tennessee-garage/dance-more/README.md

# dance-more
The next generation of the dancefloor

To get the repo running on your own machine (no floor needed), start with
[docs/getting-started.md](docs/getting-started.md).

Design docs live in [docs/](docs/README.md). To write an animation for the floor, start with [docs/animations.md](docs/animations.md).
