tennessee-garage/dance-more/docs/README.md

# Dance Floor v2 — Design & Architecture

A portable, light-up dance floor built from an 8×8 grid of independently
addressable acrylic **tiles**, driven by a layered controller hierarchy.

This `docs/` folder is the design home for the project. It is written to grow
incrementally — sections marked **Open Question** or **TBD** are deliberate
placeholders to be resolved as the design firms up.

## Contents

| Document | Covers |
| --- | --- |
| [architecture.md](architecture.md) | System overview, control hierarchy, block diagram, key counts |
| [communication.md](communication.md) | Bus topologies, RS-485 layering, addressing, SENSE auto-mapping protocol |
| [row-bus-protocol.md](row-bus-protocol.md) | Row Bus (Pi ↔ Row Controller) command protocol: frame format, command set, timing |
| [tile-bus-protocol.md](tile-bus-protocol.md) | Tile Bus (Row Controller ↔ Tile) command protocol: frame format, command set, timing |
| [tile-effects.md](tile-effects.md) | `SET_EFFECT` ids and parameters: tile-local effects over host pixel data, and why they exist |
| [external-input.md](external-input.md) | Driving the floor from outside: Art-Net / sACN pictures (modes, universes, orientation, takeover), the DMX control block, OSC, MIDI (the APC mini map, learn, the mapping file) and beat sync |
| [resolume.md](resolume.md) | A step-by-step guide for Resolume: visuals on the floor (Arena's DMX output), mixing with the floor's show, Ableton Link, and show control alongside |
| [touchdesigner.md](touchdesigner.md) | A step-by-step guide for TouchDesigner: pictures, the DMX control block, the HTTP API and Ableton Link, with an example show |
| [animations.md](animations.md) | Writing animations for the Pi driver: the contract, the two frame formats, the cell model, edges and the edge graph, params, the authoring loop |
| [hardware-tile.md](hardware-tile.md) | Tile: wood frame, acrylic, WS2815 LEDs, ATtiny3226, connectors |
| [hardware-row-controller.md](hardware-row-controller.md) | Row controller: Xiao RP2350, dual RS-485 buses, connectors |
| [power.md](power.md) | 12 V distribution and daisy-chain power architecture |
| [glossary.md](glossary.md) | Shared terminology |

## Repository map (current)

| Path | Purpose |
| --- | --- |
| `pcb/tile/` | KiCad project for the original tile controller PCB (ATtiny3224) |
| `pcb/tile-pcba/` | KiCad project for the JLCPCB-assembled tile PCB (ATtiny3226) — current |
| `pcb/row-controller/` | KiCad project for the row controller PCB |
| `src/tile/DF2-Tile/` | PlatformIO firmware for the ATtiny3226 tile controller |
| `src/simulation/` | Three.js/TypeScript acrylic light-propagation simulator |
| `src/native-simulator/` | Python (pyglet/numpy) light-propagation simulator |
| `docs/` | This design documentation |
