tennessee-garage/dance-more/pcb/tile/images/v1.2/tile-B_Silkscreen.pdf

A B

2026-06-18 v1.2 GND 12V GND Sin Sout

## Tile Dancefloor2

C6 R1 C5 R2
