tennessee-garage/dance-more/docs/external-input.md

# Driving the floor from a media server or a lighting desk

The floor listens for **Art-Net** (UDP 6454) and **sACN / E1.31** (UDP 5568,
unicast or multicast), so Resolume Arena, TouchDesigner, a lighting desk or
anything else that pixel-maps over DMX can send it pixels; and for **OSC**
(UDP 7000) and **MIDI**, so the same programs - and hardware controllers -
can run its show controls. Everything below is set in the web UI's
**External** tab (`df2-pi serve`), and stored.

## Network

- **Wire the Pi into the lighting network.** Art-Net over Wi-Fi drops and
  stutters.
- Point the sender at the Pi's IP (unicast), or use broadcast. For sACN,
  multicast works too: the floor joins the group of every universe it
  listens to.
- The floor answers **ArtPoll**, so it appears in a sender's node list as
  "Dance Floor". The node report shows the mode and universe count.

## Choosing a mode

| Mode | What the sender sends | Universes | Use it when |
| --- | --- | --- | --- |
| **Tile** (default) | 64 RGB pixels: one colour per tile | 1 | You want it working in five minutes. An 8×8 fixture grid in any software |
| **Grid** | A W×H RGB image (default 34×34); the floor samples it at each LED | ⌈W·H / 170⌉ (34×34: 7) | Video content. Resolume's pixel map as a plain grid |
| **Raw** | Every LED, 3,840 RGB pixels in chain order | 23 | Exact per-LED control (TouchDesigner with the LED table) |

Pixels pack **170 to a universe** (510 channels) and never straddle one.
Universes run consecutively from the **first universe** you set: Art-Net
counts port-addresses from 0, sACN universes from 1.

**Orientation.** Tile and grid are raster order starting at the **top-left of
the floor as the preview shows it**. The preview puts the Pi's edge at the
bottom, so the first pixel is the far corner on the left. If the floor is
rotated (Settings → rotation), the picture turns with it, so a sender never
needs to know.

**Colour.** Values are used as sent: they are already gamma-encoded, as video
is. Leave the sender's output gamma or colour correction at 1.0 / off, or the
floor applies gamma twice.

## Source: what the floor shows

| Source | While there is signal | When the signal stops |
| --- | --- | --- |
| **External** (default) | The sender's picture takes over the floor | After the **timeout** (default 2 s), the playlist entry that was playing restarts |
| **Mix** | The sender's picture over the playlist, faded in by **Mix** | The picture is removed; the playlist carries on |
| **Internal** | Ignored | — |

A crashed or sleeping sender therefore never leaves the floor frozen or dark.
Brightness, blackout, the show controls (strobe, tint, …) and rotation all
apply to external content exactly as to the floor's own animations.

"External" is also an ordinary animation (id `external`), so you can put it in
a playlist or run it as a layer by hand. It shows the last frame received.

## Resolume Arena

**[resolume.md](resolume.md) is a step-by-step guide**: visuals on the floor,
mixing with its show, Ableton Link and show control, with the settings to
make. In short:

Arena, not Avenue: only Arena has DMX output.

1. In Arena's advanced output, add a DMX / Lumiverse output to the floor's IP
   (Art-Net, or sACN).
2. For **tile** mode, add a fixture of 64 RGB pixels, laid out 8×8. For
   **grid** mode, lay out W×H pixels to match the External tab (34×34 by
   default). Pixel order runs left to right and top to bottom, from the top-left.
3. Set the fixture's universe to the External tab's first Art-Net universe
   (0 by default).
4. Place the fixture over the part of the composition the floor should show.

Content advice: only about 21% of the floor's cells are LEDs (each tile is a
ring of 60 with a dark centre). Large soft shapes and colour fields read well;
thin lines and text disappear between the rings.

## TouchDesigner

**[touchdesigner.md](touchdesigner.md) is a step-by-step guide**: pictures,
the control block, the HTTP API and tempo, with networks to build. In short:

Use a **DMX Out CHOP** (Art-Net or sACN) at the floor's IP.

- **Tile / grid:** Resize the TOP to 8×8 (tile) or W×H (grid), then **TOP to
  CHOP** with RGB channels interleaved in raster order from the top-left. TOP
  to CHOP reads rows bottom-up by default, so flip vertically first.
- **Raw:** Download the LED table (External tab, or `df2-pi leds > leds.csv`).
  It lists every LED in wire order with `u,v` (0–1, origin bottom-left, which
  is TouchDesigner's texture convention) and its universe and channel. Sample
  your TOP at those `u,v` positions and send the result in `index` order.

## Lighting desk control

The floor can also be patched as an **18-channel fixture**, so a desk (grandMA,
Chamsys, QLC+) or a media server's DMX output can dim it, strobe it and pick
programs. It is **off by default**: turn it on in the External tab's DMX
control section and set its universe (Art-Net and sACN separately) and start
address (default 201).

| Ch | Function | Values |
| --- | --- | --- |
| 1 | Master dimmer | 0 dark .. 255 full |
| 2 | Strobe | 0 off, 1..255 up to the strobe cap (Settings, default 10 Hz) |
| 3 | Source | 0–84 internal, 85–169 external, 170–255 mix |
| 4 | External mix | how much of the sender's picture, in mix |
| 5 | Bank | playlist N, **in name order**, from 0 |
| 6 | Program | entry N of that playlist, from 0 |
| 7 | Speed | 0 stop, 128 = 1×, 255 = 4× |
| 8–11 | Macro 1–4 | the playing animation's macros |
| 12–14 | Tint red, green, blue | the tint colour |
| 15 | Tint amount | 0 off .. 255 fully the tint |
| 16 | Bump | a white flash of value/255 each time it rises |
| 17 | Hold | 0–127 the countdown runs, 128–255 the playing entry plays on (the web UI's Hold) |
| 18 | Palette | the floor palette: N counts the built-ins in order (rainbow, fire, ice, ocean, sunset, forest, neon, candy, night), then your own by name |

- **Continuous controls follow the faders.** Dimmer, strobe, source, mix,
  speed and tint take effect on the first packet, then on every change.
- **Triggers act only on change.** Bank, program, macros, bump and palette never act on
  the first packet, so a desk that connects with them at 0 doesn't reload the
  playlist or flash the floor. Changing either bank or program goes to that
  entry.
- **Hold acts on crossing 128.** On the first packet it acts only if it is
  up, so a desk connecting with it down doesn't release a hold set from the
  web UI. Released, the entry finishes what was left of its countdown.
- **When the desk goes quiet for the timeout** (the same one as the pixels),
  dimmer, strobe, speed, tint, source and mix return to their settings, and
  a hold the desk applied is released. What bank and program loaded stays
  loaded.
- **Keep it out of a pixel universe.** A media server sending tile mode
  usually sends all 512 channels, zeros included, and zero on channel 1
  blacks out the floor. The External tab warns when the two share a universe.

For QLC+, import [fixtures/dance-floor-v2.qxf](fixtures/dance-floor-v2.qxf)
(`df2-pi fixture` regenerates it from the code). For other desks, build a
18-channel generic fixture from the table above.

## OSC

The floor also takes **OSC** on **UDP port 7000** - TouchDesigner's native
control protocol, something Resolume can send, and what phone apps like
TouchOSC speak. It covers the floor's show controls and more: send a message
to the floor's address and it acts. It is on by default; the External tab's
**OSC** section turns it off, changes the port, and shows the last 20
messages received - with any the floor didn't understand marked - which is
the quickest way to see what a sender is actually sending.

| Address | Values | Does |
| --- | --- | --- |
| `/floor/brightness` | f | Master brightness |
| `/floor/blackout` | on | Black out, or lift it |
| `/floor/speed` | f | 0 stopped, 0.5 normal, 1 four times |
| `/floor/strobe` | f | 0 off … 1 the strobe cap |
| `/floor/bump` | [f] | A flash toward white, as strong as f (1 if none) |
| `/floor/tint` | r g b amount | Tint toward a colour, each 0..1 |
| `/floor/hue` | f | Turn every hue, in turns |
| `/floor/saturation` | f | 0 grey, 0.5 normal, 1 vivid |
| `/floor/freeze` | on | Hold the picture while time runs on |
| `/floor/hold` | on | Keep the playing animation until released |
| `/floor/reset` | press | Show controls back to normal |
| `/floor/source` | f or s | Thirds - internal, external, mix - or the name |
| `/floor/mix` | f | How much external picture, in mix |
| `/floor/next`, `/floor/previous`, `/floor/restart` | press | Move through the playlist |
| `/floor/goto` | i | Go to playlist entry i (from 0) |
| `/floor/goto/<entry>` | press | The same, with the entry in the address |
| `/floor/playlist` | i or s | Load a playlist by id or name |
| `/floor/playlist/<name>` | press | The same, by address |
| `/floor/play` | s | Play an animation by id (`waves`, `lightning`, …) |
| `/floor/play/<animation>` | press | The same, by address |
| `/floor/palette` | i or s | The floor palette: its number in the Palettes tab, or its name |
| `/floor/palette/<name>` | press | The same, by address |
| `/floor/param/<name>` | f | The playing animation's parameter, 0..1 across its range |
| `/floor/macro/<n>` | f | The playing animation's macro 1–4 |
| `/floor/trigger` | i [f] | Trigger slot i, velocity f (1 if none; 0 is ignored) |
| `/floor/trigger/<slot>` | [f] | The same, by address |
| `/floor/tempo/tap`, `/floor/tempo/resync` | press | Tap tempo; make the next beat a downbeat |
| `/floor/tempo/nudge` | f | Shift the beat by f milliseconds |

- **f** is a float, 0..1 unless the table says otherwise; ints work too.
  **on** is any number - on at 0.5 and up - or nothing, for on.
- **press** addresses fire on a message with no value, or on a value of 0.5
  or more: a rise from below 0.5, or one more than 0.3 s after the last. So
  a button sending 1 then 0 fires once, a sender that only ever sends 1
  fires on every press, and one repeating 1 every frame while held fires
  once.
- **The path forms** (`/floor/palette/ocean`) are for senders that choose
  the address but not the value - a Resolume clip sends 1 when it launches,
  whatever it is set to say.

**Feedback.** Send `/floor/subscribe` with a port number and the floor sends
its state back to your address on that port: every value at once, then each
change - `/floor/state/animation` (s), `/floor/state/playlist` (s),
`/floor/state/entry` (i), `/floor/state/palette` (s),
`/floor/state/brightness` (f), `/floor/state/blackout` (i),
`/floor/state/held` (i), `/floor/state/tempo` (f) and `/floor/state/beat`
(i). Renew the subscription at least once a minute; it lapses after 60 s.

## MIDI

The floor takes **MIDI** from any controller plugged into the Pi's USB, and
from anything else that reaches it as a MIDI port. Each control is bound to
one of the [OSC addresses](#osc) - a fader on `/floor/brightness` does exactly
what the OSC message would - and the External tab's **MIDI** section shows
the devices it is listening to, the last messages and what each one did, the
bindings, and **MIDI learn**. Devices are picked up as they are plugged in
and let go when they are unplugged.

### The APC mini, out of the box

The first time the floor runs it writes a mapping for the **Akai APC mini**
(mk1 or mk2):

| Control | Does |
| --- | --- |
| Pad rows 1–2 (bottom) | Go to playlist entries 0–15 |
| Pad row 3 | Palettes: rainbow, fire, ice, ocean, sunset, forest, neon, candy |
| Pad row 4 | Triggers 0–7, as hard as the pad is hit |
| Pad row 5 | Play Lightning, Ripple, Waves, Stardust, Comet Squares, Vortex, Chase, Twin Peaks |
| Pad rows 6–8 | Free, for MIDI learn |
| Faders 1–4 | The playing animation's macros 1–4 |
| Faders 5–8 | Speed (halfway is normal), strobe, mix, hue |
| Master fader | Brightness |
| Track buttons | Previous, next, restart, bump, blackout (toggle), freeze (toggle), hold (toggle), reset |
| Scene buttons | Tap tempo, resync, nudge −10 ms, nudge +10 ms, half speed, normal speed, double speed, strobe off |

Any other controller works too: bind its controls with MIDI learn, or edit
the mapping file.

### MIDI learn

In the External tab's MIDI section, type the address a control should send to
(suggestions appear as you type), tick **Toggle** for on/off things like
blackout, or give a **Fixed value** to send on each press (a speed preset),
and press **Learn**. Then move the knob or hit the pad: it is bound, replacing
whatever that control did before, and saved.

### The mapping file

Bindings live in **`midi.yaml` beside the floor's database**
(`~/.local/share/df2/midi.yaml` on the Pi; `$DF2_MIDI_MAP` overrides). It is
kept out of `~/dance-floor` so syncing code to the Pi never wipes a mapping
learned there. Edit it by hand and the floor picks the change up within a
couple of seconds; a file that doesn't parse is reported in the External tab
and the last good mapping stays in use.

```yaml
program_change: true   # Program Change + Bank Select: bank = playlist, program = entry
clock: true            # MIDI clock to beat sync
bindings:
  - {note: 0, to: /floor/goto/0}                    # a pad: velocity 0..1 on press, 0 on release
  - {cc: 48, to: /floor/macro/1}                    # a fader or knob: 0..127 as 0..1
  - {cc: [7, 39], to: /floor/speed}                 # a 14-bit pair: MSB, LSB
  - {note: 68, to: /floor/blackout, toggle: true}   # each press flips it
  - {note: 86, to: /floor/speed, value: 0.25}       # each press sends this
  - {note: 3, to: /floor/bump, channel: 10, port: launchpad}   # only channel 10, only a port named like that
```

**Program Change** loads playlist *bank* (from 0, in name order, set by Bank
Select CC0/CC32 beforehand; 0 if never sent) if it isn't loaded, and goes to
entry *program* - quantized to the beat or bar like any launch (see
[Beat sync](#beat-sync)). **MIDI clock** feeds beat sync when its source is
set to *MIDI clock*.

### MIDI from a laptop

For Resolume, TouchDesigner or a DAW on a laptop, [OSC](#osc) is simpler: it
goes over the network with nothing to install. For MIDI, the laptop needs to
appear on the Pi as a MIDI port:

- **A USB-MIDI interface** on each end, joined by a MIDI cable, appears as a
  device like any controller.
- **Network MIDI (RTP-MIDI)** needs `rtpmidid` running on the Pi (its
  releases on GitHub include Debian packages). On a Mac, open **Audio MIDI
  Setup → MIDI Studio → Network**, create a session and connect it to the
  Pi; the session then shows up as one of the floor's MIDI devices. *This
  route hasn't been tried with the floor yet.*

On a Mac running `df2-pi serve` itself, plug controllers in **before**
starting it: macOS only tells a long-running program about devices that were
there when it started. The Pi has no such limit.

## Beat sync

The floor can follow the music's tempo: animations get `ctx.beat` (see
[animations.md](animations.md#4-framecontext)), and launches can wait for the
beat. Set it up in the External tab's **Beat sync** section; it is off by
default.

- **Ableton Link** is the one to use with Resolume, TouchDesigner, Ableton or
  DJ software: turn on Link in the other app, on the same network, and pick
  Ableton Link here. It carries tempo, beat and bar with no extra hardware.
  The section shows the tempo and how many peers it sees; with no peers there
  is no beat (Link alone would just run at its own 120 BPM). *Beats per bar*
  is Link's quantum.
- **Tap tempo**: tap along, from the section or the Tap button that appears in
  the transport bar. The tempo is the mean of the last four taps and the last
  tap is beat 1 of a bar. A single tap after a pause re-phases at the same
  tempo.
- **MIDI clock** is in the code (24 PPQN, Start / Continue / Stop / Song
  Position) and arrives as a choice here with MIDI input (#131).

**Tempo without a source** (default 120 BPM) is what beat-locked
animations run at whenever there is no beat, so they still move sensibly.

Live controls: **Resync** makes the next beat a downbeat, **−10 / +10 ms**
nudge the beat earlier or later on the floor, and **½× / 1× / 2×** halve or
double the tempo for animations.

**Latency offset.** Each frame's beat is worked out for the moment the frame
is latched; the offset adds the rest of the way to the LEDs. Play something
with a hard kick, watch the floor, and raise the offset until the lights land
on the kick rather than after it.

**Quantize launches** (off / beat / bar). With a beat, Next, Previous, going
to an entry, loading a playlist and one-offs wait for the next beat or bar
line and land on the frame that crosses it; the transport bar says when one
is waiting. Entry durations are not quantized. With no beat they happen at
once, and *bar* falls back to the beat until the bar is known.

## Checking it works

The External tab shows **Live** with the sender's address and frame rate,
frames and packets received, and polls answered. "Showing" says what the floor
is actually doing: `external`, `mix`, or `internal` when there is no signal.
Nothing arriving while the sender says it is sending usually means one of
these:
- a different universe;
- a firewall;
- the sender on the wrong network interface;
- (for sACN) multicast not reaching the Pi. Try unicast.
