tennessee-garage/dance-more/pcb/row-controller/images/v1.1/composite-pcb.png

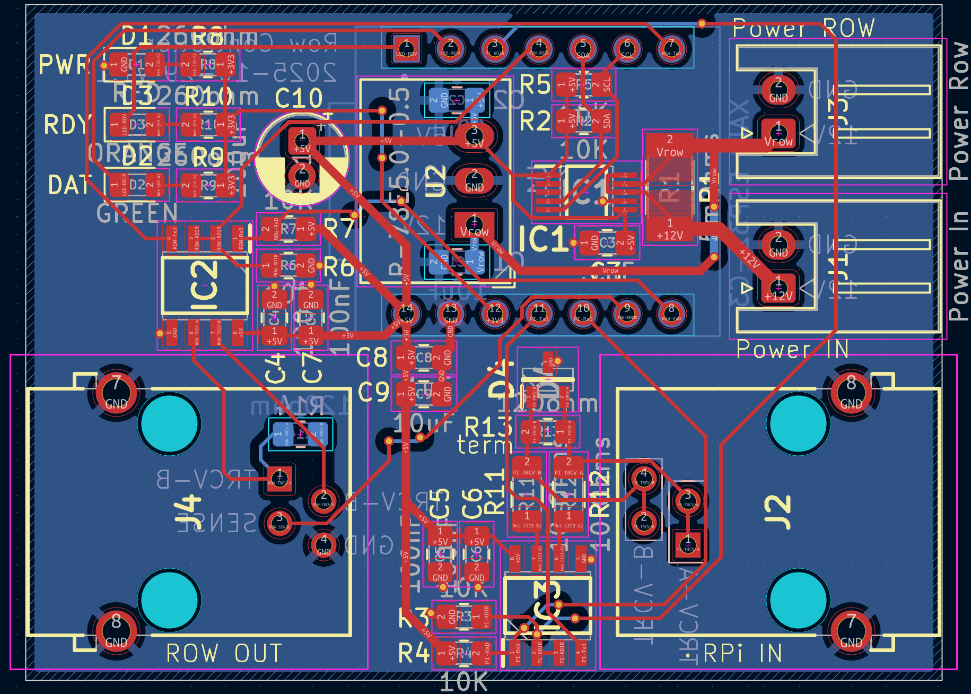
pcb/row-controller/images/v1.1/composite-pcb.png
