tennessee-garage/dance-more/pcb/tile/images/v1.2/composite-pcb.png

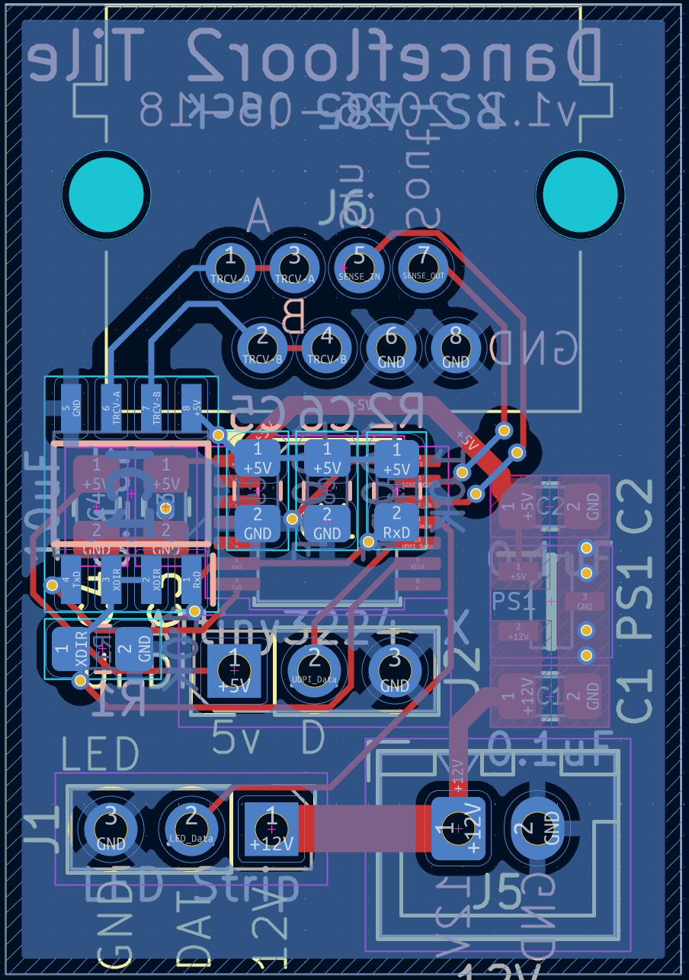
pcb/tile/images/v1.2/composite-pcb.png
