tennessee-garage/dance-more/pcb/pi-hat/pi-hat.csv

Reference | Value | Datasheet | Footprint | Qty | Manufacturer_Name | Manufacturer_Part_Number | Mouser Part Number | Mouser Price/Stock
C5,C6 | 100nF |  | Capacitor_SMD:C_0805_2012Metric_Pad1.18x1.45mm_HandSolder | 2
D4 | CDSOT23-SM712 | https://www.mouser.com/datasheet/3/40/1/CDSOT23_SM712.pdf | Garth:SOT95P230X117-3N | 1 | Bourns | CDSOT23-SM712 | 652-CDSOT23-SM712 | https://www.mouser.co.uk/ProductDetail/Bourns/CDSOT23-SM712?qs=FuI%252BOVLl4%2FLTY%2FGQ265RLA%3D%3D
IC3 | THVD1420DR | https://www.ti.com/lit/ds/symlink/thvd1420.pdf?ts=1627460855173 | THVD1420DR:SOIC127P600X175-8N | 1 | Texas Instruments | THVD1420DR | 595-THVD1420DR | https://www.mouser.co.uk/ProductDetail/Texas-Instruments/THVD1420DR?qs=iLbezkQI%252Bsio9fbTvISdEg%3D%3D
J1 | GPIO |  | Connector_PinSocket_2.54mm:PinSocket_2x20_P2.54mm_Vertical | 1
J3 | NC3FBH2 | https://www.neutrik.com/media/8348/download/st-nc3fbh2.PDF?v=2 | Garth:NC3FBH2 | 1 | Neutrik | NC3FBH2 | 568-NC3FBH-2 | https://www.mouser.co.uk/ProductDetail/Neutrik/NC3FBH2?qs=jCymNF74TgXGfwMkwZ3wrQ%3D%3D
R3,R4 | 10K |  | Resistor_SMD:R_0805_2012Metric_Pad1.20x1.40mm_HandSolder | 2
R11,R12 | 10 Ohms |  | Resistor_SMD:R_1206_3216Metric_Pad1.30x1.75mm_HandSolder | 2
R13 | 120 Ohms |  | Resistor_SMD:R_1206_3216Metric_Pad1.30x1.75mm_HandSolder | 1
