tennessee-garage/dance-more/models/Tile Controller Case.3mf

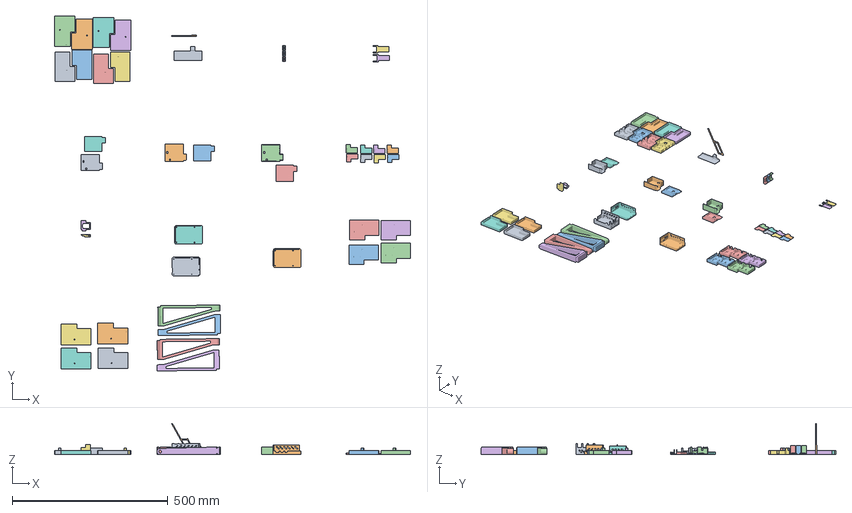
[picture p6: CAD file, 2026-10-21]
models/Tile Controller Case.3mf
1143.6 x 1139.4 x 100.9 mm
Bottom Case.stl x 8
Case Lid.stl x 8
Mat.stl
handle.stl
test jig.stl x 3
ribbon holder.stl x 2
Bottom.stl x 5
Top.stl x 4
Body1.stl x 5
Body11.stl x 4
Body2.stl
leg - hollow.stl x 4
