tennessee-garage/dance-more/pcb/pi-hat/pi-hat-model.step

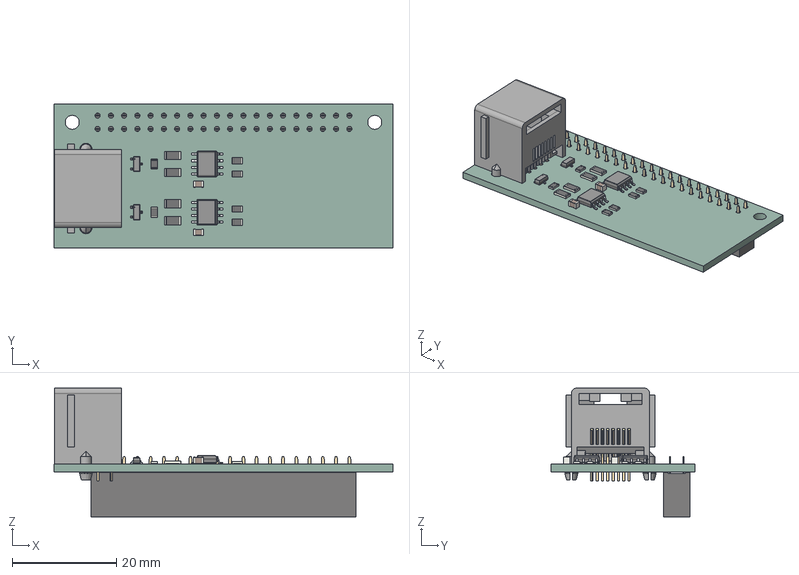
[picture p7: CAD file, 2026-09-27]
pcb/pi-hat/pi-hat-model.step
65.0 x 27.6 x 24.7 mm
MJ3225-88-0_PART1
R_1206_3216Metric x 4
C_0805_2012Metric x 2
R_0805_2012Metric x 6
BODY-SO x 2
LEAD-D0008A x 16
PinsArrayL x 2
FilletPinR x 2
PinSocket_2x20_P2.54mm_Vertical
pi-hat_PCB
