tennessee-garage/dance-more/pcb/row-controller/Anderson_Powerpole_PP15_PP45.STEP

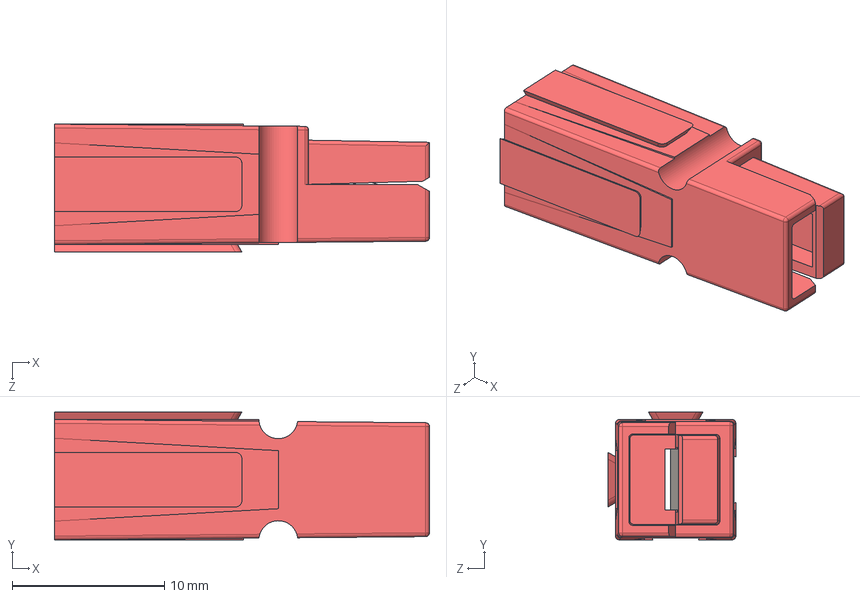
[picture p8: CAD file, 2026-09-14]
pcb/row-controller/Anderson_Powerpole_PP15_PP45.STEP
24.6 x 8.38 x 8.38 mm
