tennessee-garage/dance-more/pcb/tile-pcba/tile-model.step

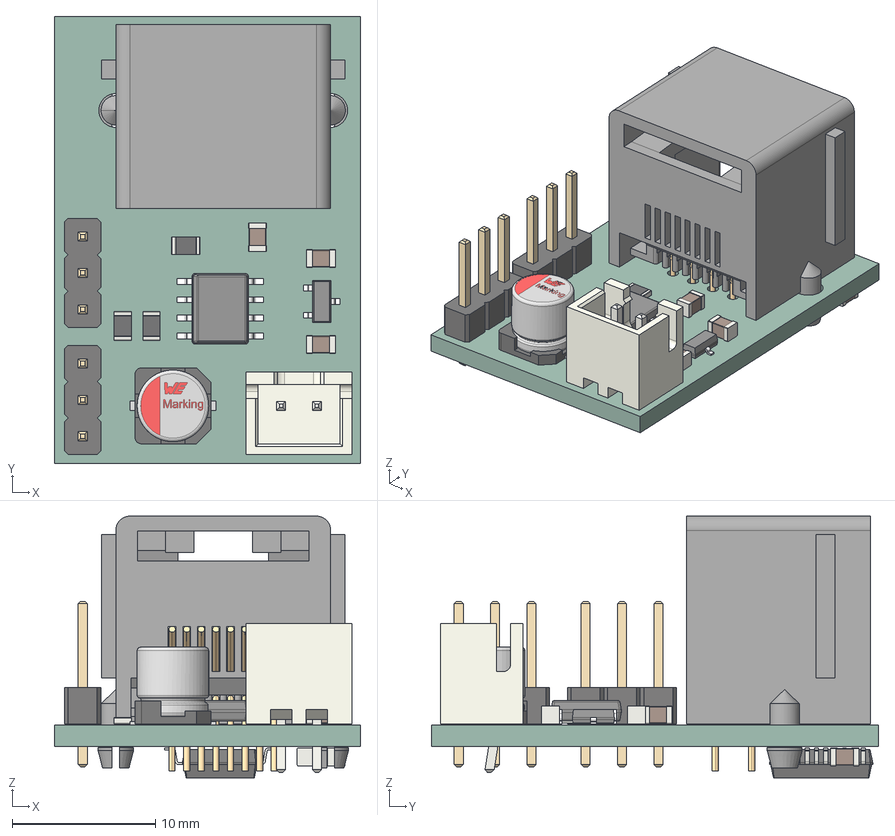
[picture p9: CAD file, 2026-09-06]
pcb/tile-pcba/tile-model.step
21.4 x 31.2 x 18.3 mm
capicitor_5x5.5x1.4
Base_Φ5Capacitor
BODY-SOT
LEAD-SOT x 3
PIN1-ID
TIEBAR
C_0805_2012Metric x 5
R_0805_2012Metric x 3
BODY-SO
LEAD-D0008A x 8
PinHeader_1x03_P2.54mm_Vertical x 2
MJ3225-88-0_PART1
JST_XH_B2B-XH-A_1x02_P2.50mm_Vertical
SSOP-20_5.3x7.2mm_P0.65mm
tile-pcba_PCB
