tennessee-garage/dance-more/pcb/row-controller/row-model.step

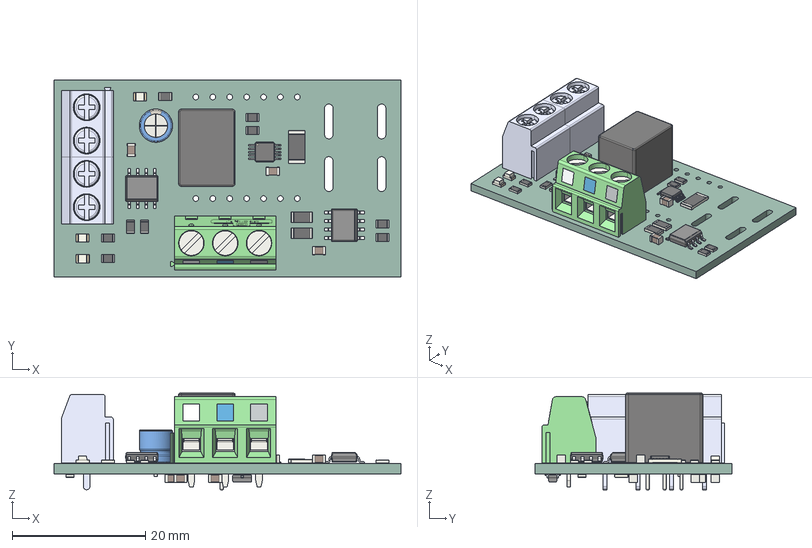
[picture p10: CAD file, 2026-09-14]
pcb/row-controller/row-model.step
52.1 x 29.5 x 14.5 mm
LED_0805_2012Metric x 3
R_0805_2012Metric x 11
Converter_DCDC_RECOM_R-78E-0.5_THT
C_0805_2012Metric x 7
CP_Radial_D5.0mm_P2.00mm
R_2010_5025Metric
BODY-SO x 2
LEAD-D0008A x 16
R_1206_3216Metric x 2
TSSOP-10_3x3mm_P0.5mm
TB003-500-02P_Blue - P x 2
PinsArrayL
FilletPinR
row-controller_PCB
