tennessee-garage/dance-more/docs/measurements/README.md

# Measurements

Hardware characterization data — not design docs, not test results. Each
measurement here is real numbers pulled off real hardware with a specific
tool, kept alongside that tool so the measurement can be reproduced or
repeated on different hardware later.

## Brightness sweep (current vs. commanded intensity)

**Tool:** [`src/pi/test/integration/tile_brightness_sweep.py`](../../src/pi/test/integration/tile_brightness_sweep.py)

Steps `SET_COLOR` from 0-100% brightness in 5% increments for red, green,
blue, and white, and records the row controller's INA226 current at each
step (mean of several reads, first discarded as a settling sample). The
blacked-out baseline — row controller + tile quiescent draw, LEDs off — is
measured once up front and subtracted from every point, so the output
isolates what the commanded color/level actually costs rather than the
whole board's draw.

Requires a row controller running firmware built after
[`a3c283a`](https://github.com/tennessee-garage/dance-more/commit/a3c283a)
(the INA226 driver fix — see
[power_monitor_rp2350.cpp](../../src/row/src/rp2350/power_monitor_rp2350.cpp));
before that fix, current/power readings were inflated 8x and voltage read
0.4x true, so any sweep run against older firmware is not comparable to
what's here.

### Files

| File | What |
| --- | --- |
| `2026-08-16-brightness-sweep-df2-tile.csv` | Raw data: 85 rows (baseline + 21 steps × 4 colors) |
| `2026-08-16-brightness-sweep-df2-tile.html` | Self-contained interactive chart — open directly in a browser, no server needed |

### 2026-08-16 — `df2-tile` (this project's WS2815 tile, v1 PCB)

Row 0x00, single tile, bench supply at 12V. **Current draw tracks commanded
brightness, not how many color channels are lit** — red, green, blue, and
white sweeps land on nearly the same curve at every step, not just at full
white. Roughly linear from ~10% to 100% (consistent with PWM duty-cycle
dimming), with a softer knee below ~10%. Full-scale range: ~2 mA (level 0)
to ~418 mA (level 255) above the ~108 mA quiescent baseline.

Cross-check: total current at full white (baseline + delta) is ~526 mA,
close to the "~0.5 A measured" figure already in
[../power.md](../power.md) — that existing figure appears to be the
*total* reading (LEDs + row controller + tile), not LED current in
isolation as its own text suggests. Worth reconciling next time power.md is
touched.

## Row Bus ceilings, eight rows, no tiles (2026-09-15)

**Tools:** [`test_chain_saturation.py`](../../src/pi/test/integration/test_chain_saturation.py),
[`test_row_bus_scan.py`](../../src/pi/test/integration/test_row_bus_scan.py),
`df2-pi play`.

First run with all eight row controllers on the two-chain pi-hat. Confirms
the row-side ingest ceiling (25 fps passes, 27 fps watchdog-resets, limit is
bytes/s), shows the `ROW_BOOT` cause cannot see a watchdog reset, and times
the host at ~48 ms per floor update against a 33 ms budget — 20 ms of
pure-Python CRC and a pyserial `write()` that serialised the two chains,
both fixed the same day (19.2 ms after). With the host fixed, 20 fps is the
highest rate all eight rows sustain. Cabling is clean: zero CRC failures
over a 10-minute soak. Write-up in
[`2026-09-15-eight-row-bus-bringup.md`](2026-09-15-eight-row-bus-bringup.md),
raw logs alongside.

## Row DMA receive (2026-09-24)

**Tools:** [`test_chain_saturation.py`](../../src/pi/test/integration/test_chain_saturation.py),
`df2-pi play`.

Row firmware v6 receives the Row Bus by DMA. Row 0 kept up with a
worst-case chain at 30, 35, 45 and 50 fps (93 % of the wire) and ran a
10-minute 30 fps soak with no restarts or CRC failures; v5 failed at
27 fps. Then rolled out to all eight rows and re-verified floor-wide. Also
records an open tile problem: after playback some tiles ignore `BLACKOUT`
until a full-size frame unsticks them. Write-up in [`2026-09-24-row-dma-receive.md`](2026-09-24-row-dma-receive.md).

## Effect deaf windows (2026-09-27, #106)

**Tools:** bench scripts in [`2026-09-27-effect-deaf-windows/`](2026-09-27-effect-deaf-windows/).

Tiles running an effect were deaf for ~1.8 ms of every own-clock render: with
`CHASE`, 5% of small frames, 20% of full frames and ~9% of `BLACKOUT`s were
lost. Row v9 / tile v5 bring streamed frames and `BLACKOUT` over `CHASE` to 0;
`BLACKOUT` over a free-running `SHIMMER` still fails ~1% (#107). Write-up in
[`2026-09-27-effect-deaf-windows.md`](2026-09-27-effect-deaf-windows.md).

## Measuring a new strip or tile

```bash
# on the Pi, from src/pi/
python3 test/integration/tile_brightness_sweep.py --chain /dev/ttyAMA0:23 --label <name>

# two-chain hat (production wiring)
python3 test/integration/tile_brightness_sweep.py --row <N> --label <name>
```

`--label` becomes part of the output filename
(`{date}-brightness-sweep-{label}.csv`) so runs against different hardware
never collide. The script only writes the CSV — to get a chart, either open
the CSV in a spreadsheet, or ask for one to be built from it the way this
one was (see the HTML file here for the format: a single self-contained
page, series colored by literal RGB + a neutral for "white", baseline
subtracted, no external dependencies).
