tennessee-garage/dance-more/docs/measurements/2026-09-24-row-dma-receive.md

# Row DMA receive, 2026-09-24

Row firmware v6 (`v6+a1c5ad80`) on row 0; rows 1–7 still on v5 as real
neighbours on the same two chains. Row 0 had four tiles on its Tile Bus, two
of them with LED strips; the runs below the saturation table were first done
with none of them discovered (a plug wiring fault), then repeated with three
— see "With tiles forwarding". Tools and
bench as in [the 2026-09-15 bring-up](2026-09-15-eight-row-bus-bringup.md),
raw output in [`2026-09-24-row-dma-receive/`](2026-09-24-row-dma-receive/).

**Result: the row-side receive ceiling is gone.** Row 0 kept up with a
worst-case chain at 50 fps, 93 % of what the wire can carry, where v5 failed
at 27 fps.

## What changed in v6

- Row Bus receive moved off arduino-pico's `SerialUART` (~6 µs of CPU per
  byte) onto a DMA channel filling a 16 KB ring in RAM. Core 0 parses
  straight out of the ring.
- The parser drops other rows' frames itself, still CRC-checking them, so
  `CRC_FAILURE` keeps covering the whole chain.
- Core 0 handles at most 4 frames per `loop()` pass, so the watchdog is fed
  on every pass however busy the bus is (#100).

## Protocol conformance — `test_row_bus_scan.py`

20/20 on row 0, as on every v5 row; 10/10 broadcast.

## Saturation — `test_chain_saturation.py --row 0`

Full `SET_LEDS` frames to all four rows on chain 0 plus `LATCH`, 60 s per
rate:

| Target | Chain byte rate | Share of wire | Row 0 |
| --- | --- | --- | --- |
| 30 fps | 175 kB/s | 56 % | pass — no restart, no new log entries |
| 35 fps | 204 kB/s | 65 % | pass |
| 45 fps | 262 kB/s | 84 % | pass |
| 50 fps | 291 kB/s | 93 % | pass |

Uptime climbed monotonically from 97 s to 287 s across the four runs.

## Soak — `df2-pi play --animation plasma --fps 30 --frames 18000`

10 minutes through `Floor.send_rows()`, both chains: 18000 frames, 0
dropped, jitter p95 0.13 ms. Row 0's uptime went from 300 s to 903 s and
its error log was identical before and after — **zero CRC failures** with
every frame on the chain CRC-checked. The two `CRC_FAILURE` entries already
in it (counts 1 and 3) are the four corrupt frames the scan test sends on
chain 0.

The v5 rows boot-looped throughout, as expected at 30 fps; that has no
effect on row 0, which only listens.

## Not exercised

- **The bounded frame loop (#100).** It exists so an overloaded row keeps
  feeding its watchdog, but no load the wire can deliver overloads a v6
  row, so it could not be triggered here. It stays as a safeguard.
- **The Tile Bus tail at full load.** [row-bus-protocol.md](../row-bus-protocol.md)
  §8 puts the last row on each chain, forwarding to eight tiles, at ~33.6 ms
  against the 33.3 ms `LATCH`. Only the first row with three tiles was
  tested here (see below). That tail is now the binding constraint for
  30 fps with all `SET_LEDS`.

## With tiles forwarding

Row 0's four tiles were not discovered during the runs above: the SENSE line
in the row's Cat6 plug was wired wrong. Row 0's draw of ~315 mA at 11.71 V
through those runs, against 13–18 mA for a bare row, was the four powered
tiles, and nothing lit because no tile had an address to send to.

After the plug was rewired, `RE_DISCOVER` found tiles in slots 0–2 (tiles 0
and 1 with strips); slot 3 still did not answer `DETECT_SENSE`, so discovery
ended there. Slots 0 and 2 run tile firmware v2; slot 1 runs v2 from a dirty
tree (`02df35e3-dirty`). Rerun with row 0 forwarding to those three tiles:

| Run | Result |
| --- | --- |
| Saturation, 30 fps, 60 s | pass — no restart, 0 `LATCH_OVERRUN`, 0 `ROW_BUS_RX_OVERFLOW` |
| Saturation, 35 fps, 60 s | pass — same |
| `df2-pi play --animation plasma --fps 30`, 10 min | 18000 frames, 0 dropped, jitter p95 0.12 ms; uptime 434 → 1037 s; no new log entries; still 3 tiles discovered afterwards |

Row 0 read 1,093 mA at 11.27 V after the soak against 319 mA before it, so
the strips were receiving data (the last frame stays latched).

This is not the §8 worst case. Row 0's frame is first on its chain, so it
arrives by 4.7 ms and forwarding to three tiles is done long before `LATCH`.
The binding case — the last row on a chain forwarding to eight tiles — needs
a fully populated row to test.

## Rollout to all eight rows

After #102 merged, all eight rows were flashed from `main`:

| Check | Result |
| --- | --- |
| Addresses | each row answers only its own address on its own chain |
| `df2-pi version` | all eight on `v6+3a15f42b` |
| `ROW_BOOT` after the power cycle | cause `0x0001` on all eight — POR with no watchdog bit, correct for a power cycle (#101) |
| `test_row_bus_scan.py` | rows 1–7 20/20; row 0 20/20 with `--expect-tiles 3` |
| Saturation, row 6 (last on chain 0) | pass at 30 and 45 fps, 60 s each |
| Saturation, row 7 (last on chain 1) | pass at 30 and 45 fps |
| `df2-pi play --animation plasma --fps 30`, 10 min | 18000 frames, 0 dropped, jitter p95 0.13 ms; every uptime monotonic 306 → 909 s |

No row logged `ROW_BUS_RX_OVERFLOW` or `LATCH_OVERRUN`. Every `CRC_FAILURE`
entry predates the saturation runs and is accounted for by the two scan-test
runs' deliberately corrupt frames, so no frame on either chain failed its CRC
across the saturation runs and the soak.

The first flash of row 7 used the `row6` image: a board answered at `0x06`
on chain 1 and nothing at `0x07`. The Pi probes each address only on its own
chain, so the only symptom was row 7 missing. Probing every address on both
chains is what found it.

Not verified on hardware: the `ROW_BOOT` watchdog-timeout bit, because a v6
row cannot be made to reset by any load the wire carries.

## Open: tiles stop listening after playback

After `df2-pi play` ends, `BLACKOUT` often fails to darken some tiles, and
the last frame stays lit. Six 5-second `plasma` runs each followed by two
`BLACKOUT`s, measured by row 0's current (two strips lit ≈ 1,230 mA, dark ≈
310 mA):

| Result of both `BLACKOUT`s | Runs |
| --- | --- |
| both strips dark | 1 |
| one strip dark, one still lit (~790 mA) | 3 |
| neither strip dark | 2 |

A second `BLACKOUT` never changed the outcome. In five further runs, every
time `BLACKOUT` failed, one full-size `SEND_DATA` of black `SET_LEDS` plus
`LATCH` darkened every tile, and `BLACKOUT` worked normally after that. With
the tiles in a normal state, `BLACKOUT` and `SET_COLOR(0,0,0)` darkened a
grey floor every time (four of four).

That pattern — per-tile, cleared by enough following bytes but not by small
frames — is the signature of a frame parser stuck partway through a frame,
taking later frames as the rest of its payload. The row firmware has an
idle-gap reset for exactly this (`RX_IDLE_RESET_US` in
`pi_transport_rp2350.h`); the tile's `TransportAT::poll()` has none, so a
tile that loses bytes mid-frame stays deaf until enough bytes have passed.

**Cause (found 2026-09-25):** `df2-pi play` sends `BLACKOUT` and a `LATCH`
immediately after its final frame's `LATCH`. The row relays the first
`LATCH`, every tile starts pushing its LEDs with interrupts off (~1.8 ms),
and the row forwards the `BLACKOUT` frames straight into that deaf window.
Isolated on row 0 with four tiles:

| Test | Tiles left stuck |
| --- | --- |
| `LATCH` then `BLACKOUT` with no gap | 10/10 |
| `LATCH`, 5 ms, then `BLACKOUT` | 0/10 |
| 60 pipelined 32-byte `SET_COLOR` frames, each sent straight after the previous `LATCH`, then a delayed `BLACKOUT` | 9/10 |

The last row shows it is not only an exit problem: any frame whose data
reaches the tiles within ~2 ms of the previous `LATCH` is lost, which small
frames always do. Things ruled out on the way, each 0/10 stuck: brightness
(1.3 A of LEDs), `play`'s `SEND_DATA`/`LATCH` ordering with other content,
and replaying `play`'s exact captured payloads — through `send_data`, through
`send_rows` to all eight rows, and with rows 2, 4 and 6's frames on the chain.

Fixed in #104's PR: the row keeps the Tile Bus quiet for 4 ms after each
`LATCH` it sends, and the tile abandons a part-received frame after 5 ms of
silence ([tile-bus-protocol.md](../tile-bus-protocol.md), `LATCH`).

## Pitfall hit on the first flash

A DMA channel triggered in ENDLESS mode with a transfer count of 0 halts
immediately (RP2350 datasheet §12.6.2.2.1). The first v6 build encoded the
mode with a zero count, and row 0 booted, ran both cores and never received a
byte. ENDLESS does not decrement the count, so any non-zero value runs
forever; the fix is commented in `pi_transport_rp2350.cpp`.
