tennessee-garage/dance-more/docs/measurements/2026-08-16-brightness-sweep-df2-tile.csv

color | pct | level_0_255 | voltage_mV | current_mA | current_stdev_mA | power_mW | current_delta_mA | power_delta_mW
baseline | 0 | 0 | 11981 | 107.75 | 0.433 | 1295 | 0.0 | 0
red | 0 | 0 | 11980.8 | 107.75 | 0.433 | 1295 | 0.0 | 0
red | 5 | 13 | 11979.5 | 113.5 | 0.5 | 1365 | 5.75 | 70
red | 10 | 26 | 11976 | 129.75 | 0.433 | 1556.2 | 22.0 | 261.2
red | 15 | 38 | 11972.8 | 150.25 | 0.433 | 1805 | 42.5 | 510
red | 20 | 51 | 11968.8 | 173.25 | 0.829 | 2072.5 | 65.5 | 777.5
red | 25 | 64 | 11966 | 194.25 | 1.479 | 2331.2 | 86.5 | 1036.2
red | 30 | 76 | 11962.2 | 215.75 | 1.299 | 2583.8 | 108.0 | 1288.8
red | 35 | 89 | 11957.5 | 238.5 | 1.5 | 2858.8 | 130.75 | 1563.8
red | 40 | 102 | 11953.5 | 261 | 1.581 | 3130 | 153.25 | 1835
red | 45 | 115 | 11950 | 284.75 | 0.829 | 3398.8 | 177.0 | 2103.8
red | 50 | 128 | 11946.5 | 307.5 | 1.118 | 3675 | 199.75 | 2380
red | 55 | 140 | 11942.8 | 326.5 | 0.866 | 3906.2 | 218.75 | 2611.2
red | 60 | 153 | 11939 | 350.75 | 0.829 | 4190 | 243.0 | 2895
red | 65 | 166 | 11935.8 | 372 | 1.225 | 4445 | 264.25 | 3150
red | 70 | 178 | 11932.2 | 392.75 | 1.09 | 4681.2 | 285.0 | 3386.2
red | 75 | 191 | 11927.5 | 416 | 1.225 | 4967.5 | 308.25 | 3672.5
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
