tennessee-garage/dance-more/pcb/row-controller/images/v1.1/row-controller.pdf

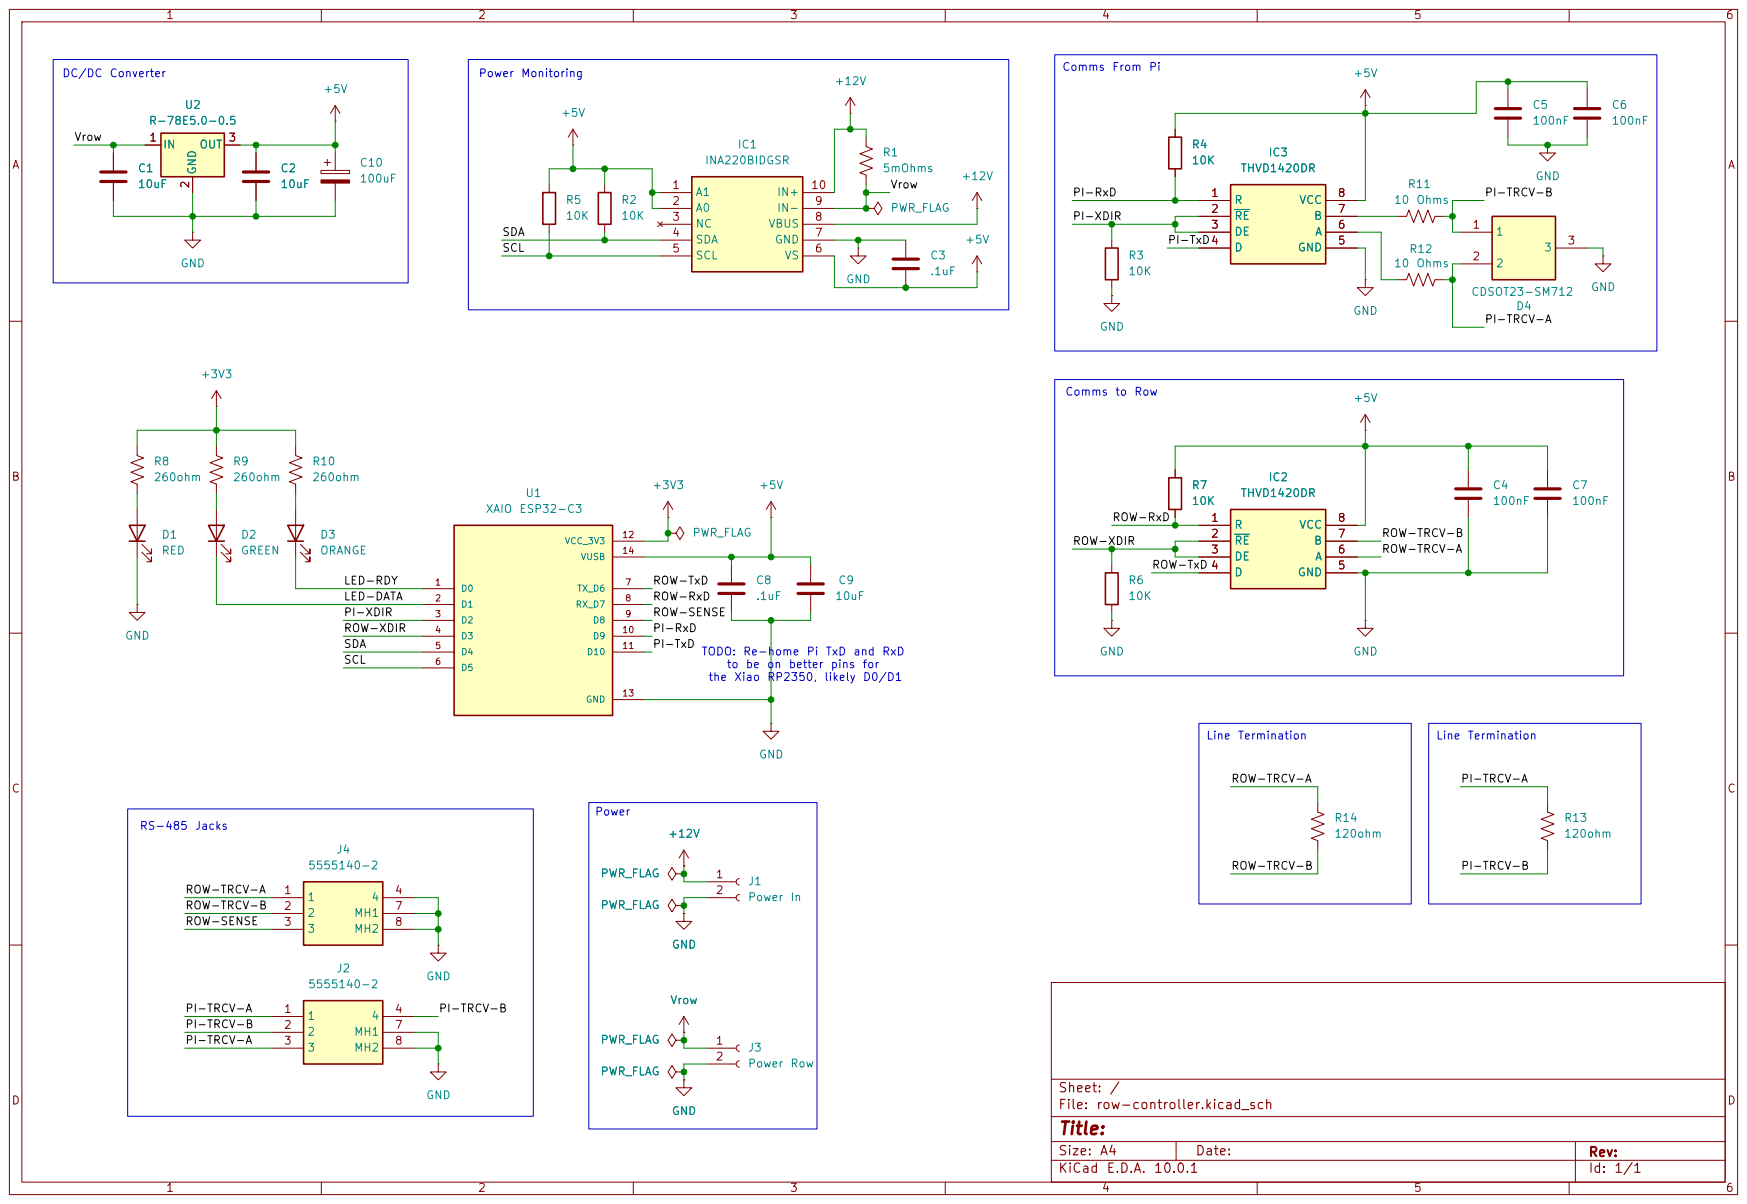
[picture p12: page 1]

PI-TRCV-A ROW-RxD
GND

ROW-SENSE SCL ROW-XDIR

to be on better pins for
the Xiao RP2350, likely D0/D1

Line Termination RS-485 Jacks

PI-TRCV-A ROW-TRCV-B

ROW-TRCV-A ROW-TRCV-B

PI-TRCV-A PI-TRCV-A PI-TRCV-B

Size: A4 | Rev:
KiCad E.D.A. 10.0.1 | Id: 1/1
