tennessee-garage/dance-more/pcb/tile/images/v1.2/tile.pdf

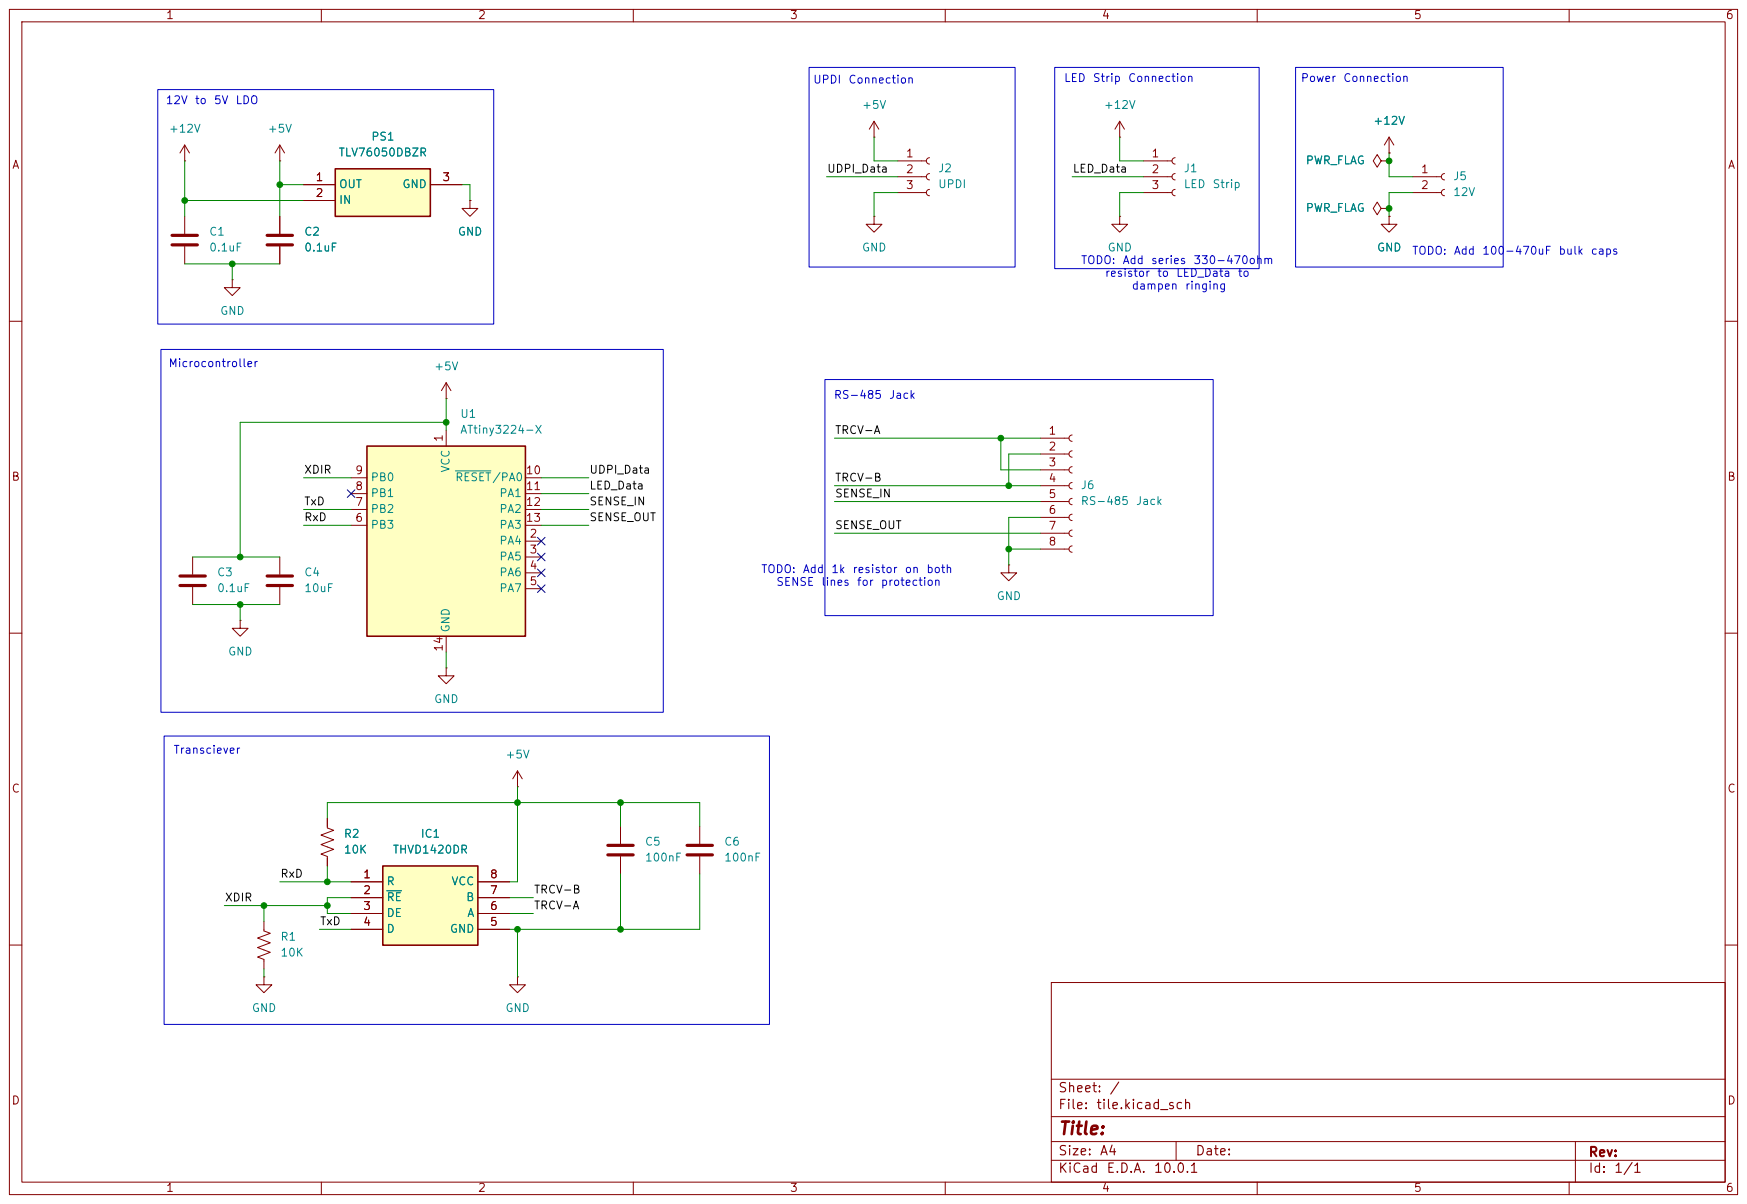
[picture p13: page 1]

Size: A4 | Rev:
KiCad E.D.A. 10.0.1 | Id: 1/1
