tennessee-garage/dance-more/docs/Label-Template-SL138.pdf

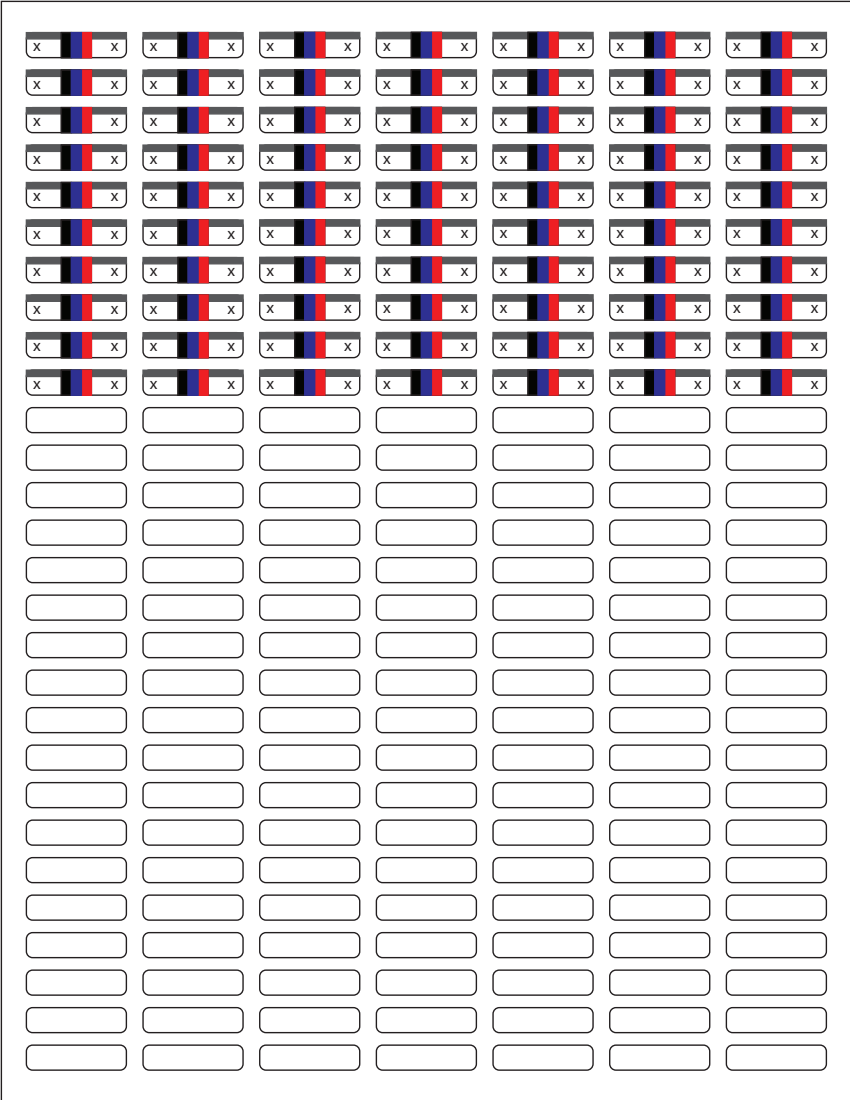
[picture p14: page 1]
