tennessee-garage/dance-more/pcb/tile/images/v1.2/tile-B_Cu.pdf

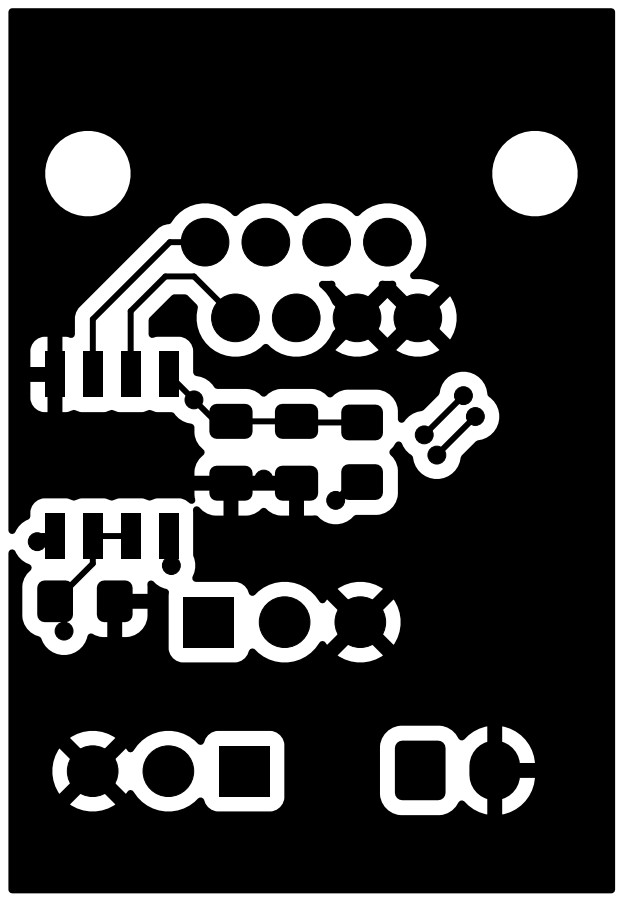
[picture p15: page 1]
