tennessee-garage/dance-more/pcb/tile/images/v1.2/tile-B_Mask.pdf

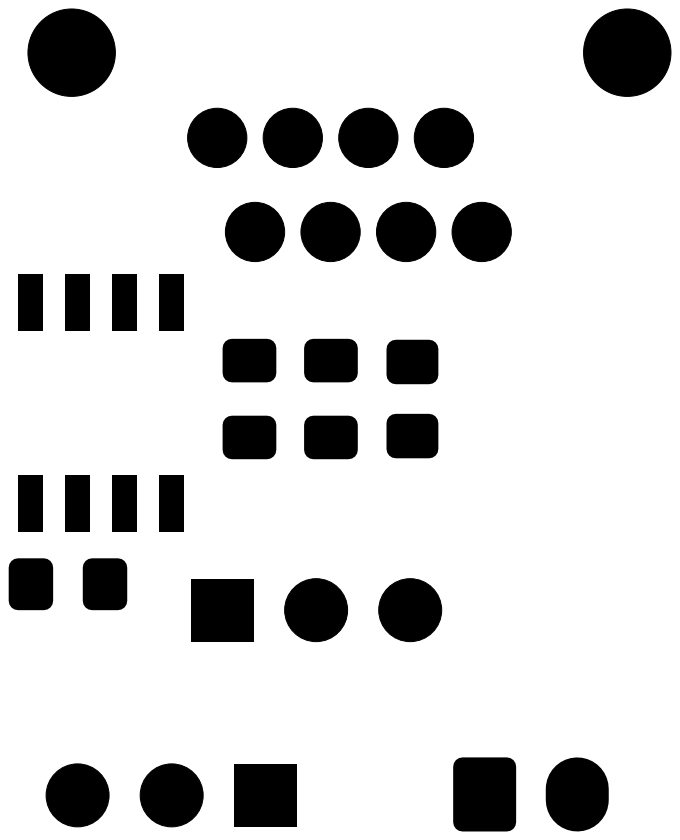
[picture p16: page 1]
