tennessee-garage/dance-more/pcb/tile/images/v1.2/tile-B_Paste.pdf

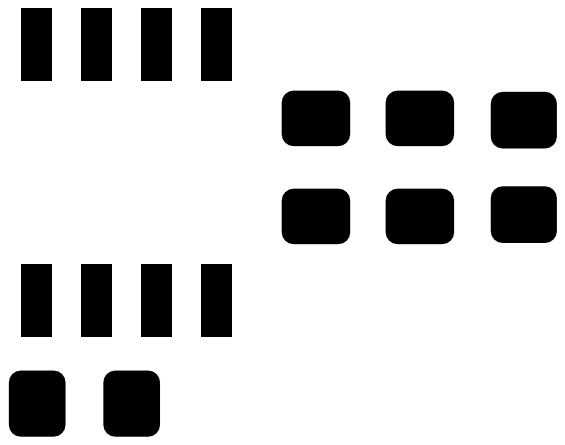
[picture p17: page 1]
