tennessee-garage/dance-more/pcb/tile/images/v1.2/tile-F_Cu.pdf

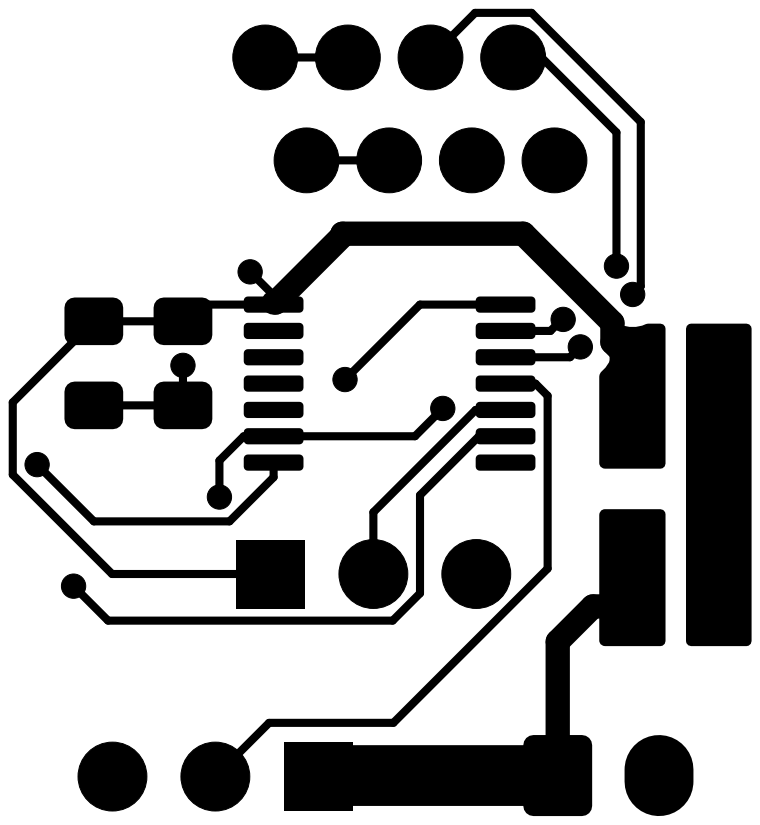
[picture p18: page 1]
