tennessee-garage/dance-more/pcb/tile/images/v1.2/tile-F_Mask.pdf

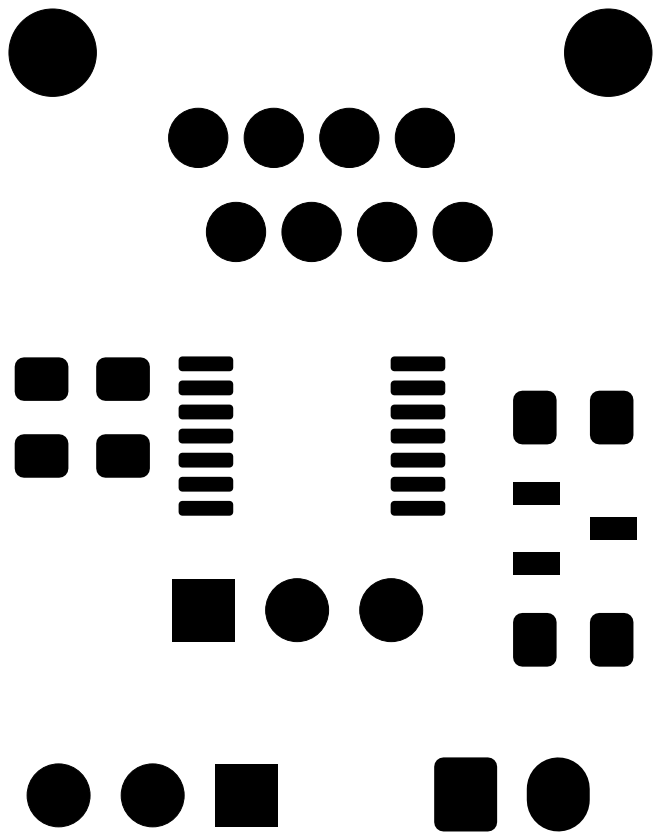
[picture p19: page 1]
