tennessee-garage/dance-more/pcb/tile/images/v1.2/tile-F_Paste.pdf

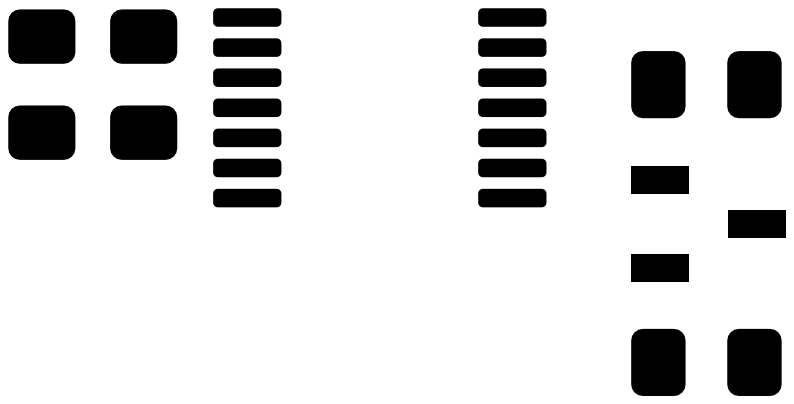
[picture p20: page 1]
