tennessee-garage/dance-more/pcb/tile/images/v1.2/tile-F_Silkscreen.pdf

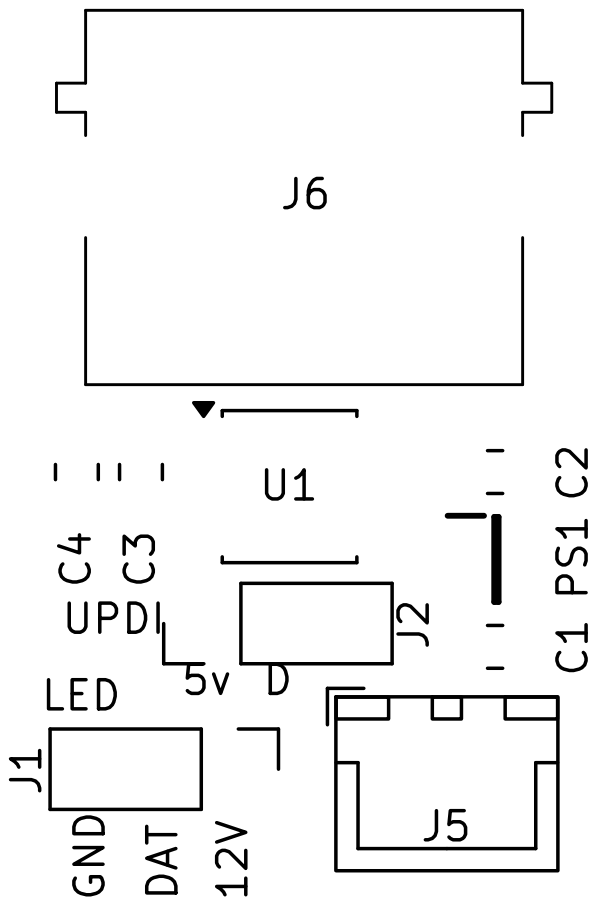
[picture p21: page 1]
