tennessee-garage/dance-more/pcb/row-controller/row-controller.kicad_pcb

## KiCad design pcb/row-controller/row-controller.kicad_pcb (2026-09-06)

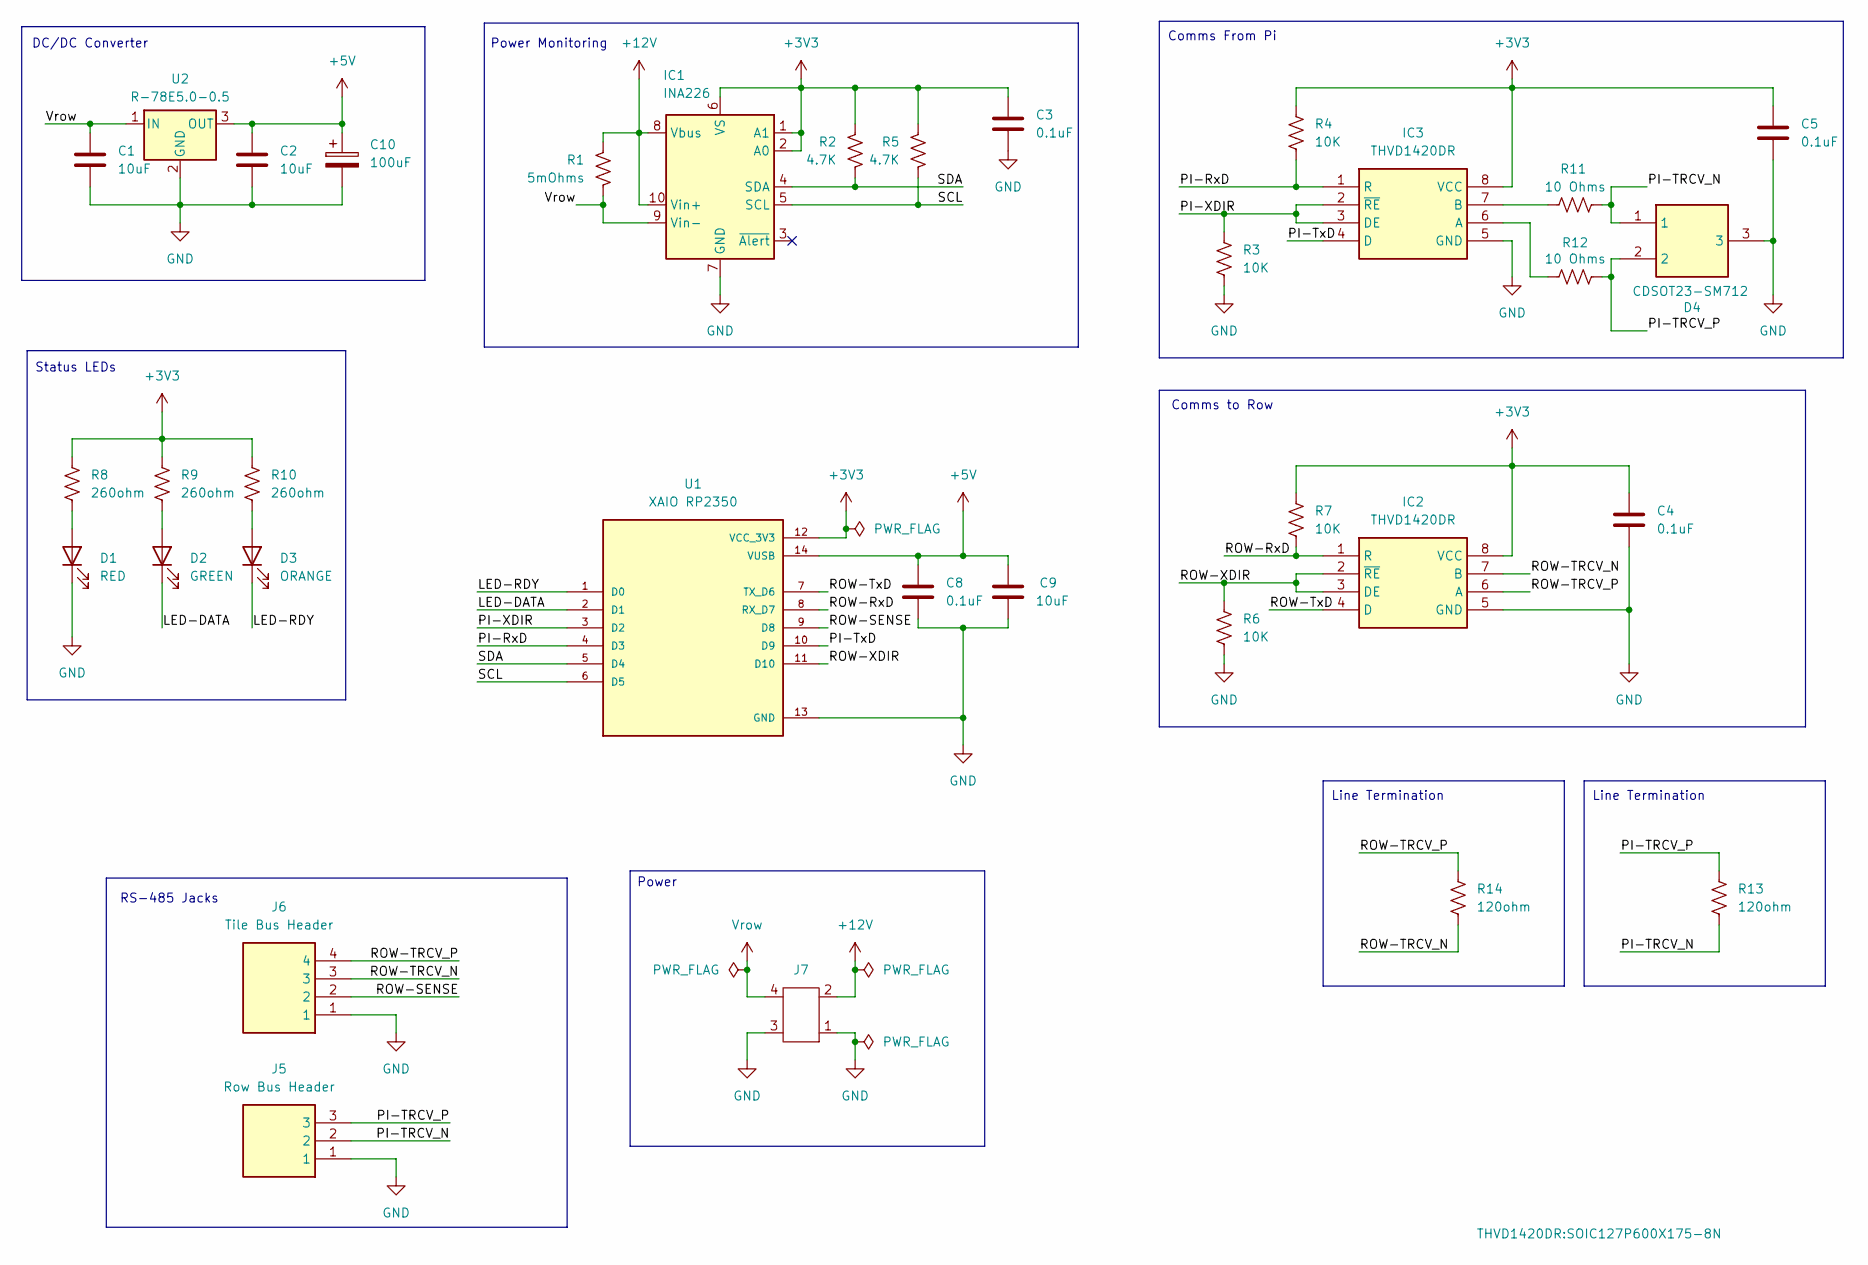
[picture p25: schematic row-controller.kicad_sch]

Parts:
C1, C2, C9: 10uF; C_0805_2012Metric_Pad1.18x1.45mm_HandSolder
C3, C4, C5, C8: 0.1uF; C_0805_2012Metric_Pad1.18x1.45mm_HandSolder
C10: 100uF; CP_Radial_D5.0mm_P2.00mm
D1: RED; LED_0805_2012Metric_Pad1.15x1.40mm_HandSolder
D2: GREEN; LED_0805_2012Metric_Pad1.15x1.40mm_HandSolder
D3: ORANGE; LED_0805_2012Metric_Pad1.15x1.40mm_HandSolder
D4: CDSOT23-SM712; SOT95P230X117-3N; Mouser Part Number 652-CDSOT23-SM712
IC1: INA226; TSSOP-10_3x3mm_P0.5mm; Mouser Part Number 595-INA220BIDGSR
IC2, IC3: THVD1420DR; SOIC127P600X175-8N; Mouser Part Number 595-THVD1420DR
J5: Row Bus Header; 1548129; Mouser Part Number 651-1548129
J6: Tile Bus Header; TB003-500-P04BE; Mouser Part Number 490-TB003-500-P04BE
J7: Quad Powerpole
R1: 5mOhms; R_2010_5025Metric_Pad1.40x2.65mm_HandSolder; Manufacturer Part Number LRMAT2010-R005FT4; Mouser Part Number 756-LRMAT2010R005FT4
R2, R5: 4.7K; R_0805_2012Metric_Pad1.20x1.40mm_HandSolder
R3, R4, R6, R7: 10K; R_0805_2012Metric_Pad1.20x1.40mm_HandSolder
R8, R9, R10: 260ohm; R_0805_2012Metric_Pad1.20x1.40mm_HandSolder
R11: 10 Ohms; R_1206_3216Metric_Pad1.30x1.75mm_HandSolder; Manufacturer Part Number CRCW120610R0FKEAHP; Mouser Part Number 71-CRCW120610R0FKEAH
R12: 10 Ohms; R_1206_3216Metric_Pad1.30x1.75mm_HandSolder
R13, R14: 120ohm; R_0805_2012Metric_Pad1.20x1.40mm_HandSolder
U1: XAIO RP2350; MODULE_113991054; PARTREV 23/05/2022; Mouser Part Number 713-102010550
U2: R-78E5.0-0.5; Converter_DCDC_RECOM_R-78E-0.5_THT; Manufacturer Part Number R-78E5.0-0.5; Mouser Part Number 919-R-78E5.0-0.5

Connections:
+3V3: C3.1, C4.1, C5.1, IC1.1 (A1), IC1.2 (A0), IC1.6 (VS), IC2.8 (VCC), IC3.8 (VCC), R2.1, R4.1, R5.1, R7.1, R8.1, R9.1, R10.1, U1.12 (VCC_3V3)
+5V: C2.1, C8.1, C9.1, C10.1, U1.14 (VUSB), U2.3 (OUT)
+12V: IC1.8 (Vbus), IC1.10 (Vin+), J7.2, R1.1
/LED-DATA: D2.1 (K), U1.2 (D1)
/LED-RDY: D3.1 (K), U1.1 (D0)
/PI-RxD: IC3.1 (R), R4.2, U1.4 (D3)
/PI-TRCV_N: D4.1, J5.2, R11.2, R13.2
/PI-TRCV_P: D4.2, J5.3, R12.2, R13.1
/PI-TxD: IC3.4 (D), U1.10 (D9)
/PI-XDIR: IC3.2 (~RE), IC3.3 (DE), R3.1, U1.3 (D2)
/ROW-RxD: IC2.1 (R), R7.2, U1.8 (RX_D7)
/ROW-SENSE: J6.2, U1.9 (D8)
/ROW-TRCV_N: IC2.7 (B), J6.3, R14.2
/ROW-TRCV_P: IC2.6 (A), J6.4, R14.1
/ROW-TxD: IC2.4 (D), U1.7 (TX_D6)
/ROW-XDIR: IC2.2 (~RE), IC2.3 (DE), R6.1, U1.11 (D10)
/SCL: IC1.5 (SCL), R5.2, U1.6 (D5)
/SDA: IC1.4 (SDA), R2.2, U1.5 (D4)
GND: C1.2, C2.2, C3.2, C4.2, C5.2, C8.2, C9.2, C10.2, D1.1 (K), D4.3, IC1.7 (GND), IC2.5 (GND), IC3.5 (GND), J5.1, J6.1, J7.1, J7.3, R3.2, R6.2, U1.13 (GND), U2.2 (GND)
unnamed: D1.2 (A), R8.2
unnamed: D2.2 (A), R9.2
unnamed: D3.2 (A), R10.2
unnamed: IC3.6 (A), R12.1
unnamed: IC3.7 (B), R11.1
Vrow: C1.1, IC1.9 (Vin-), J7.4, R1.2, U2.1 (IN)

Notes on the sheet:
Power Monitoring
Line Termination
Power
Comms to Row
Status LEDs
Comms From Pi
DC/DC Converter
RS-485 Jacks

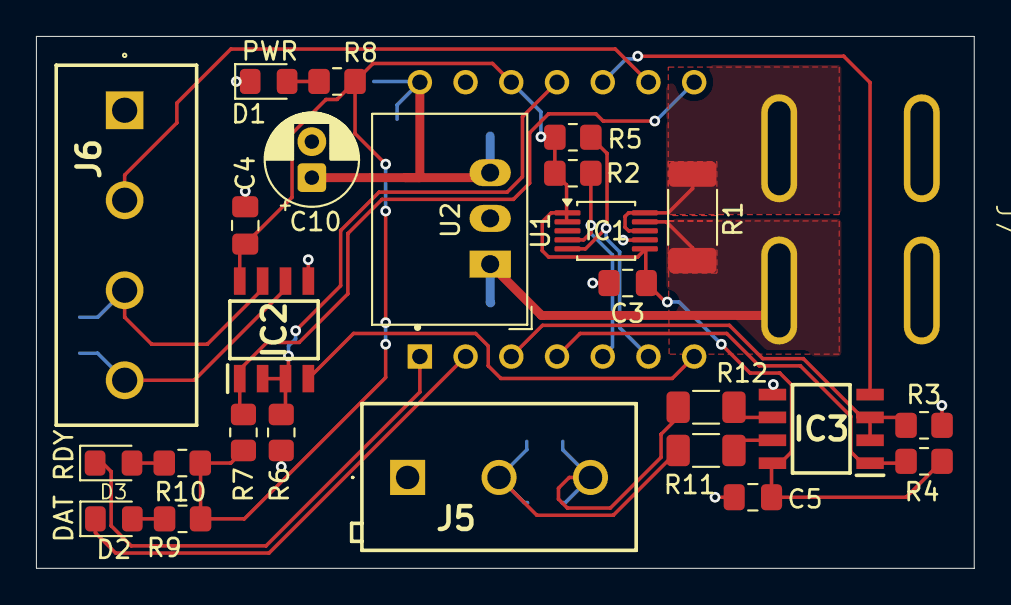
[picture p26: board row-controller.kicad_pcb from above]

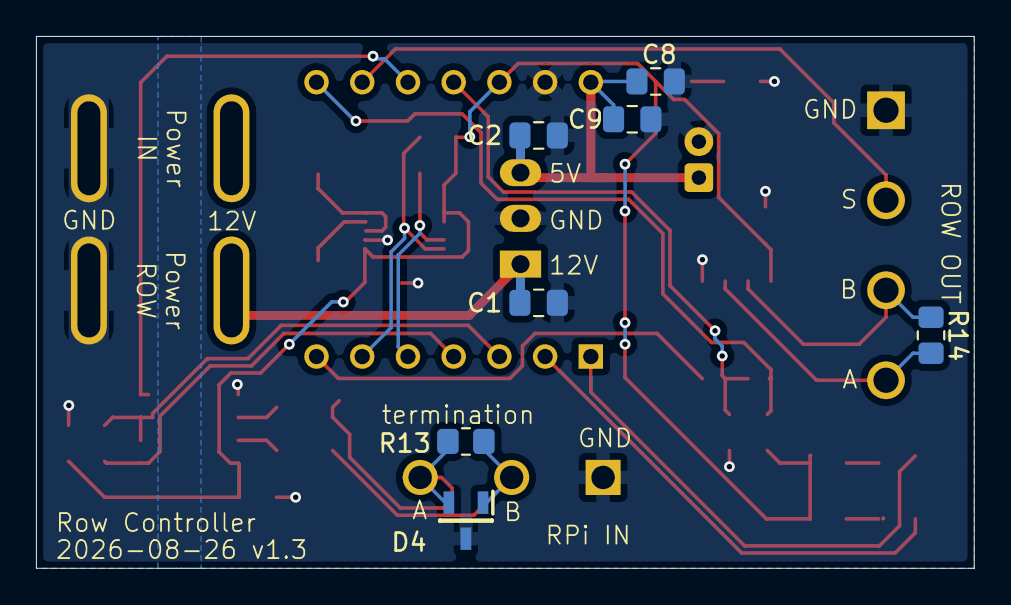
[picture p27: board row-controller.kicad_pcb from below]

Board: 2 copper layers, 52.1 x 29.5 mm, 34 parts (7 on the bottom side), 25 nets.
