tennessee-garage/dance-more/pcb/pi-hat/pi-hat.kicad_pcb

## KiCad design pcb/pi-hat/pi-hat.kicad_pcb (2026-08-16)

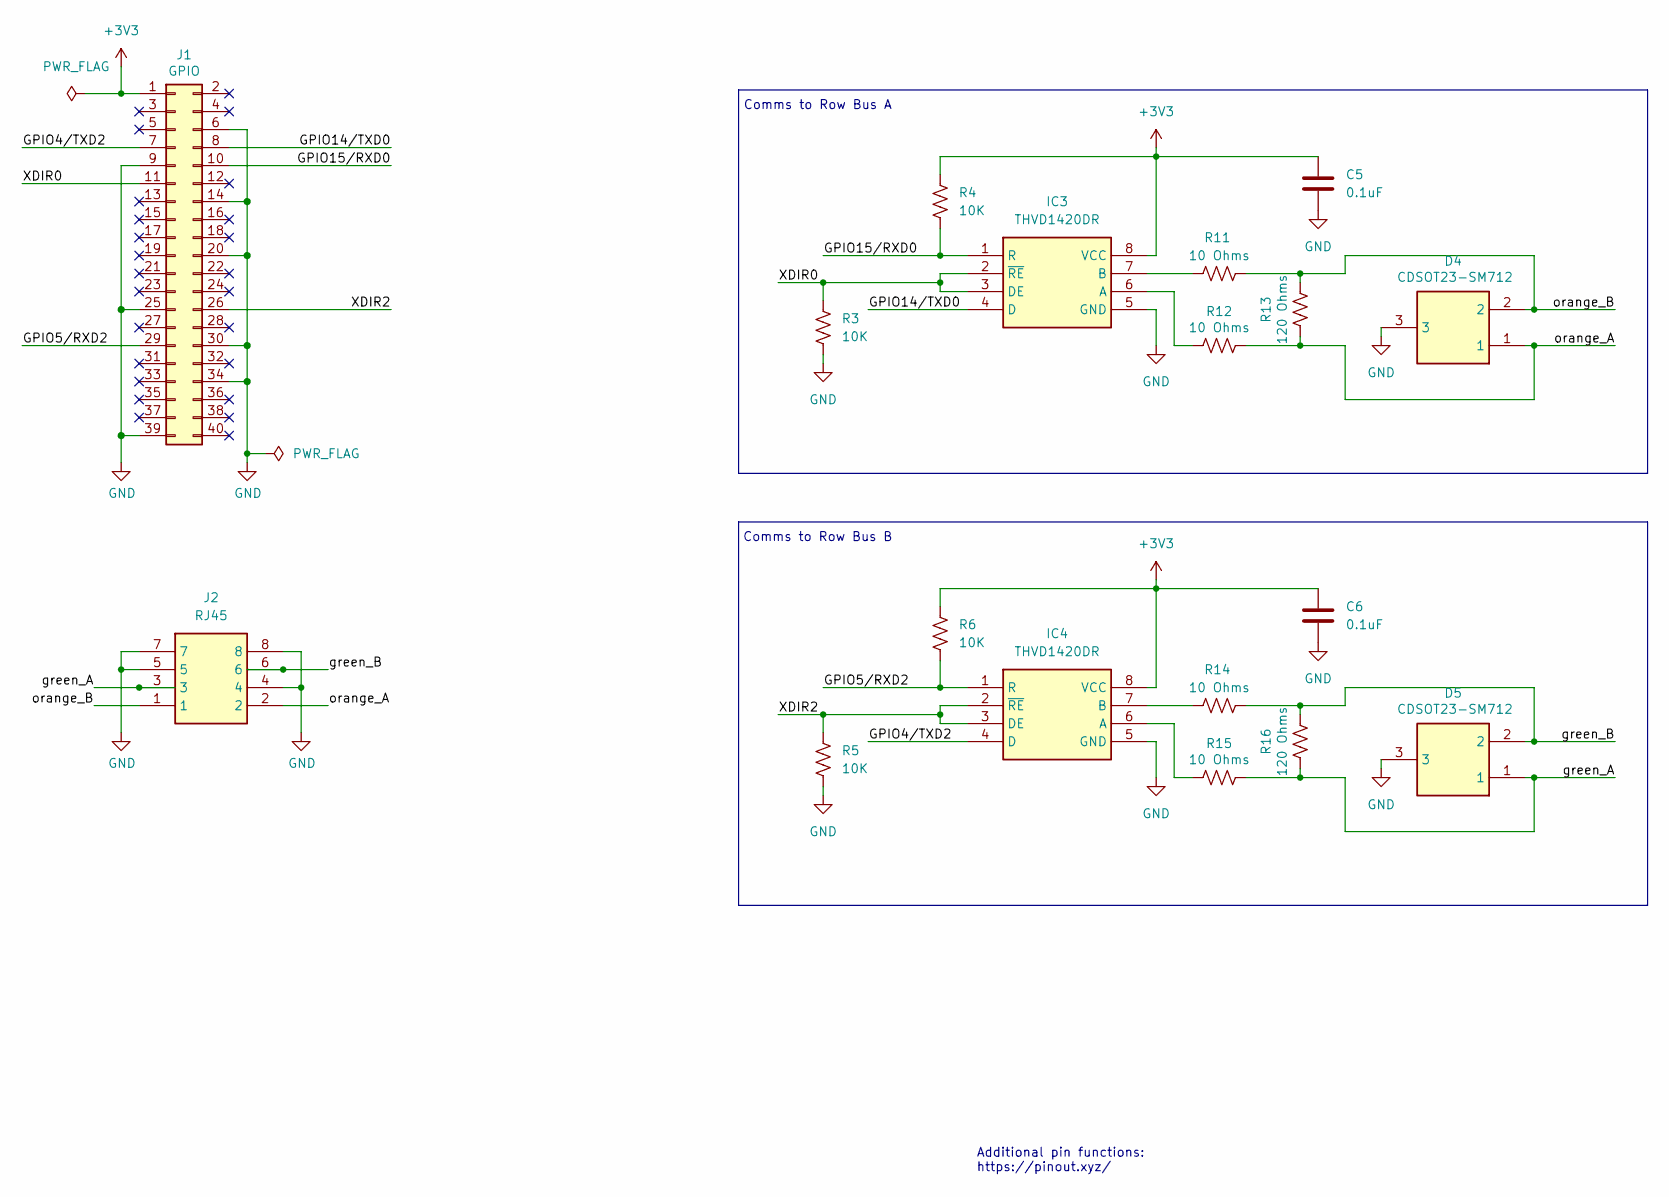
[picture p28: schematic pi-hat.kicad_sch]

Parts:
C5, C6: 0.1uF; C_0805_2012Metric_Pad1.18x1.45mm_HandSolder
D4, D5: CDSOT23-SM712; SOT95P230X117-3N; Mouser Part Number 652-CDSOT23-SM712
IC3, IC4: THVD1420DR; SOIC127P600X175-8N; Mouser Part Number 595-THVD1420DR
J1: GPIO; PinSocket_2x20_P2.54mm_Vertical
J2: RJ45; MJ3225880; Mouser Part Number 640-MJ3225880
R3, R4, R5, R6: 10K; R_0805_2012Metric_Pad1.20x1.40mm_HandSolder
R11, R12, R14, R15: 10 Ohms; R_1206_3216Metric_Pad1.30x1.75mm_HandSolder
R13, R16: 120 Ohms; R_0805_2012Metric_Pad1.20x1.40mm_HandSolder

Connections:
+3V3: C5.1, C6.1, IC3.8 (VCC), IC4.8 (VCC), J1.1, R4.1, R6.1
/GPIO4/TXD2: IC4.4 (D), J1.7
/GPIO5/RXD2: IC4.1 (R), J1.29, R6.2
/GPIO14/TXD0: IC3.4 (D), J1.8
/GPIO15/RXD0: IC3.1 (R), J1.10, R4.2
/XDIR0: IC3.2 (~RE), IC3.3 (DE), J1.11, R3.1
/XDIR2: IC4.2 (~RE), IC4.3 (DE), J1.26, R5.1
/green_A: D5.1, J2.3, R15.2, R16.1
/green_B: D5.2, J2.6, R14.2, R16.2
/orange_A: D4.1, J2.2, R12.2, R13.1
/orange_B: D4.2, J2.1, R11.2, R13.2
GND: C5.2, C6.2, D4.3, D5.3, IC3.5 (GND), IC4.5 (GND), J1.6, J1.9, J1.14, J1.20, J1.25, J1.30, J1.34, J1.39, J2.4, J2.5, J2.7, J2.8, R3.2, R5.2
unnamed: IC3.6 (A), R12.1
unnamed: IC3.7 (B), R11.1
unnamed: IC4.6 (A), R15.1
unnamed: IC4.7 (B), R14.1

Notes on the sheet:
Comms to Row Bus B
Additional pin functions: https://pinout.xyz/
Comms to Row Bus A

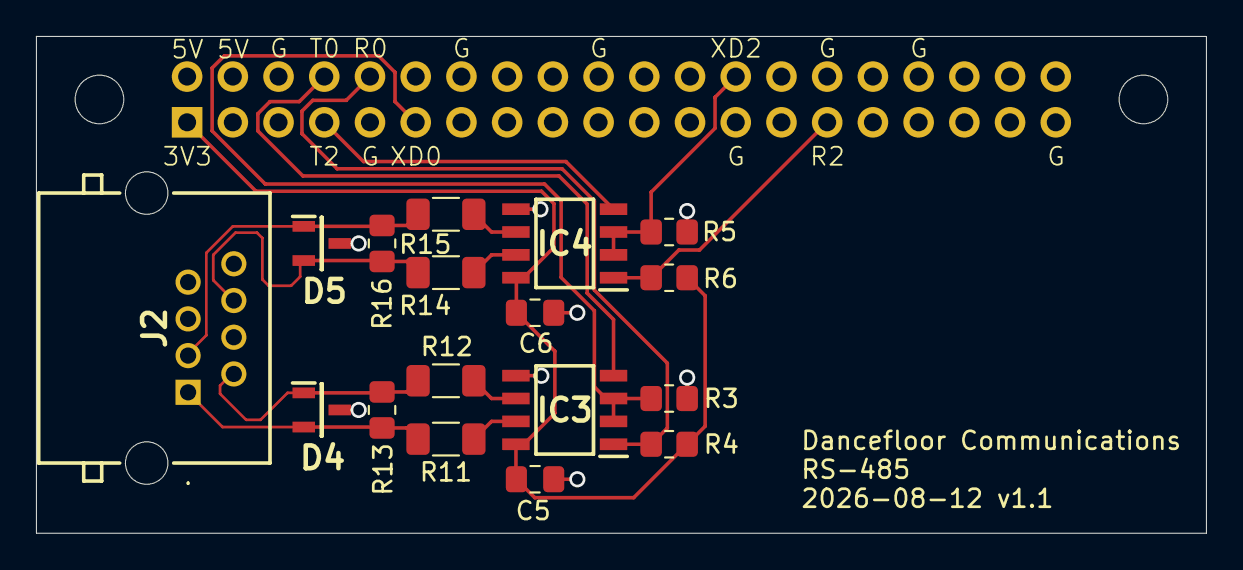
[picture p29: board pi-hat.kicad_pcb from above]

Board: 2 copper layers, 65.0 x 27.6 mm, 20 parts (1 on the bottom side), 16 nets.

Other parts of the board:
MH1, MH2: MountingHole_2.7mm_M2.5
