tennessee-garage/dance-more/pcb/tile/tile.kicad_pcb

## KiCad design pcb/tile/tile.kicad_pcb (2026-08-16)

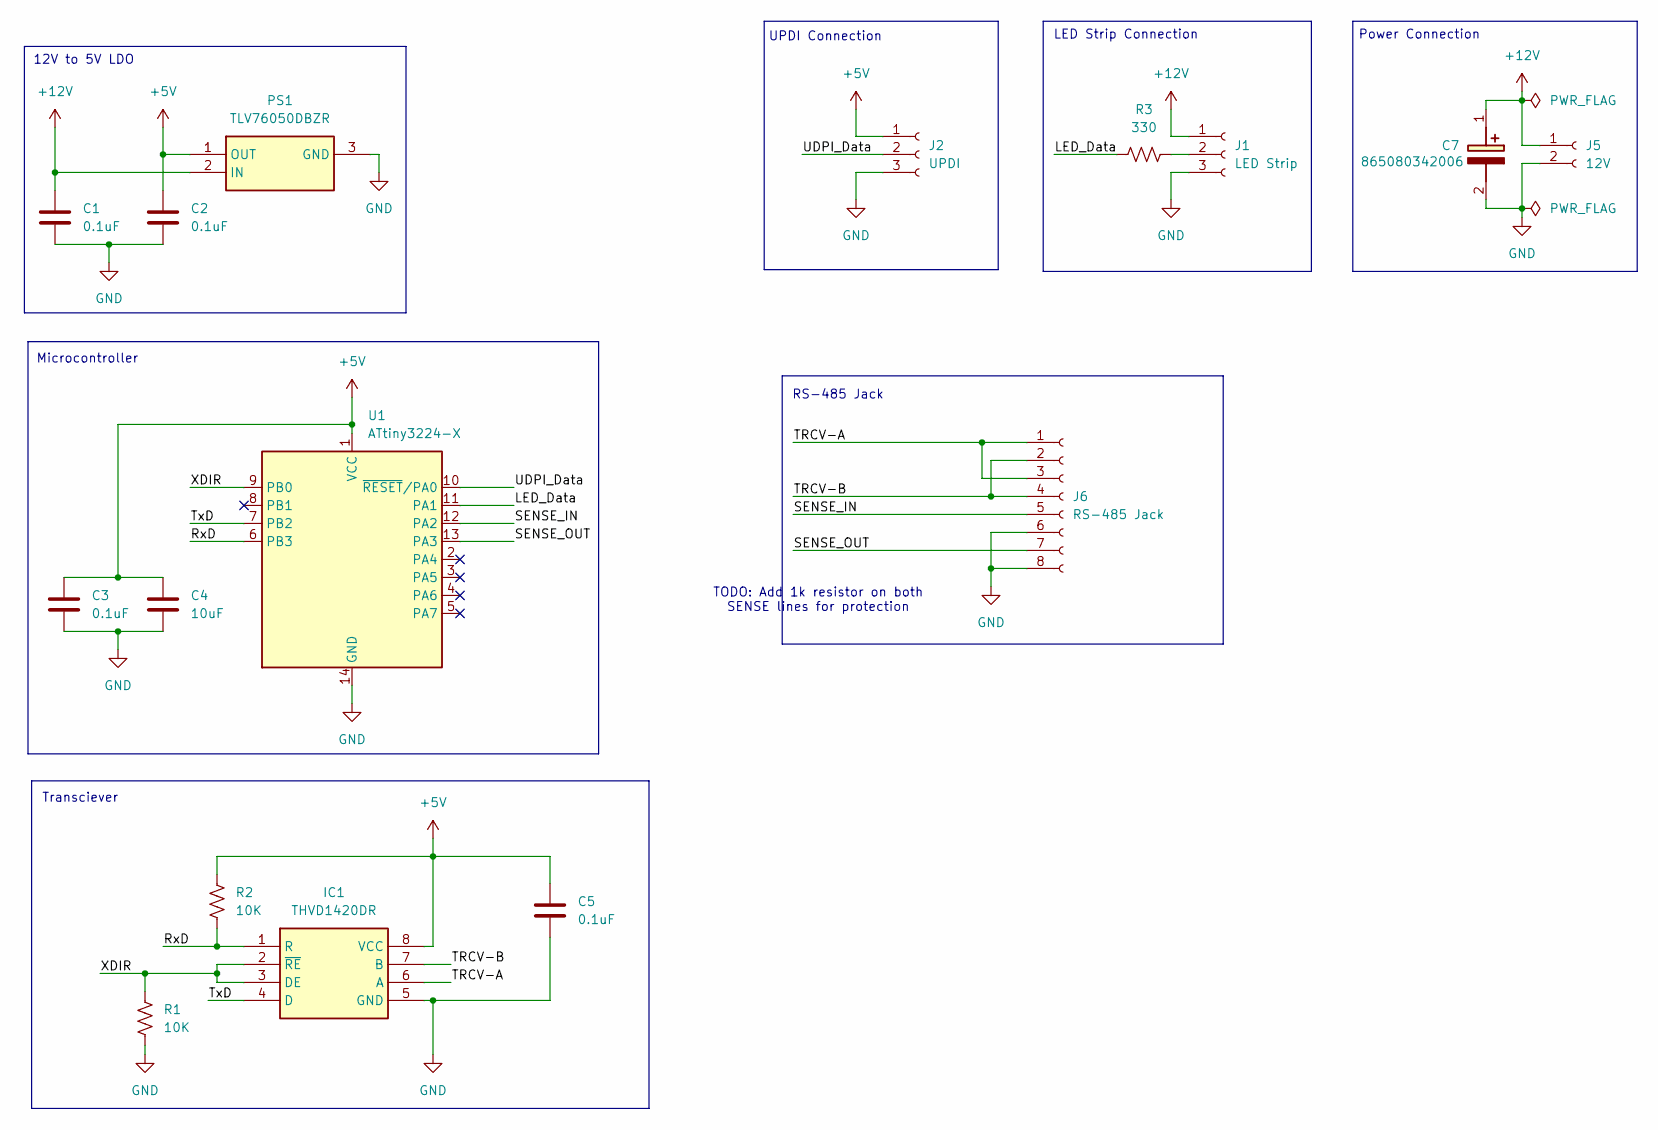
[picture p30: schematic tile.kicad_sch]

Parts:
C1, C2, C3, C5: 0.1uF; C_0805_2012Metric_Pad1.18x1.45mm_HandSolder
C4: 10uF; C_0805_2012Metric_Pad1.18x1.45mm_HandSolder
C7: 865080342006; CAPAE530X550N; Mouser Part Number 710-865080342006
IC1: THVD1420DR; SOIC127P600X175-8N; Mouser Part Number 595-THVD1420DR
J1: LED Strip; PinHeader_1x03_P2.54mm_Vertical
J2: UPDI; PinHeader_1x03_P2.54mm_Vertical
J5: 12V; JST_XH_B2B-XH-A_1x02_P2.50mm_Vertical
J6: RS-485 Jack; 6P6C RA RJ45 Jack
PS1: TLV76050DBZR; SOT95P237X112-3N; Mouser Part Number 595-TLV76050DBZR
R1, R2: 10K; R_0805_2012Metric_Pad1.20x1.40mm_HandSolder
R3: 330; R_0805_2012Metric_Pad1.20x1.40mm_HandSolder
U1: ATtiny3224-X; TSSOP-14_4.4x5mm_P0.65mm; Manufacturer Part Number ATTINY3224-XF; Mouser Part Number 579-ATTINY3224-XF

Connections:
+5V: C2.1, C3.1, C4.1, C5.1, IC1.8 (VCC), J2.1, PS1.1 (OUT), R2.1, U1.1 (VCC)
+12V: C1.1, C7.1 (+), J1.1, J5.1, PS1.2 (IN)
/LED_Data: R3.1, U1.11 (PA1)
/RxD: IC1.1 (R), R2.2, U1.6 (PB3)
/SENSE_IN: J6.5, U1.12 (PA2)
/SENSE_OUT: J6.7, U1.13 (PA3)
/TRCV-A: IC1.6 (A), J6.1, J6.3
/TRCV-B: IC1.7 (B), J6.2, J6.4
/TxD: IC1.4 (D), U1.7 (PB2)
/UDPI_Data: J2.2, U1.10 (~RESET/PA0)
/XDIR: IC1.2 (~RE), IC1.3 (DE), R1.1, U1.9 (PB0)
GND: C1.2, C2.2, C3.2, C4.2, C5.2, C7.2 (-), IC1.5 (GND), J1.3, J2.3, J5.2, J6.6, J6.8, PS1.3 (GND), R1.2, U1.14 (GND)
unnamed: J1.2, R3.2

Notes on the sheet:
TODO: Add 1k resistor on both SENSE lines for protection
UPDI Connection
LED Strip Connection
RS-485 Jack
Microcontroller
12V to 5V LDO
Transciever
Power Connection

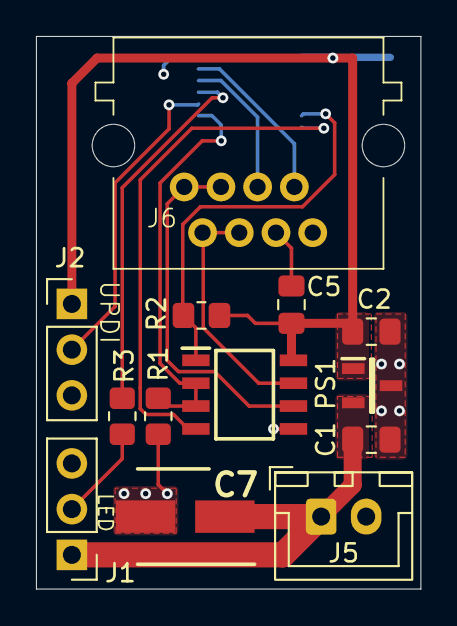
[picture p31: board tile.kicad_pcb from above]

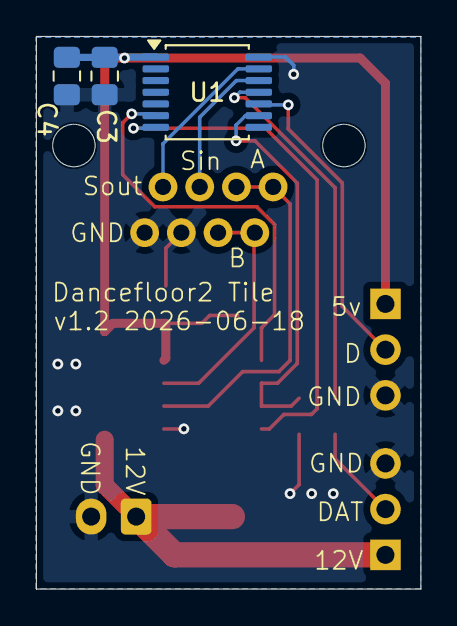
[picture p32: board tile.kicad_pcb from below]

Board: 2 copper layers, 21.4 x 30.7 mm, 16 parts (3 on the bottom side), 13 nets.
