tennessee-garage/dance-more/src/row/src/main.cpp

#include <Arduino.h>
#include <hardware/structs/powman.h>    // POWMAN_CHIP_RESET sticky causes, for the boot log
#include <hardware/structs/watchdog.h>  // WATCHDOG_REASON, for the same
#include "rp2350/pins.h"
#include "row_address.h"
#include "rp2350/pi_transport_rp2350.h"
#include "rp2350/tile_transport_rp2350.h"
#include "rp2350/row_sense_rp2350.h"
#include "rp2350/power_monitor_rp2350.h"
#include "rp2350/row_bus_frame_queue.h"
#include "rp2350/status_led_rp2350.h"
#include "sense_mapper.h"
#include "row_command_handler.h"
#include "fw_version_info.h"

// Core 0 - Row Bus ingest: owns PiTransportRP2350, validates and address-
// filters incoming frames, forwards responses back out over Row Bus.
// Core 1 - Tile Bus egress + dispatch: owns everything Tile-Bus-facing and
// SenseMapper, consumes frames handed off from core 0 via RowCommandHandler.
//
// Global objects are constructed (by normal C++ static init) before either
// core's setup()/setup1() runs - see framework-arduinopico's main(), which
// launches core 1 only after core 0's static init and USB/serial bring-up -
// so both cores always see fully-constructed queues/objects, no lazy-init
// ordering to worry about.

static PiTransportRP2350   pi_transport;
static TileTransportRP2350 tile_transport;
static StatusLedRP2350     status_led;
static RowSenseRP2350      row_sense;
static PowerMonitorRP2350  power_monitor;
static TileMap             tile_map;
static SenseMapper         sense_mapper(tile_transport, row_sense, tile_map);
static RowCommandHandler   row_cmd_handler(tile_transport, sense_mapper, power_monitor, MY_ROW_ADDR);

// ---- Watchdog ----
// A Row Bus RX overrun used to wedge this board hard enough that only a power
// cycle recovered it. Sizing the RX FIFO (pi_transport_rp2350.cpp) raised the
// rate needed to trigger that by orders of magnitude - from a single 184-byte
// frame to sustained 120 fps of maximum-size ones - but it did not change the
// failure *mode*: past the limit the core still stops dead rather than
// dropping frames. For fire-and-forget display data that trade is backwards.
// A missed frame should cost one flicker, not the row until somebody walks
// over and power-cycles it.
//
// The watchdog makes any such stall self-correcting, and deliberately does
// not depend on knowing which core stalled or why - useful, because the
// mechanism that turns an overrun into a wedge rather than dropped bytes is
// still not understood. Candidates include a stuck uart_tx_wait_blocking()
// in flush() (which would also strand XDIR high, jamming the bus), so the
// recovery is designed to need no such diagnosis.
//
// Core 1 publishes a heartbeat and core 0 feeds the watchdog only while that
// heartbeat advances, so a hang on *either* core stops the feed. Both numbers
// sit two orders of magnitude above the longest legitimate stall (a 127-byte
// Tile Bus frame at 1 Mbps is 1.3 ms; the largest Row Bus response, a full
// 32-entry ERROR_LOG_RESP, is 169 bytes = 0.54 ms at 3.125 Mbps), so neither
// can fire on a merely busy row.
//
// A reset re-runs setup()/setup1(), re-initialising both UARTs and restarting
// discovery. That is safe here in a way it would not be at cold boot: the
// tiles are long past their startup animation by then, so discovery finds
// them rather than hitting the cold-boot deafness window.
static constexpr uint32_t WATCHDOG_TIMEOUT_MS = 500;
static constexpr uint32_t CORE1_STALL_MS      = 250;
static volatile uint32_t  core1_heartbeat     = 0;

// ---- Boot discovery retry ----
// Discovery runs once from setup1(), finishing ~35 ms after power-up, but a
// tile does not service the Tile Bus until its own start-up completes. On a
// cold boot every row therefore came up reporting tiles_found = 0 and stayed
// that way until the Pi issued an explicit RE_DISCOVER.
//
// Retrying is deliberately preferred over waiting a fixed settling time: it
// couples to nothing about how long a tile takes to boot, so it keeps working
// if the tile's start-up changes, and it also covers a slow-rising rail,
// staggered supplies, and a tile that resets inside the window.
//
// Retried while all three hold:
//   - not every slot is filled. "Retry only while zero found" would stop at
//     the first gap: with tile 3 still booting, discovery ends the chain at
//     3 tiles and slots 4-7 would never be looked at again.
//   - still inside the boot window, so a legitimately short row (a bench with
//     one tile, or a partly populated floor) settles instead of sweeping for
//     ever.
//   - no SEND_DATA has arrived yet. Pixel data means the show has started,
//     and a discovery sweep would put ACTIVATE_SENSE/DETECT_SENSE traffic on
//     the Tile Bus in the middle of SET_LEDS forwarding. After that point
//     re-discovery is the Pi's call, via RE_DISCOVER.
static constexpr uint32_t BOOT_DISCOVERY_WINDOW_MS    = 20000;
static constexpr uint32_t DISCOVERY_RETRY_INTERVAL_MS = 1000;

// Core 1 only: set when the first SEND_DATA arrives, never cleared.
static bool display_data_seen = false;

// Set by core 0 when the Pi-facing UART overflows, consumed by core 1, which
// owns the error log. A flag rather than a count: consecutive overruns
// collapse into one entry instead of flooding a 32-deep log, and "we overran
// at all" is the fact worth having.
static volatile bool rx_overflow_pending = false;

// core 0 -> core 1: running total of frames dropped on a failed CRC. A total
// rather than a delta so there is exactly one writer and no read-modify-write
// race across cores; core 1 keeps its own high-water mark and logs the
// difference. Batched on an interval because a badly terminated link produces
// these in floods and one entry per frame would evict everything else.
static volatile uint32_t crc_failure_total = 0;
static constexpr uint32_t CRC_LOG_INTERVAL_MS = 5000;

// core 0 -> core 1: validated (CRC-good, addressed to us or broadcast) frames
static RowBusFrameQueue ingest_queue;
// core 1 -> core 0: RowCommandHandler responses to admin commands, bound for the Pi
static RowBusFrameQueue response_queue;

// ---- Status LEDs ----
// DATA (core 0): pulses for DATA_LED_PULSE_MS whenever a Row Bus frame
// addressed to this row is accepted, so bus traffic is visible at a glance.
// READY (core 1): solid once SENSE discovery has finished, slow-blinking
// while it runs, fast-blinking on discovery error. Blinking in the
// non-solid states doubles as a core-1-is-alive heartbeat.
//
// Each LED is driven by exactly one core, so there's no shared state to
// guard - and both are plain digitalWrite()s to distinct pins. Writes are
// gated on a change so these hot loops aren't hammering the GPIOs.

static constexpr uint32_t DATA_LED_PULSE_MS = 20;

static void drive_data_led(uint32_t now_ms, uint32_t until_ms) {
    static bool last = false;
    // Signed difference so the comparison survives a millis() rollover.
    bool want = (int32_t)(until_ms - now_ms) > 0;
    if (want != last) {
        status_led.set_data(want);
        last = want;
    }
}

static void drive_ready_led(uint32_t now_ms, SenseMapState state) {
    static bool last = false;
    bool want;
    switch (state) {
    case SenseMapState::DONE:  want = true;                    break;
    case SenseMapState::ERROR: want = (now_ms / 125) & 1;      break;
    default:                   want = (now_ms / 500) & 1;      break;
    }
    if (want != last) {
        status_led.set_ready(want);
        last = want;
    }
}

// ---- ROW_DEBUG bring-up instrumentation (env:seeed_xiao_rp2350_debug) ----
// Kept out of the normal build: this repurposes the Tile Bus UART as a
// plain debug console, which is only safe while no tiles are attached.
//
// Emitted on Serial1 (PIN_ROW_TX, GPIO0) as ASCII at the Tile Bus's
// 1 Mbps. Tile Bus XDIR is asserted around the write, exactly as
// TileTransportRP2350::send() does, so the text reaches the RS-485 pair at
// J6 and can be probed there rather than on the MCU's fine-pitch pad.
// Decode the non-inverted line of the pair as plain async serial; the
// other line carries the complement and will show as framing errors.
//
// DATA LED is also retargeted to raw byte arrival rather than accepted
// frames, so it lights even when bytes are arriving but failing CRC.
#ifdef ROW_DEBUG
#include <hardware/clocks.h>
#include <hardware/uart.h>

#ifndef ROW_BUS_BAUD
#define ROW_BUS_BAUD 3125000UL
#endif

static volatile uint32_t dbg_accepted = 0;  // frames that passed the address filter
static volatile uint32_t dbg_dropped  = 0;  // accepted but ingest_queue was full
static volatile uint32_t dbg_responses = 0; // responses handed back to core 0

static void debug_report(uint32_t now_ms, SenseMapState state) {
    static uint32_t next_ms = 0;
    if ((int32_t)(now_ms - next_ms) < 0) return;
    next_ms = now_ms + 1000;

    // Fixed for the life of the process - states this board's version on the
    // bench without needing the Pi (see docs/row-bus-protocol.md's VERSION
    // command, #56, for how the Pi reads the same identity over the wire).
    static const FirmwareVersion fw = row_fw_version();

    // Key up the Tile Bus transceiver for the duration of the write, then
    // release it - safe only because no tiles share this bus yet.
    digitalWrite(PIN_ROW_XDIR, HIGH);

    // Actual achieved Row Bus baud, straight from UART1's divisor registers
    // rather than the rate we asked for - the two differ silently when the
    // requested rate isn't reachable from clk_peri, which is exactly the
    // failure this instrumentation exists to catch.
    uint32_t periclk = clock_get_hz(clk_peri);
    uint32_t ibrd    = uart_get_hw(uart1)->ibrd;
    uint32_t fbrd    = uart_get_hw(uart1)->fbrd;
    uint32_t actual_baud = (64u * ibrd + fbrd)
                         ? (uint32_t)(((uint64_t)periclk * 4u) / (64u * ibrd + fbrd))
                         : 0;

    Serial1.printf("[row 0x%02X] fw=v%u+%08lx%s\r\n",
                   (unsigned)MY_ROW_ADDR, (unsigned)fw.version,
                   (unsigned long)fw.git_sha,
                   (fw.flags & FW_VERSION_FLAG_DIRTY) ? "-dirty" : "");

    Serial1.printf("[row 0x%02X] clk_peri=%lu baud_set=%lu baud_actual=%lu\r\n",
                   (unsigned)MY_ROW_ADDR, (unsigned long)periclk,
                   (unsigned long)ROW_BUS_BAUD, (unsigned long)actual_baud);

    Serial1.printf("[row 0x%02X] up=%lus rx_bytes=%lu rx_frames=%lu accepted=%lu "
                   "dropped=%lu responses=%lu tx_frames=%lu sense=%u\r\n",
                   (unsigned)MY_ROW_ADDR, (unsigned long)(now_ms / 1000),
                   (unsigned long)pi_transport.rx_bytes,
                   (unsigned long)pi_transport.rx_frames,
                   (unsigned long)dbg_accepted,
                   (unsigned long)dbg_dropped,
                   (unsigned long)dbg_responses,
                   (unsigned long)pi_transport.tx_frames,
                   (unsigned)state);

    Serial1.flush();  // wait for the last stop bit before releasing the line
    digitalWrite(PIN_ROW_XDIR, LOW);
}
#endif

// ---- Core 0 : Row Bus ingest ----

void setup() {
    status_led.init();
    pi_transport.init();
    rp2040.wdt_begin(WATCHDOG_TIMEOUT_MS);
}

// Feeds the watchdog only while core 1 is also making progress, so a stall on
// either core reboots the chip. Until core 1 has ticked even once its setup1()
// is still running concurrently with our first loops, so feed unconditionally
// during that window rather than letting start-up trip the watchdog.
static void feed_watchdog(uint32_t now_ms) {
    static uint32_t last_heartbeat    = 0;
    static uint32_t last_heartbeat_ms = 0;

    uint32_t beat = core1_heartbeat;
    if (beat != last_heartbeat) {
        last_heartbeat    = beat;
        last_heartbeat_ms = now_ms;
    }
    if (beat == 0 || (now_ms - last_heartbeat_ms) < CORE1_STALL_MS) rp2040.wdt_reset();
}

// Frames returned per loop() pass before the rest of the loop - and the
// watchdog feed at its end - gets a turn. See loop().
static constexpr int MAX_FRAMES_PER_PASS = 4;

void loop() {
    static RowBusFrameParser parser;
    static bool parser_ready = false;
    static uint32_t data_led_until_ms = 0;
    RowBusFrame frame;

    // The parser drops frames addressed to other rows itself - still
    // CRC-checking them, so crc_failures() covers the whole chain - rather
    // than copying out ~1.4 KB per foreign SEND_DATA only for us to discard it.
    if (!parser_ready) {
        parser.set_address(MY_ROW_ADDR);
        parser_ready = true;
    }

    uint32_t now = millis();

    // Bounded, so the watchdog is always fed. This used to be
    // `while (poll(...))`, which kept going for as long as frames kept
    // completing. When receive fell behind the wire there was always another
    // complete frame waiting, so the loop never exited and feed_watchdog()
    // never ran - the likely cause of rows resetting every ~500 ms for as
    // long as the Pi kept sending more than they could parse (#100). Anything
    // left over stays in the receive ring for the next pass.
    for (int handled = 0; handled < MAX_FRAMES_PER_PASS && pi_transport.poll(parser, &frame); handled++) {
        bool queued = ingest_queue.try_push(frame); // dropped if core 1 has fallen behind
        data_led_until_ms = now + DATA_LED_PULSE_MS;
#ifdef ROW_DEBUG
        dbg_accepted++;
        if (!queued) dbg_dropped++;
#else
        (void)queued;
#endif
    }

#ifdef ROW_DEBUG
    // Raw-byte activity, not accepted frames: lights even if every frame is
    // failing CRC, which is the distinction we're chasing during bring-up.
    static uint32_t last_rx_bytes = 0;
    if (pi_transport.rx_bytes != last_rx_bytes) {
        last_rx_bytes = pi_transport.rx_bytes;
        data_led_until_ms = now + DATA_LED_PULSE_MS;
    }
#endif

    drive_data_led(now, data_led_until_ms);

    // Hand any RX overrun to core 1 to log. Checked once per loop rather
    // than per byte: overflow() pumps the FIFO internally, and the flag is
    // sticky until read, so nothing is missed by sampling at this rate.
    if (pi_transport.take_rx_overflow()) rx_overflow_pending = true;

    // Publish the parser's CRC-failure count for core 1 to log.
    crc_failure_total = parser.crc_failures();

    RowBusFrame response;
    while (response_queue.try_pop(&response)) {
        pi_transport.send(response);
    }

    feed_watchdog(now);
}

// ---- Core 1 : Tile Bus egress + dispatch ----

void setup1() {
    tile_transport.init();
    row_sense.init();
    power_monitor.init();

    // Record why we booted before discovery runs: POWMAN's sticky cause bits
    // plus the watchdog's own REASON, since a watchdog reset through PSM
    // shows up only in the latter. Layout and interpretation at
    // ERROR_TYPE_ROW_BOOT.
    uint16_t cause = (uint16_t)((powman_hw->chip_reset >> 16) & ROW_BOOT_POWMAN_MASK);
    if (watchdog_hw->reason & WATCHDOG_REASON_TIMER_BITS) cause |= ROW_BOOT_WATCHDOG_TIMER;
    if (watchdog_hw->reason & WATCHDOG_REASON_FORCE_BITS) cause |= ROW_BOOT_WATCHDOG_FORCE;
    row_cmd_handler.log_boot(cause, millis());

    sense_mapper.start();
}

// Re-runs boot discovery while the row still looks incomplete. See
// BOOT_DISCOVERY_WINDOW_MS for why each guard is here. Retries from the ERROR
// state too, so a sweep that aborted on a mid-chain fault gets another go.
static void maybe_retry_discovery(uint32_t now_ms) {
    static uint32_t next_attempt_ms = DISCOVERY_RETRY_INTERVAL_MS;

    if (display_data_seen) return;
    if (now_ms >= BOOT_DISCOVERY_WINDOW_MS) return;
    if (sense_mapper.state() == SenseMapState::DISCOVERING) return;
    if (tile_map.discovered_count() >= TileMap::NUM_SLOTS) return;
    if ((int32_t)(now_ms - next_attempt_ms) < 0) return;

    next_attempt_ms = now_ms + DISCOVERY_RETRY_INTERVAL_MS;
    sense_mapper.start();
}

void loop1() {
    core1_heartbeat++;  // liveness for core 0's watchdog feed

    if (rx_overflow_pending) {
        rx_overflow_pending = false;
        row_cmd_handler.log_row_bus_overflow(millis());
    }

    // Frames the Pi sent that arrived corrupted. Rate-limited, carrying the
    // count for the window, so a link that is mangling everything says so
    // loudly without burying the rest of the log.
    static uint32_t crc_logged_upto = 0;
    static uint32_t next_crc_log_ms = CRC_LOG_INTERVAL_MS;
    const uint32_t crc_now = crc_failure_total;
    if (crc_now != crc_logged_upto && (int32_t)(millis() - next_crc_log_ms) >= 0) {
        const uint32_t delta = crc_now - crc_logged_upto;
        row_cmd_handler.log_crc_failures(delta > 0xFFFF ? 0xFFFF : (uint16_t)delta, millis());
        crc_logged_upto = crc_now;
        next_crc_log_ms = millis() + CRC_LOG_INTERVAL_MS;
    }

    sense_mapper.poll(millis());

    if (sense_mapper.take_sweep_started())
        row_cmd_handler.log_sense_start(millis());

    // A tile discovery mapped that then would not answer VERSION. On a
    // healthy row this never fires; when the row mis-walks one tile into
    // several slots, every slot but the last lands here.
    uint8_t silent_slot, silent_addr;
    if (sense_mapper.take_silent_tile(&silent_slot, &silent_addr))
        row_cmd_handler.log_tile_no_version(silent_slot, silent_addr, millis());

    drive_ready_led(millis(), sense_mapper.state());

    RowBusFrame frame;
    while (ingest_queue.try_pop(&frame)) {
        if (frame.cmd == (uint8_t)RowBusCmd::SEND_DATA) display_data_seen = true;
        const RowBusFrame *response = row_cmd_handler.handle(frame);
        if (response) {
            response_queue.try_push(*response);
#ifdef ROW_DEBUG
            dbg_responses++;
#endif
        }
    }

#ifdef ROW_DEBUG
    debug_report(millis(), sense_mapper.state());
#endif

    // Advances any in-flight SEND_DATA forwarding by one tile slot. Runs
    // after draining the queue above so that a LATCH already queued behind
    // a SEND_DATA in the same batch is dispatched (and, if forwarding isn't
    // done yet, deferred - see #46) before any slots advance this iteration.
    row_cmd_handler.poll(millis());

    maybe_retry_discovery(millis());
}
