tennessee-garage/dance-more/src/tile/src/at/pins.h

#pragma once
// Pin assignments for the ATtiny3226 tile board (pcb/tile-pcba, SSOP-20).
// Verified against pcb/tile-pcba/production/netlist.ipc and the U1 symbol in
// tile-pcba.kicad_sch — the nets are LED_DATA (pin 17), SENSE_IN (18),
// SENSE_OUT (19), XDIR (11), TXD (9) and RXD (8).
//
// The earlier ATtiny3224 board (pcb/tile, TSSOP-14) used the same port pins,
// so these assignments hold for both; only the package pin numbers differ.

// WS2815 LED data line (800 KHz, GRB)
#define PIN_LED_DATA  PIN_PA1

// RS-485 direction control (THVD1420DR XDIR/DE)
// HIGH = TX (driver enabled), LOW = RX (default)
#define PIN_DE        PIN_PB0

// SENSE chain GPIO
// SENSE_IN:  driven LOW by the upstream node to signal this tile
// SENSE_OUT: driven LOW by this tile to signal the downstream node;
//            released by returning the pin to high-impedance input
#define PIN_SENSE_IN  PIN_PA2
#define PIN_SENSE_OUT PIN_PA3

// UART0 pin selection (PORTMUX.USARTROUTEA). megaTinyCore maps USART0 pins
// via Serial.swap(n) before Serial.begin(); per the txy6 variant's
// pins_arduino.h (HWSERIAL0_MUX_DEFAULT = 0; txy4 is identical here):
//   swap 0 (default): TX=PB2, RX=PB3   <- what the PCB wires to the transceiver
//   swap 1 (alt):     TX=PA1, RX=PA2
// The default mux is already the one we want, so TransportAT::init() calls
// Serial.begin() with no swap(). Don't "fix" that by adding swap(1): the
// alternate mux lands TX on PA1 (the WS2815 data line) and RX on PA2
// (SENSE_IN), which would corrupt the LEDs and mute the Tile Bus at once.
//
// These two are documentation of that wiring, not inputs to Serial.begin() —
// megaTinyCore selects pins by mux index, not by pin number.
#define PIN_UART_TX   PIN_PB2
#define PIN_UART_RX   PIN_PB3
