tennessee-garage/dance-more/src/pi/src/df2_pi/transport/row_bus.py

"""Serial transport for the Row Bus (Raspberry Pi <-> row controllers).

Talks through the Pi hat's RS-485 transceiver over the Pi's UART (GPIO14
TXD0 / GPIO15 RXD0), with a GPIO output driving the transceiver's DE/RE
direction pin - LOW = RX (default, listening), HIGH = TX - since nothing in
the kernel UART driver does this for us. See docs/row-bus-protocol.md for
the wire format and docs/communication.md for the physical layer this
rides on.

Deliberately NOT /dev/serial0: on this Pi 5, that symlink resolves to
ttyAMA10, the BCM2712 SoC's own internal "console" UART (device tree alias
`console`/`uart10`), which is electrically disconnected from the 40-pin
header entirely. The header UART (GPIO14/15, RP1-attached) is a separate
peripheral, aliased `serial0`/`uart0` in the device tree but exposed at
/dev/ttyAMA0 - confirmed via `cat /proc/device-tree/aliases/serial0` and
cross-checking each ttyAMA's sysfs of_node. Getting this wrong doesn't
error - both ports open and accept writes fine - it just silently talks to
the wrong hardware.
"""

from __future__ import annotations

import os
import select
import time

import serial
from gpiozero import OutputDevice

from ..protocol.constants import ADDR_BROADCAST
from ..protocol.constants import DEFAULT_BAUDRATE as _DEFAULT_BAUDRATE
from ..protocol.frame import Frame, FrameParser

DEFAULT_PORT = "/dev/ttyAMA0"
# The Pi's RP1 UART is clocked at 50 MHz and a PL011 needs a divisor >= 1, so
# 50e6/16 = 3.125 Mbps is this link's hard ceiling (docs/row-bus-protocol.md
# §1). It divides exactly on both ends. Requesting more doesn't raise - the
# kernel silently clamps and the row controller then sees only framing
# errors, which its UART driver discards uncounted, so the bus goes mute.
DEFAULT_BAUDRATE = _DEFAULT_BAUDRATE  # defined in protocol.constants; re-exported here
DEFAULT_XDIR_PIN = 23  # BCM numbering; matches the pi-hat's XDIR wiring

# Extra time to hold XDIR after the frame's computed on-wire duration, so a
# late start inside the kernel can't truncate the last stop bit. Must stay
# well under the row controller's turnaround guard (TURNAROUND_GUARD_US in
# pi_transport_rp2350.cpp) or we'll still be driving when it replies.
DEFAULT_TX_RELEASE_MARGIN_S = 40e-6

# 8N1: one start bit + 8 data + one stop = 10 bit-times per byte.
_BITS_PER_BYTE = 10


class RowBus:
    def __init__(
        self,
        port: str = DEFAULT_PORT,
        baudrate: int = DEFAULT_BAUDRATE,
        read_timeout: float = 0.05,
        xdir_pin: int | None = DEFAULT_XDIR_PIN,
        tx_release_margin_s: float = DEFAULT_TX_RELEASE_MARGIN_S,
    ) -> None:
        self._serial = serial.Serial(port=port, baudrate=baudrate, timeout=read_timeout)
        self._parser = FrameParser()
        self._tx_release_margin_s = tx_release_margin_s
        # xdir_pin=None disables direction control entirely, e.g. for a
        # transport that turns out to be full-duplex or auto-direction.
        self._xdir = OutputDevice(xdir_pin, initial_value=False) if xdir_pin is not None else None

    def close(self) -> None:
        self._serial.close()
        if self._xdir is not None:
            self._xdir.close()

    def __enter__(self) -> RowBus:
        return self

    def __exit__(self, *exc_info) -> None:
        self.close()

    def send(self, addr: int, cmd: int, payload: bytes = b"") -> None:
        self._write(Frame(addr, cmd, payload).encode())

    def broadcast(self, cmd: int, payload: bytes = b"") -> None:
        self.send(ADDR_BROADCAST, cmd, payload)

    def send_raw(self, data: bytes) -> None:
        """Write pre-built bytes directly, bypassing Frame.encode().

        For protocol-robustness testing (e.g. sending a deliberately
        corrupt frame) where the caller needs to put specific bytes on the
        wire rather than a well-formed Frame.
        """
        self._write(data)

    def start_write(self, data: bytes) -> float:
        """Key up and write, returning the deadline at which the frame has
        cleared the wire. The caller must busy-wait to that deadline and
        then call finish_write().

        Split out of _write() so a caller driving several chains can start
        them all before waiting on any, which keeps a broadcast's skew
        across chains down to the gap between write() calls (microseconds)
        instead of one full frame time per chain. See Floor.latch().
        """
        if self._xdir is None:
            self._serial.write(data)
            self._serial.flush()
            return time.perf_counter()

        # Deliberately NOT serial.flush() (tcdrain) to decide when the frame
        # has cleared the wire: on the Pi 5's PL011 tcdrain overshoots the
        # true transmit time by ~6 ms regardless of frame size. That's ~60x
        # the row controller's 100 us turnaround guard, so the Pi would
        # still be driving the bus - with its own receiver disabled, since
        # DE and ~RE share XDIR - when the reply arrived. Every response was
        # lost to that collision.
        #
        # Instead, hold XDIR for the frame's computed on-wire duration plus
        # a small margin. Busy-wait rather than time.sleep(), whose ~50 us+
        # granularity is the same order as the window we're trying to hit.
        tx_seconds = len(data) * _BITS_PER_BYTE / self._serial.baudrate

        self._xdir.on()  # switch transceiver to TX
        start = time.perf_counter()
        self._queue(data)
        return start + tx_seconds + self._tx_release_margin_s

    def _queue(self, data: bytes) -> None:
        """Hand `data` to the kernel and return the moment it is queued.

        Deliberately not `self._serial.write()`. pyserial follows every
        os.write() with a select() for writability, and Linux only reports
        a tty writable once fewer than 256 bytes (WAKEUP_CHARS) remain in
        its transmit buffer - so for anything bigger than that, write()
        blocks until all but the last ~256 bytes have physically left the
        wire. A 1,456-byte SEND_DATA held the caller for 3.8 ms of its
        4.7 ms on-wire time, which meant Floor.send_rows() could not start
        chain 1's frame until chain 0's was ~80% sent: the two chains ran
        nearly serialised and a floor update took ~48 ms against the 33 ms
        budget (docs/measurements/2026-09-15-eight-row-bus-bringup.md).
        Frames under 256 bytes - every admin command, LATCH, BLACKOUT -
        never hit this, which is why it went unnoticed until SEND_DATA was
        timed.

        A bare os.write() into the kernel's transmit buffer returns in tens
        of microseconds regardless of size. pyserial leaves the fd
        non-blocking, so a full buffer shows up as a short write or EAGAIN
        rather than a stall; in that case wait for the port to drain and
        finish. It cannot happen in normal use - the caller busy-waits for
        the previous frame's on-wire deadline before sending the next - but
        a truncated frame is the one outcome this must never produce.
        """
        fd = self._serial.fd
        view = memoryview(data)
        while view:
            try:
                n = os.write(fd, view)
            except BlockingIOError:
                n = 0
            if n == 0:
                select.select([], [fd], [])
                continue
            view = view[n:]

    def finish_write(self) -> None:
        """Release the bus after start_write()'s deadline has passed."""
        if self._xdir is not None:
            self._xdir.off()  # back to RX

    def _write(self, data: bytes) -> None:
        deadline = self.start_write(data)
        try:
            while time.perf_counter() < deadline:
                pass
        finally:
            # Release the driver even if the busy-wait is interrupted. A
            # Ctrl+C landing here used to leave XDIR asserted and, worse,
            # the frame itself cut short: a row controller mid-payload
            # consumes whatever follows as payload, so one interrupted
            # SEND_DATA left the row unable to see any further frame until
            # ~1,448 more bytes had been fed to it. Observed on the bench as
            # a row that looked permanently dead and came back on the second
            # scan. The row now times the gap out on its own, but truncating
            # frames on the way out of a demo is worth not doing either way.
            self.finish_write()

    def read_frame(self, timeout: float | None = None) -> Frame | None:
        """Block until a CRC-valid frame arrives, or timeout elapses."""
        deadline = None if timeout is None else time.monotonic() + timeout
        while True:
            byte = self._serial.read(1)
            if not byte:
                if deadline is not None and time.monotonic() >= deadline:
                    self._parser.reset()
                    return None
                continue
            frame = self._parser.feed(byte[0])
            if frame is not None:
                return frame
            if deadline is not None and time.monotonic() >= deadline:
                # self._parser is a persistent, per-RowBus object - without
                # this reset, a frame that times out mid-payload (e.g. a
                # truncated/delayed reply) leaves it "owed" N more bytes,
                # and the next call's SYNC1/SYNC2 gets silently swallowed as
                # bogus payload instead of triggering a fresh resync. A
                # truncated frame can never become valid later, so there's
                # nothing useful this state could still be waiting for.
                self._parser.reset()
                return None

    def flush_input(self) -> None:
        """Discard buffered input and reset the frame parser.

        For a caller re-probing after a failed/timed-out read_frame() (e.g.
        a bring-up loopback test running many independent checks back to
        back) - clears any stale bytes still sitting in the OS receive
        buffer so the next read_frame() can't mistake them for the next
        check's frame. Unlike a read_frame() timeout, this discards
        in-flight bytes unconditionally, so don't call it while a reply is
        legitimately still expected.
        """
        self._serial.reset_input_buffer()
        self._parser.reset()
