tennessee-garage/dance-more/src/pi/test/integration/test_tile_stress.py

#!/usr/bin/env python3
"""
Stress and visual-verification test: drive one tile as hard as the chain allows.

Two halves:

  1. VISUAL - slow, watchable patterns whose correctness you judge by eye.
     Each announces what to look for. These check things telemetry cannot:
     colour mapping (a GRB/RGB swap looks fine to the protocol), per-pixel
     addressing, LED ordering and the actual LED count.

  2. STRESS - ramps SEND_DATA/LATCH throughput using maximum-size
     SET_LEDS frames until the achieved rate stops tracking the requested
     one, then soaks at the ceiling. Checks the row controller is still
     responsive after each step, since a Row Bus RX overrun used to wedge
     it hard enough to need a power cycle (fixed by setFIFOSize() in
     pi_transport_rp2350.cpp - this is the regression test for that).

At full rate every frame's LATCH arrives while the row controller is still
forwarding, so LATCH_OVERRUN entries are expected here and are diagnostic,
not failures (docs/row-bus-protocol.md 5.2). The real show controller sends
all 8 rows and then latches once at the frame boundary.

Usage:
  python3 test/integration/test_tile_stress.py --chain /dev/ttyAMA0:23
  python3 test/integration/test_tile_stress.py --chain /dev/ttyAMA0:23 --skip-visual
"""

from __future__ import annotations

import argparse
import colorsys
import sys
import time

from df2_pi.protocol.constants import (
    LEDS_PER_TILE,
    MAX_FRAME_SIZE,
    MAX_PAYLOAD,
    ROW_SLOTS,
    Cmd,
    TileCmd,
)
from df2_pi.transport import (
    ChainConfig,
    Floor,
    RowChainMap,
    RowNotResponding,
    default_chain_configs,
)
from df2_pi.transport.row_bus import DEFAULT_BAUDRATE

NUM_LEDS = LEDS_PER_TILE
NUM_SLOTS = ROW_SLOTS
# Full white on a whole tile approaches the bench supply's limit, which
# flattens any visual difference between bright colours - more so at 60 LEDs
# than the 40 this was first tuned for. Cap so patterns stay honest.
MAX_LEVEL = 200


def set_leds_payload(pixels: list[tuple[int, int, int]]) -> bytes:
    """One SET_LEDS entry per slot: the largest legal SEND_DATA payload
    (MAX_PAYLOAD bytes)."""
    if len(pixels) != NUM_LEDS:
        raise ValueError(f"need {NUM_LEDS} pixels, got {len(pixels)}")
    body = b"".join(bytes(p) for p in pixels)
    return (bytes([TileCmd.SET_LEDS]) + body) * NUM_SLOTS


def set_color_payload(r: int, g: int, b: int) -> bytes:
    return bytes([TileCmd.SET_COLOR, r, g, b]) * NUM_SLOTS


def wheel(pos: float, level: int = MAX_LEVEL) -> tuple[int, int, int]:
    r, g, b = colorsys.hsv_to_rgb(pos % 1.0, 1.0, 1.0)
    return (int(r * level), int(g * level), int(b * level))


def show(floor: Floor, row: int, pixels: list[tuple[int, int, int]]) -> None:
    floor.send_data(row, set_leds_payload(pixels))
    floor.latch()


# Printed in full BEFORE anything lights up: stdout is usually buffered
# (piped, or read over ssh), so per-step narration tends to arrive long after
# the LEDs have moved on. The operator needs the whole checklist in hand
# first, and each step announces itself again as it starts.
VISUAL_PLAN = """
  1. Solid RED, GREEN, BLUE, WHITE (2s each)
     -> Is each colour the one named? A red/green swap means the tile's RGB
        order is wrong - no protocol check can catch that, only your eyes.

  2. Single white pixel walking LED 0 -> the last one (~6s)
     -> Exactly one lit pixel, travelling end to end, no skips or gaps?
        It should reach the far end with none left over.

  3. First half RED, second half BLUE (3s)
     -> Clean split, boundary exactly at the midpoint? Confirms the tile has
        exactly NUM_LEDS addressable LEDs - no more, no fewer.

  4. Static rainbow across the strip (3s)
     -> Smooth continuous hue sweep, no dead or repeated pixels? This drives
        every per-pixel byte independently.

  5. Rotating rainbow (~6s)
     -> Smooth motion, no stutter, tearing or flicker? Tearing would mean
        LATCH is not holding pixels until the frame is complete.
"""


def announce(title: str, hold: float = 0.0) -> None:
    print(f"\n  -> {title}", flush=True)
    time.sleep(hold)


def visual(floor: Floor, row: int) -> None:
    print("\n=== VISUAL VERIFICATION ===")
    print(VISUAL_PLAN)
    print("  Watch the tile. Starting in 5s...", flush=True)
    time.sleep(5)

    announce("1. Solid colours")
    for name, rgb in [("RED", (MAX_LEVEL, 0, 0)), ("GREEN", (0, MAX_LEVEL, 0)),
                      ("BLUE", (0, 0, MAX_LEVEL)),
                      ("WHITE", (MAX_LEVEL,) * 3)]:
        print(f"       {name}", flush=True)
        floor.send_data(row, set_color_payload(*rgb))
        floor.latch()
        time.sleep(2.0)

    announce(f"2. Walking pixel, LED 0 -> {NUM_LEDS - 1}", 0.4)
    for i in range(NUM_LEDS):
        px = [(0, 0, 0)] * NUM_LEDS
        px[i] = (MAX_LEVEL,) * 3
        show(floor, row, px)
        time.sleep(0.09)
    time.sleep(0.4)

    half = NUM_LEDS // 2
    announce(f"3. Split: 0-{half - 1} RED / {half}-{NUM_LEDS - 1} BLUE", 0.4)
    show(floor, row, [(MAX_LEVEL, 0, 0)] * half + [(0, 0, MAX_LEVEL)] * (NUM_LEDS - half))
    time.sleep(3.0)

    announce("4. Static rainbow", 0.4)
    show(floor, row, [wheel(i / NUM_LEDS) for i in range(NUM_LEDS)])
    time.sleep(3.0)

    announce("5. Rotating rainbow", 0.4)
    t_end = time.time() + 6.0
    phase = 0.0
    while time.time() < t_end:
        show(floor, row, [wheel(i / NUM_LEDS + phase) for i in range(NUM_LEDS)])
        phase += 0.012
        time.sleep(0.02)

    floor.blackout()
    print("\n    -> blacked out. Visual section done.")


def responsive(floor: Floor, row: int, attempts: int = 3) -> bool:
    for _ in range(attempts):
        try:
            floor.request(row, Cmd.STATUS)
            return True
        except RowNotResponding:
            time.sleep(0.25)
    return False


def await_recovery(floor: Floor, row: int, limit_s: float = 8.0) -> float | None:
    """Seconds until the row answers again, or None if it never does.

    The row controller runs a watchdog (see main.cpp): a stalled core stops
    the feed and reboots the chip, so dropping out under load is expected to
    be self-correcting. Distinguishing "recovered on its own" from "needs a
    power cycle" is the whole point of this test post-fix, and a plain
    responsive() check is too short to see the difference.
    """
    start = time.perf_counter()
    while time.perf_counter() - start < limit_s:
        try:
            floor.request(row, Cmd.STATUS)
            return time.perf_counter() - start
        except RowNotResponding:
            pass
    return None


def measure(floor: Floor, row: int, frames: int, target_fps: float | None) -> float:
    """Push `frames` max-size SET_LEDS frames, optionally paced. Returns fps."""
    period = 1.0 / target_fps if target_fps else 0.0
    payloads = [set_leds_payload([wheel(i / NUM_LEDS + f * 0.02) for i in range(NUM_LEDS)])
                for f in range(min(frames, 24))]
    start = time.perf_counter()
    for f in range(frames):
        due = start + f * period
        floor.send_data(row, payloads[f % len(payloads)])
        floor.latch()
        if period:
            while time.perf_counter() < due + period:
                pass
    return frames / (time.perf_counter() - start)


def stress(floor: Floor, row: int, soak_s: float) -> bool:
    print(f"\n=== THROUGHPUT: {MAX_PAYLOAD}-byte SET_LEDS frames + LATCH ===")
    wire_ms = MAX_FRAME_SIZE * 10 / DEFAULT_BAUDRATE * 1000
    print(f"    Each frame is {MAX_FRAME_SIZE} bytes on the wire = {wire_ms:.2f} ms "
          f"at {DEFAULT_BAUDRATE / 1e6:.3f} Mbps,")
    print(f"    so the Row Bus alone caps this row near {1000 / wire_ms:.0f} fps.\n")
    print(f"    {'target':>8}  {'achieved':>9}  {'per frame':>10}  row")
    print("    " + "-" * 44)

    # docs/row-bus-protocol.md 1 budgets 30 FPS with all 8 rows sending
    # max-size frames. Rates at or below DESIGN_TARGET_FPS must run clean;
    # above it, dropping out is an acceptable ceiling *provided* the watchdog
    # brings the row back without human intervention. Needing a power cycle
    # is the only hard failure.
    DESIGN_TARGET_FPS = 120
    hard_fail = False
    target_fail = False
    highest_clean_fps = 0.0
    first_dropout = None
    for target in [30, 60, 120, 200, 300, None]:
        label = f"{target} fps" if target else "flat out"
        fps = measure(floor, row, frames=90, target_fps=target)
        if responsive(floor, row):
            state = "ok"
            highest_clean_fps = max(highest_clean_fps, fps)
        else:
            # Dropped out. Post-watchdog this should be self-correcting;
            # if it is not, the board needs a power cycle and the ramp ends.
            recovery = await_recovery(floor, row)
            if recovery is None:
                print(f"    {label:>8}  {fps:>7.1f}fps  {1000 / fps:>8.2f}ms  "
                      f"DEAD - no recovery")
                print("\n    Row controller did not come back - power cycle needed.")
                return False
            state = f"recovered in {recovery:.2f}s (watchdog)"
            if first_dropout is None:
                first_dropout = fps
            if target is not None and target <= DESIGN_TARGET_FPS:
                target_fail = True
            floor.request(row, Cmd.RE_DISCOVER)
            time.sleep(0.4)
        print(f"    {label:>8}  {fps:>7.1f}fps  {1000 / fps:>8.2f}ms  {state}")

    print(f"\n    Highest rate with no dropout: {highest_clean_fps:.1f} fps")
    if first_dropout:
        print(f"    First dropout at:             {first_dropout:.1f} fps "
              f"(recovered by watchdog, no power cycle)")
    if target_fail:
        print(f"    FAIL: dropped out at or below the {DESIGN_TARGET_FPS} fps design target")

    print(f"\n=== SOAK: flat out for {soak_s:.0f}s ===")
    start = time.perf_counter()
    sent = 0
    while time.perf_counter() - start < soak_s:
        sent += 1
        measure(floor, row, frames=1, target_fps=None)
    elapsed = time.perf_counter() - start
    print(f"    {sent} frames in {elapsed:.1f}s = {sent / elapsed:.1f} fps sustained")
    print(f"    ({sent * MAX_FRAME_SIZE / elapsed / 1000:.0f} kB/s on the Row Bus)")

    alive = responsive(floor, row)
    if not alive:
        recovery = await_recovery(floor, row)
        if recovery is None:
            print("    row controller after soak: DEAD - power cycle needed")
            return False
        print(f"    row controller after soak: recovered in {recovery:.2f}s (watchdog)")
        floor.request(row, Cmd.RE_DISCOVER)
        time.sleep(0.4)
        hard_fail = hard_fail  # recovery without a power cycle is acceptable here
    else:
        print("    row controller after soak: responsive throughout")

    frame = floor.request(row, Cmd.STATUS).payload
    print(f"    tiles still discovered: {frame[1]}")
    errs = floor.request(row, Cmd.ERROR_LOG).payload
    kinds: dict[int, int] = {}
    for i in range(errs[0]):
        kinds[errs[3 + i * 5]] = kinds.get(errs[3 + i * 5], 0) + 1
    names = {0x01: "no_ack_after_retries", 0x02: "crc_failure",
             0x03: "sense_collision", 0x04: "latch_overrun",
             0x05: "row_bus_rx_overflow"}
    summary = ", ".join(f"{names.get(k, hex(k))}={v}" for k, v in sorted(kinds.items()))
    print(f"    error log: {errs[0]} entries" + (f" ({summary})" if summary else ""))
    if 0x05 in kinds:
        print("    NOTE: row_bus_rx_overflow present - the Pi-facing UART dropped")
        print("          bytes, confirming the receive path as the rate limit.")
    if kinds and set(kinds) - {0x04, 0x05}:
        print("    NOTE: unexpected error types present - worth a look.")
    if not kinds:
        print("    (clean)")
    return not (hard_fail or target_fail)


def parse_chain(spec: str, baudrate: int) -> ChainConfig:
    port, _, xdir = spec.partition(":")
    if not xdir:
        raise argparse.ArgumentTypeError(f"--chain needs PORT:XDIR_GPIO, got {spec!r}")
    pin = None if xdir.lower() in ("none", "off") else int(xdir)
    return ChainConfig(port, pin, baudrate)


def main() -> int:
    ap = argparse.ArgumentParser(description="Stress and visually verify one tile")
    ap.add_argument("--chain", action="append", metavar="PORT:XDIR_GPIO")
    ap.add_argument("--baudrate", type=int, default=DEFAULT_BAUDRATE)
    ap.add_argument("--row", type=int, default=0)
    ap.add_argument("--soak", type=float, default=20.0, help="soak seconds (default 20)")
    ap.add_argument("--skip-visual", action="store_true")
    ap.add_argument("--skip-stress", action="store_true")
    args = ap.parse_args()

    chains = ([parse_chain(c, args.baudrate) for c in args.chain]
              if args.chain else default_chain_configs(args.baudrate))
    cmap = RowChainMap.single_chain() if len(chains) == 1 else RowChainMap.alternating(len(chains))

    with Floor(chains=chains, chain_map=cmap) as floor:
        if not responsive(floor, args.row):
            print(f"row 0x{args.row:02X} is not answering - power cycle?", file=sys.stderr)
            return 1

        # Discovery only runs at boot, and tiles are deaf for their first few
        # seconds (startup animation), so a cold-booted row reports zero.
        floor.request(args.row, Cmd.RE_DISCOVER)
        time.sleep(0.4)
        tiles = floor.request(args.row, Cmd.STATUS).payload[1]
        print(f"row 0x{args.row:02X}: {tiles} tile(s) discovered")
        if tiles == 0:
            print("no tiles discovered - nothing to drive", file=sys.stderr)
            return 1

        if not args.skip_visual:
            visual(floor, args.row)
        ok = True
        if not args.skip_stress:
            ok = stress(floor, args.row, args.soak)
        floor.blackout()

    print("\n" + ("STRESS TEST PASSED" if ok else "STRESS TEST FAILED"))
    return 0 if ok else 1


if __name__ == "__main__":
    sys.exit(main())
