tennessee-garage/dance-more/src/pi/test/test_dmx_control.py

import socket
import time
from pathlib import Path
from unittest.mock import MagicMock
from xml.etree import ElementTree

import pytest

from df2_pi.interfacing.dmx_control import CHANNELS, WIDTH, DmxControl, qlc_fixture, source_of, speed_of
from df2_pi.interfacing.packets import artdmx
from df2_pi.interfacing.receiver import Layout, Receiver

FIXTURE = Path(__file__).resolve().parents[3] / "docs" / "fixtures" / "dance-floor-v2.qxf"


class Clock:
    def __init__(self) -> None:
        self.t = 50.0

    def __call__(self) -> float:
        return self.t


def block(**values) -> bytes:
    """A control block: every channel at 0 except those named (by offset)."""
    data = bytearray(WIDTH)
    names = {"dimmer": 0, "strobe": 1, "source": 2, "mix": 3, "bank": 4, "program": 5, "speed": 6,
             "macro1": 7, "macro2": 8, "red": 11, "green": 12, "blue": 13, "tint": 14, "bump": 15, "hold": 16, "palette": 17}
    for name, value in values.items():
        data[names[name]] = value
    return bytes(data)


@pytest.fixture
def rig():
    runner = MagicMock()
    runner.state.show.strobe_max_hz = 10.0
    runner.state.playlist = None
    source = MagicMock()
    store = MagicMock()
    store.get_int.return_value = 180  # the stored brightness
    store.get_str.return_value = "external"
    store.get_float.return_value = 0.5
    clock = Clock()
    return DmxControl(runner, source, store, timeout_s=2.0, now=clock), runner, source, store, clock


def test_the_mappings():
    assert [speed_of(v) for v in (0, 64, 128, 255)] == [0.0, 0.5, 1.0, 4.0]
    assert [source_of(v) for v in (0, 84, 85, 169, 170, 255)] == ["internal", "internal", "external", "external", "mix", "mix"]


def test_the_first_packet_sets_continuous_controls_but_fires_no_triggers(rig):
    control, runner, source, _, _ = rig
    control.handle(block(dimmer=200, strobe=51, source=200, mix=128, speed=128, red=255, tint=255, bank=1, program=2, macro1=90, bump=255))
    runner.set_brightness.assert_called_once_with(200)
    runner.set_strobe.assert_called_once_with(pytest.approx(2.0))  # 51/255 of the 10 Hz cap
    source.set_source.assert_called_once_with("mix")
    source.set_mix.assert_called_once_with(pytest.approx(128 / 255))
    runner.set_speed.assert_called_once_with(1.0)
    runner.set_tint.assert_called_once_with(255, 0, 0, 1.0)
    runner.load_playlist.assert_not_called()
    runner.goto.assert_not_called()
    runner.set_control.assert_not_called()
    runner.bump.assert_not_called()


def test_only_changed_channels_act_after_that(rig):
    control, runner, source, _, _ = rig
    control.handle(block(dimmer=200))
    runner.reset_mock()
    source.reset_mock()
    control.handle(block(dimmer=200))
    assert runner.method_calls == [] and source.method_calls == []
    control.handle(block(dimmer=10, macro2=255))
    runner.set_brightness.assert_called_once_with(10)
    runner.set_control.assert_called_once_with("macro2", 1.0)


def test_bump_fires_when_it_rises(rig):
    control, runner, _, _, _ = rig
    control.handle(block())
    control.handle(block(bump=255))
    control.handle(block(bump=255))  # held: no second flash
    control.handle(block(bump=0))
    control.handle(block(bump=128))
    assert [c.args for c in runner.bump.call_args_list] == [(1.0, 0.25), (128 / 255, 0.25)]


def test_hold_follows_the_channel_across_128(rig):
    control, runner, _, _, _ = rig
    control.handle(block(hold=0))  # connecting with it down leaves a web UI hold alone
    control.handle(block(hold=127))
    control.handle(block(hold=128))
    control.handle(block(hold=255))
    control.handle(block(hold=40))
    assert [c.args for c in runner.hold.call_args_list] == [(True,), (False,)]


def test_a_first_packet_with_hold_up_holds(rig):
    control, runner, _, _, _ = rig
    control.handle(block(hold=200))
    runner.hold.assert_called_once_with(True)


def test_silence_releases_a_hold_the_desk_applied_but_not_one_it_did_not(rig):
    control, runner, _, _, clock = rig
    control.handle(block(hold=255))
    clock.t += 3.0
    control.poll()
    assert [c.args for c in runner.hold.call_args_list] == [(True,), (False,)]
    runner.reset_mock()
    control.handle(block(hold=0))
    clock.t += 3.0
    control.poll()
    runner.hold.assert_not_called()


def test_palette_picks_by_the_books_order_and_only_on_change(rig):
    control, runner, source, store, _ = rig
    book = MagicMock()
    book.names.return_value = ["rainbow", "fire", "mine"]
    control.palettes = book
    control.handle(block(palette=2))  # first packet: a trigger, so nothing
    book.activate.assert_not_called()
    control.handle(block(palette=1))
    control.handle(block(palette=9))  # no such palette: ignored
    control.handle(block(palette=2))
    assert [c.args for c in book.activate.call_args_list] == [("fire",), ("mine",)]


def test_bank_and_program_load_a_playlist_by_name_order_and_go_to_an_entry(rig):
    control, runner, _, store, _ = rig
    playlists = [MagicMock(id=7, entries=[1, 2, 3]), MagicMock(id=3, entries=[1])]
    playlists[0].name, playlists[1].name = "Chill", "Party"
    store.playlists.return_value = playlists
    control.handle(block())
    control.handle(block(bank=0, program=2))  # the program changed: bank 0 is not loaded yet
    store.resolve.assert_called_once_with(7)
    runner.goto.assert_called_once_with(2)
    runner.state.playlist = (7, "Chill")
    runner.reset_mock()
    store.resolve.reset_mock()
    control.handle(block(bank=0, program=1))  # same bank, loaded: just go
    store.resolve.assert_not_called()
    runner.goto.assert_called_once_with(1)
    control.handle(block(bank=5, program=1))  # no such playlist: ignored
    control.handle(block(bank=1, program=4))  # no such entry: ignored
    assert runner.goto.call_count == 1
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
