tennessee-garage/dance-more/(commit log)

2025-10-22 First rev of the tile and row controller
    [row-controller.kicad_pcb, row-controller.kicad_sch, tile.kicad_pcb, tile.kicad_sch]
2025-10-22 Small tweaks
    [tile.kicad_pcb, tile.kicad_sch]
2025-10-23 Updated version of the tile that only uses on RJ45 jack vs two RJ12 jacks
    [tile.kicad_pcb, tile.kicad_sch]
2025-11-07 Slight adjustments to some text on the board
    [tile.kicad_pcb]
2025-11-07 Removed the ferrite bead, updated power symbols.
    Not convinced I need the beads, can do some testing to confirm this when I have test boards
    [row-controller.kicad_pcb, row-controller.kicad_sch]
2026-06-18 Committing PCB changes before swaping out some components
    [row-controller.kicad_pcb, row-controller.kicad_sch, tile.kicad_pcb, tile.kicad_sch]
2026-06-18 Slightly widened the 12V trace between the power in and strip
    [tile.kicad_pcb]
2026-06-21 Row controller with two power jacks; in from main power, out for row power
    This is necessary to actually measure the power sent to the row
    [row-controller.kicad_pcb]
2026-06-21 Additon of second power jack, plus notes/todos for things that need updating
    Checkpointing here since this is what the last fab got and I want to be able to come back to it
    [row-controller.kicad_sch, tile.kicad_sch]
2026-06-21 Commit the gerbers and some images of the current verions that have been sent to fab
    [row-controller-B_Cu.gbr, row-controller-B_Mask.gbr, row-controller-B_Paste.gbr, row-controller-B_Silkscreen.gbr, row-controller-Edge_Cuts.gbr, row-controller-F_Cu.gbr, row-controller-F_Mask.gbr, row-controller-F_Paste.gbr]
2026-07-02 Updated to account for a bulk cap as well as a resistor on the LED data line
    [tile.kicad_pcb, tile.kicad_sch]
2026-07-02 Check point for the pi-hat PCB
    [pi-hat.kicad_pcb, pi-hat.kicad_sch]
2026-07-02 Implemented Frame encoding/decoding
    The protocol is encoded in the frame. Also added tests against the protocol.cpp functions.
    To make tests work, the independent code had to be moved to lib where pio test could see it.
    Closes #3
2026-07-03 Implemented the native LED driver Includes a test with color display/simulation Closes #8
2026-07-03 Implemented sending LED data Closes #7
2026-07-06 Communications working Added a test esp32c3 program to drive the RS-485 line directly w/o needing a working row controller. Discovered that the AT was coded to think it was running at 16Mhz when the 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
    [led_driver_at.cpp, led_driver_at.h, main.cpp, main_esp32.cpp, main_led_test.cpp, pins.h]
2026-07-08 Add RP2350 pin mapping for row controller
    Defines PIN_LED_READY/DATA, PIN_PI_XDIR/ROW_XDIR, PIN_SDA/SCL,
    PIN_ROW_TX/RX/SENSE, and PIN_PI_RX/TX in src/rp2350/pins.h, and adds
    src/native/ as the mock-implementation directory, mirroring the tile
    project's platform split (src/at/ + src/native/).
    Closes #21
2026-07-08 Add status LED driver and hardware test program
    Implements IStatusLed for PIN_LED_READY/PIN_LED_DATA (active-low),
    with a StatusLedRP2350 hardware driver, a StatusLedNative stdout-log
    mock for env:native, and a main_led_test.cpp cycling both LEDs
    independently and together.
    Also fixes the base platformio.ini src_filter: -<main*.cpp> only
    matched top-level files, so nested entry points like
    rp2350/main_led_test.cpp leaked into the production build and
    collided with main.cpp's setup()/loop(). Switched to -<**/main*.cpp>.
    Closes #22
    [main_led_test.cpp, status_led_rp2350.cpp]
2026-07-08 Move flash-and-observe hardware sketches to src/hw_tests/
    Keeps standalone bring-up firmware (main_led_test.cpp, and future
    sketches like it) separate from both the production rp2350/ driver
    code and PlatformIO's own test/ directory (Unity unit tests +
    integration scripts), which has different semantics.
2026-07-08 Add INA220 power monitor driver and hardware test program
    Implements IPowerMonitor for the INA220BIDGSR (I2C address 0x45, both
    address pins tied to Vs), with a PowerMonitorRP2350 driver, a
    PowerMonitorNative sine-wave mock for env:native, and
    main_power_test.cpp polling once a second and printing to Serial.
    Register map, bus-voltage decoding ((raw >> 3) * 4 = mV), and the
    calibration formula (0.04096 / (Current_LSB * R_shunt)) are identical
    to the INA219's and verified against Adafruit_INA219's reference
    implementation. Calibrated for 5A of headroom over the ~4A/row peak
    load noted in docs/power.md (Current_LSB = 0.2 mA/bit). Calibration
    register is rewritten before every read since it's k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
2026-07-09 Extract Tile Bus protocol + ITransport into a shared library
    src/row/ was about to become a second, independently-maintained
    implementation of the exact wire format src/tile/DF2-Tile already has
    (Frame/Cmd/CRC/FrameParser + ITransport). Since both live in the same
    repo, extract them to src/common/tile_bus_protocol/ instead and have
    both projects' platformio.ini reference it via lib_extra_dirs, so
    there's one canonical implementation rather than two kept in sync by
    hand.
    Frame/Cmd/FrameParser/crc16/frame_encode/ITransport are unchanged from
    the tile project's original names - no renames needed on that side.
    lib/df2_core/command_handler.h needed an explicit relative include
    since PlatformIO's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
2026-07-09 Flatten src/tile/DF2-Tile/ up to src/tile/
    src/tile only ever contained the one DF2-Tile subdirectory, so the
    extra nesting level was pure noise. Moves everything up one level and
    shortens the relative includes/lib_extra_dirs/-I paths that reach
    src/common/tile_bus_protocol/ by one directory level accordingly.
    Verified: all four PlatformIO envs build, the Makefile-based
    tools/tile-bus-broker builds, and test/integration/test_sense_mapping.py
    passes end-to-end from the new location.
    [led_driver_at.cpp, led_driver_at.h]
2026-07-09 Add TileMap: slot -> tile address/status/retry data structure
    Array-of-structs (one TileSlot per logical slot) rather than parallel
    arrays, so looking up everything about a slot is one index. Retry
    counts are tracked per slot, not as a single run-wide counter, so a
    flaky physical position can be told apart from a solid one. Status
    values are wire-compatible with STATUS_RESP's tile_status[] bytes so
    the command handler can use them with no translation.
    Header-only - every method is a one-line index into slots_.
    Closes #37
2026-07-09 Add SenseMapper: Tile Bus SENSE auto-mapping state machine
    Implements the discovery sequence from docs/communication.md and
    docs/tile-bus-protocol.md §9 (assert SENSE -> DETECT_SENSE ->
    ACTIVATE_SENSE -> release upstream -> repeat, until DETECT_SENSE times
    out) as a non-blocking state machine driven by an explicit millisecond
    clock, so it's identically testable under env:native and drivable from
    millis() on the RP2350.
    Populates a caller-owned TileMap (#37) rather than owning its own copy
    of the mapping data. Retries are tracked per-slot on the map itself,
    not as a separate run-wide counter. A DETECT_SENSE timeout after the
    retry budget is treated as the expected end-of-chain signal (not a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
2026-07-09 Add RP2350 Tile Bus transport + row SENSE drive
    TileTransportRP2350 implements ITransport on Serial1 at 1 Mbps with
    PIN_ROW_XDIR direction control, mirroring the tile project's own
    TransportAT (same DE-high/write/flush/DE-low shape, no manual
    turnaround delay - flush() already blocks until TX-complete, matching
    what the tile side's working implementation actually does rather than
    the literal "≥100us guard" wording).
    PIN_ROW_TX/PIN_ROW_RX (D6/D7) are this board's default Serial1 pins,
    so no setTX()/setRX() remap is needed - unlike the Row Bus side
    (PIN_PI_TX/PIN_PI_RX), which will need one in #31. Note for whoever
    picks up #31: Tile Bus now owns Serial1, so Row Bus should use Serial2
    (with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
2026-07-09 Add SENSE chain hardware test program
    Standalone hw_tests sketch for bench-testing a single tile wired at
    slot 0: asserts the row controller's own SENSE, DETECT_SENSE ->
    DETECT_RESP, ACTIVATE_SENSE -> ACK, then CLEAR_SENSE cleanup - the same
    sequence SenseMapper runs for real auto-mapping, one tile at a time.
    At boot (and after each run) prompts [r]un (immediate, auto-report) or
    [s]tep (pauses for [c]ontinue after steps 1 and 2, so the physical
    SENSE line can be probed with a meter/scope between them) - no
    reflashing needed to switch modes.
2026-07-10 Added a correction and a note to the schematic and design.
    [row-controller.kicad_pcb, row-controller.kicad_sch]
2026-07-10 Add row-wide SENSE discovery + display test pattern hw_tests program
    Runs full SenseMapper discovery (0-8 tiles, whatever's actually wired,
    not hardcoded), reports the slot->address mapping, then cycles display
    commands forever to every discovered tile: SET_COLOR (unicast per
    tile, not broadcast, so the test actually proves per-tile addressing)
    through a few solid colors, then a red->blue linear gradient over
    SET_LEDS (all 40 LEDs distinct, proving the full 120-byte payload
    isn't truncated) - each followed by the mandatory LATCH. SET_PATTERN
    is out of scope per the issue.
    Renamed the TileMap instance to tile_map (not map) - Arduino's own
    long map(long, long, long, long, long) utility functi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
    [main_row_test.cpp]
2026-07-10 Add native Tile Bus transport (tile-bus-broker client) + fix SenseMapper race
    TileTransportNative/RowSenseNative implement ITransport/IRowSenseControl
    as a client of the tile project's existing tile-bus-broker, always
    identifying as (addr=0x00, slot=0xFF) so the broker's uint8_t slot-wrap
    routes this row controller's SENSE_ASSERT/SENSE_RELEASE to tile slot 0.
    broker_msg.h's constants are copied (not shared/included) per #34 - it's
    native-testing-only socket framing around the real, already-shared Tile
    Bus protocol, not the protocol itself.
    main_native.cpp now actually runs SenseMapper against these against a
    real tile-bus-broker + native tile mocks instead of just printing a
    placeholder.
    R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
    [main_native.cpp]
2026-07-10 Add Row Bus frame codec, commands, and IPiTransport
    RowBusFrame/RowBusFrameParser/RowBusCmd/row_bus_crc16/row_bus_frame_encode
    in lib/row_core/row_bus_protocol.{h,cpp}, mirroring the same structure
    and CRC-16/CCITT algorithm as the shared Tile Bus protocol, adapted for
    Row Bus's 2-byte big-endian LEN (payload up to 968 bytes, for
    SEND_DATA) instead of Tile Bus's 1-byte LEN.
    RowBus*-prefixed to disambiguate from the (unprefixed) Frame/Cmd/
    FrameParser this project already gets from the shared
    src/common/tile_bus_protocol/ - this protocol is Row Bus-specific
    (Pi <-> row controller), with no tile-project equivalent to share with.
    IPiTransport (include/pi_transport.h) is the interface RP2350 (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
2026-07-10 Add RowCommandHandler: Row Bus command dispatcher
    Decodes a RowBusFrame and dispatches per docs/row-bus-protocol.md §5:
    - STATUS: full, from SenseMapper's state()/result() (TileMap's
    TileStatus values and SenseMapState's declaration order already
    match the wire's state/tile_status bytes exactly, no translation)
    - POWER: full, from IPowerMonitor
    - RE_DISCOVER: full, starts SenseMapper and ACKs immediately
    - SEND_DATA: full, walks the 8 fixed-format tile entries and forwards
    each to its discovered address as an individual Tile Bus frame;
    always advances by the full entry size even when skipping an
    undiscovered slot, so a gap doesn't misalign later entries
    - BLACKOUT: full, SET_COLO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
2026-07-11 Implement PiTransportRP2350 (Row Bus UART driver)
    Adds IPiTransport for the RP2350, driving Row Bus over Serial2 (UART1)
    remapped to PIN_PI_TX/PIN_PI_RX at 4 Mbps 8N1, with PIN_PI_XDIR
    direction control for the THVD1420DR transceiver.
    send() asserts XDIR, writes the encoded frame, waits for true TX
    completion (Serial2.flush(), not just FIFO-empty), holds the bus idle
    for the >= 100 us turnaround guard (same as Tile Bus), then releases
    XDIR back to RX. poll() drains all available RX bytes per call into
    the RowBusFrameParser, mirroring TileTransportRP2350's pattern.
    Closes #31
2026-07-11 Fix turnaround guard placement in PiTransportRP2350
    The guard was being applied after our own TX finished (delaying our
    return to RX), which doesn't implement what the protocol doc actually
    specifies and provides no benefit to other bus participants, who have
    no visibility into it. Move it to before we key up: track the last
    received byte's timestamp in poll(), and in send() wait out any
    remaining guard time measured from that receipt, not from our own
    transmission - so we don't start driving the line until the Pi's
    transceiver has had time to fully release it.
    [pi_transport_rp2350.cpp, pi_transport_rp2350.h]
2026-07-11 Implement native Row Bus mock transport + broker (#33)
    Adds row-bus-broker, a Unix-socket multidrop relay modeling the Pi <->
    8-row-controller Row Bus segment the same way tile-bus-broker models
    Tile Bus - full broadcast to every other connected client, no
    address-based routing, since real RS-485 doesn't do that either. No
    SENSE sideband is needed (Row Bus addresses are static), so this is
    simpler than tile-bus-broker: plain FRAME/IDENTIFY relay only, with a
    2-byte length prefix (row_broker_msg.h) since RowBusFrame's 968-byte
    max payload doesn't fit tile_bus_protocol's 1-byte framing.
    PiTransportNative connects to the broker as a client and identifies
    with its row address, mirroring TileTra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
    [main.cpp]
2026-07-11 Implement RP2350 row address assignment via CHIPID mapping (#50)
    Adds a mechanism for a row controller board to get a stable Row Bus
    address (0x00-0x07) derived from its RP2350's factory-burned unique
    CHIPID (OTP rows CHIPID0-CHIPID3), so flashing the correct address
    becomes a repeatable part of the programming cycle instead of a
    manual step - readable via `picotool otp get` while the board is in
    BOOTSEL mode, before any firmware exists, so there's no chicken/egg
    firmware round-trip.
    - tools/row-address-map.json: committed fleet roster, chip-id -> 0-7
    - tools/assign_row_address.py: reads the CHIPID, looks it up or
    assigns the next free address, writes include/row_address_generated.h
    - too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
    [main.cpp]
2026-07-11 Wire dual-core main.cpp: Row Bus ingest / Tile Bus egress split (#45)
    Core 0 owns PiTransportRP2350: polls for Row Bus frames, discards
    anything not addressed to this row (my_row_addr or broadcast) before
    it ever crosses to core 1, and forwards RowCommandHandler's responses
    back out over Row Bus.
    Core 1 owns everything Tile-Bus-facing: TileTransportRP2350,
    RowSenseRP2350, PowerMonitorRP2350, SenseMapper/TileMap, and
    RowCommandHandler. Runs SenseMapper::poll() every iteration and
    dispatches frames handed off from core 0.
    Cross-core handoff is RowBusFrameQueue (src/rp2350/row_bus_frame_queue.h):
    a small fixed-capacity (4), mutex-guarded ring buffer - two instances,
    one per direction, since t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
    [main.cpp, row_bus_frame_queue.h]
2026-07-11 Implement LATCH overrun buffering + ERROR_LOG producer (#46)
    RowCommandHandler::handle_send_data() now starts incremental
    forwarding rather than completing synchronously: a new poll(now_ms)
    method (called every loop1() iteration in main.cpp, mirroring
    SenseMapper's convention) advances exactly one tile slot per call.
    This is what makes a LATCH arriving mid-forward observable at all -
    previously the whole SEND_DATA loop completed atomically within a
    single handle() call, so there was no window in which "still
    forwarding" could ever be true.
    handle_latch() now checks that in-flight state: if forwarding is still
    running, it defers (recording how many slots had been forwarded and
    which tile com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
    [main.cpp]
2026-08-13 Add df2-pi, the Raspberry Pi Row Bus host controller
    Python skeleton for tier 1 of the control hierarchy: generates frames and
    drives the Row Bus over the pi-hat's RS-485 transceivers.
    protocol/ wire format - constants, CRC-16/CCITT, streaming frame parser
    transport/ row_bus.py one RS-485 chain (pyserial + XDIR direction)
    chain_map.py logical row 0-7 -> physical chain
    floor.py the whole floor; routes rows, fans out broadcasts
    cli.py df2-pi scan / status / blackout
    The floor's 8 rows are split across two RS-485 chains so the worst-case
    frame fits the 33 ms budget. A single Cat5 run passes every row controller
    in order, each tapping the opposite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
2026-08-13 Fix Row Bus pin assignments and add bring-up instrumentation
    pins.h carried "tentative values from the issue spec - verify against the
    KiCad schematic before flashing hardware", and they had never been
    verified. Three assignments were rotated relative to the actual board:
    PIN_PI_RX D9 -> D3 (GPIO5, a valid UART1 RX pin)
    PIN_PI_TX D10 -> D9 (GPIO4, a valid UART1 TX pin)
    PIN_ROW_XDIR D3 -> D10 (GPIO3, plain GPIO)
    Confirmed against U1's connections in row-controller.kicad_sch and the
    seeed_xiao_rp2350 variant header. Two consequences, both silent:
    - RP2350 UART function only exists on specific GPIOs. GPIO3 is not a UART
    pin at all and GPIO4 is TX-only, so Serial2 fell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
    [main.cpp, main_pin_probe.cpp, pi_transport_rp2350.cpp, pi_transport_rp2350.h, pins.h]
2026-08-13 Correct the Row Bus baud rate to the Pi's 3.125 Mbps ceiling
    The 4 Mbps minimum was unreachable. The Pi 5's RP1 UART is clocked at
    50 MHz and a PL011 derives its rate as uartclk / (16 x divisor) with
    divisor >= 1, so 50e6/16 = 3,125,000 is the hardware maximum. That rate
    divides exactly on both ends (Pi 50e6/16, RP2350 150e6/48).
    Asking for more fails silently rather than loudly: the Pi clamps, the row
    controller runs at whatever it was told, and every byte then arrives
    mis-timed and is rejected as a framing error by the RP2350's UART IRQ
    handler, which drops bad characters without counting them. The bus goes
    completely mute, indistinguishable from a broken wire. Documented, because
    it cost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
2026-08-13 pcb: 3.3V transceiver supply, second Row Bus chain, fab outputs
    The THVD1420DR transceivers ran at VCC=5V while driving 3.3V-only GPIOs on
    both boards. Per the datasheet the receiver output swings to VCC-0.4V min
    (~4.6-4.8V at 5V), and the RX pull-ups went to 5V as well, so both the Pi's
    and the RP2350's inputs sat out of spec. Both boards were bodged to 3.3V on
    the bench; these schematics bring the sources in line.
    pi-hat:
    - IC3 supply, decoupling and RX pull-up moved from +5V to +3V3; no +5V net
    remains on the board.
    - Second Row Bus chain added (IC4) so the 8 rows split across two chains -
    see docs/row-bus-protocol.md for why one chain no longer fits the frame
    budget. Chain A on ua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
    [pi-hat-B_Cu.gbl, pi-hat-B_Mask.gbs, pi-hat-B_Paste.gbp, pi-hat-B_Silkscreen.gbo, pi-hat-Edge_Cuts.gm1, pi-hat-F_Cu.gtl, pi-hat-F_Mask.gts, pi-hat-F_Paste.gtp]
2026-08-13 row: reject admin commands sent as broadcast
    docs/row-bus-protocol.md §3 is explicit: "0xFF Broadcast — all row
    controllers accept; none respond." The firmware didn't enforce this -
    main.cpp's address filter only decided whether to accept a frame (own
    address or broadcast), then RowCommandHandler::handle() dispatched purely
    on command byte, with no memory of which reason let the frame through. An
    admin command (TEST/STATUS/POWER/RE_DISCOVER/ERROR_LOG) addressed to 0xFF
    got answered exactly like unicast.
    With one row controller on the bus this looked harmless - we found it as
    an "informational" note during bring-up rather than a failure. With all 8
    installed it's a real collision: every r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
2026-08-13 pi: Floor.broadcast() rejects admin commands, fail-fast
    Companion to de7968b, which is what actually prevents the collision - a row
    controller now refuses an admin command sent as broadcast regardless of who
    sent it. This is a second, earlier check: Floor.broadcast() raises
    ValueError immediately for anything outside {LATCH, BLACKOUT}, so a caller
    finds out at the call site instead of via a silently-dropped frame.
    RowBus.broadcast()/send() stay unrestricted underneath - Floor is the
    ergonomic layer, RowBus is the primitive - so protocol-robustness testing
    can still go around the guard on purpose, the same way check_corrupt_crc()
    already does with send_raw().
    test_row_bus_scan.py's broadcas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
    [floor.py, test_floor.py, test_row_bus_scan.py]
2026-08-16 row: size Row Bus RX FIFO to hold a whole max frame
    arduino-pico's SerialUART defaults to a 32-byte software RX FIFO, roughly
    100 us of buffering at 3.125 Mbps. A maximum SEND_DATA frame is 976 bytes
    arriving back-to-back over 3.1 ms - about 30x longer than that window - and
    poll() costs two _pumpFIFO() round trips per byte (one in available(), one
    in read()) against a 3.2 us/byte arrival rate. Core 0 cannot keep up.
    The result was not merely dropped bytes: the core wedged permanently and
    only a power cycle recovered it. Bisecting payload size on the bench put the
    edge between a 168-byte frame (survives) and a 184-byte frame (fatal), which
    matches no protocol field - notably not the 255/256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
2026-08-16 tile: correct the USART0 pin-mux comment in pins.h
    The comment had the two mux options backwards, claiming swap 0 (the
    default) is TX=PA1/RX=PA2 and swap 1 is TX=PB2/RX=PB3. The txy4 variant's
    pins_arduino.h says the opposite: HWSERIAL0_MUX_DEFAULT is 0 with
    PIN_HWSERIAL0_TX=PB2 and PIN_HWSERIAL0_RX=PB3, and PINSWAP_1 is PA1/PA2.
    As written it invited a real regression. TransportAT::init() calls
    Serial.begin() with no swap() and is correct - PB2/PB3 are what the PCB
    wires to the transceiver - but anyone reading the comment would conclude
    the UART was mux'd onto PA1 (the WS2815 data line) and PA2 (SENSE_IN) and
    "fix" it by adding swap(1), which would actually put it there: corrupting
    the LED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
    [pins.h]
2026-08-16 pi: add --expect-tiles to the Row Bus scan integration test
    The script hardcoded an expectation of zero discovered tiles and recorded
    it as a passing check, so a bench with a tile physically attached but not
    answering reported ALL CHECKS PASSED - it passed precisely because the
    thing under test was broken. That is not a hypothetical: it masked both an
    unflashed tile and, later, a genuine cold-boot discovery race.
    "Found nothing" is a legitimate end state on this bus (see
    SenseMapper::finish_discovery), so the tile count cannot be inferred from
    the wire - a row controller reports tiles_found=0 just as happily when a
    tile is attached but mute as when none is fitted. --expect-tiles is how the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
    [test_row_bus_scan.py]
2026-08-16 pi: add a tile stress and visual-verification integration test
    Two halves, both covering ground the existing scan test cannot.
    The visual half drives patterns whose correctness only a human can judge:
    solid primaries (a GRB/RGB swap is invisible to every protocol check, since
    the bytes are carried faithfully either way), a single pixel walking 0->39
    (per-pixel addressing, ordering and the real LED count), a half-and-half
    split (confirms exactly 40 addressable LEDs), and static plus rotating
    rainbows (all 120 per-pixel bytes independently, and whether LATCH really
    holds pixels until a frame is complete). The full checklist prints before
    anything lights up - stdout is usually buffered when pi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
    [test_tile_stress.py]
2026-08-16 row: make a Row Bus RX overrun survivable, and visible
    c21cf6f raised the rate needed to trigger a Row Bus receive overrun by
    orders of magnitude - from a single 184-byte frame to sustained 120 fps of
    maximum-size ones - but did not change the failure mode. Past the limit the
    core still stops dead rather than dropping frames, and only a power cycle
    recovers it. For fire-and-forget display data that is backwards: a missed
    frame should cost one flicker, not the row until somebody power-cycles it.
    Two halves.
    Recovery: a watchdog, deliberately not dependent on knowing which core
    stalled or why. The mechanism that turns an overrun into a wedge rather
    than merely dropped bytes is still not unde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
    [main.cpp, pi_transport_rp2350.cpp, pi_transport_rp2350.h]
2026-08-16 pi: decode Row Bus RX overflow (error type 0x05)
    Host side of the row controller's new error_type 0x05. Without this an
    overrun decodes as "unknown(0x05)" in both integration scripts, which is
    precisely the case the firmware change exists to make legible.
    The stress test already treats any error type other than latch_overrun as
    worth calling out, so an overrun surfacing during a throughput ramp now
    names itself rather than appearing as a bare hex code.
    [test_row_bus_scan.py, test_tile_stress.py]
2026-08-16 pi: judge the stress ramp against the design target, not perfection
    The ramp treated any dropout as a failure, so it reported FAILED for exactly
    the behaviour the row controller's watchdog exists to produce: stalling at
    the ceiling and recovering unaided.
    What actually matters is graded. docs/row-bus-protocol.md 1 budgets 30 FPS
    with all 8 rows sending max-size frames, so rates up to DESIGN_TARGET_FPS
    must run clean. Above that, dropping out is an acceptable ceiling provided
    the row comes back on its own - needing a power cycle is the only hard
    failure, and that is what regressing c21cf6f or ca8b456 would look like.
    Adds await_recovery(): responsive()'s 0.75 s budget is shorter than a
    watc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
    [test_tile_stress.py]
2026-08-16 row: retry boot discovery so a cold power-up finds its tiles
    Discovery ran exactly once, from setup1(), finishing about 35 ms after
    power-up. A tile does not service the Tile Bus until its own start-up
    completes, so on a cold boot every tile was still deaf when the only sweep
    of the boot went past. Every row came up reporting tiles_found = 0 and
    stayed that way until the Pi issued an explicit RE_DISCOVER - and since
    SEND_DATA forwarding skips undiscovered slots, that meant no LED on the
    floor could be lit after a normal power-up.
    Retrying is deliberately chosen over waiting a fixed settling time. It
    couples to nothing about how long a tile takes to boot, so it keeps working
    when the tile's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
    [main.cpp]
2026-08-16 tile: drive the start-up pattern from loop() instead of blocking setup()
    The start-up pattern ran as six 600 ms delay() calls inside setup(), leaving
    the tile deaf to the Tile Bus for its first ~3.7 s. That is two orders of
    magnitude longer than the row controller's boot discovery sweep, which
    finishes about 35 ms after power-up, so every tile was still in setup() when
    the only sweep of the boot went past.
    Now advanced from loop(). The tile parses Tile Bus frames throughout, so it
    answers DETECT_SENSE while the pattern is still playing, and the diagnostic
    keeps its full run time without costing discovery anything. A LATCH cancels
    it, so real display data always supersedes the start-up patte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
2026-08-16 row: fix power monitor driver for the actual INA226, not the EOL INA219/220
    IC1 was swapped from the INA220BIDGSR to the INA226-Q1 when the former went
    end-of-life on Mouser, but power_monitor_rp2350.cpp was never updated for
    the new part - it was still decoding the INA219/220's register format. The
    KiCad schematic/BOM was not updated either (still lists INA220BIDGSR); that
    is a separate, PCB-side fix, not touched here.
    The mismatch was silent rather than a bus error, because addressing and
    register offsets (0x00 CONFIG .. 0x05 CALIBRATION) are identical between the
    two families - only the bit-level contents inside each register differ.
    Two independent bugs, both traced against docs/datash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
    [main_power_test.cpp, power_monitor_rp2350.cpp]
2026-08-16 pi: add brightness-sweep measurement tool and first tile characterization
    Generalizes the ad-hoc script used to characterize the df2-tile's current
    draw into a reusable tool: steps SET_COLOR 0-100% per color (red/green/blue/
    white), records INA226 current at each step (averaged over several reads,
    first discarded as settling), and subtracts the blacked-out baseline so the
    output isolates commanded-color cost from the row controller + tile's own
    quiescent draw.
    Takes --row and --label rather than hardcoding row 0 - the point is to
    re-run this against whatever gets plugged in next (a different tile
    revision, a third-party LED strip), with --label keeping each run's output
    from colliding with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
    [2026-08-16-brightness-sweep-df2-tile.csv]
2026-08-16 docs: cross-reference the brightness-sweep tool from power.md
    power.md's ~0.5 A/tile figure had no recorded provenance - just "measured".
    Note that tile_brightness_sweep.py (docs/measurements/) now gives an
    instrumented, baseline-subtracted remeasurement (~418 mA LED-only at full
    white), and link to it, without changing the headline number: the original
    figure's hardware/strip aren't known well enough to call this a correction
    rather than corroboration, and 0.5 A is a deliberately clean, safely-rounded
    number the rest of the doc's rollups (per-row, per-floor) are already built
    on.
2026-08-16 row: assign row address at build time, not from a CHIPID lookup
    Every board flashed via PlatformIO's own upload flow (VS Code's env picker,
    "Big Buttons") got MY_ROW_ADDR 0x00 from the checked-in fallback header,
    because tools/assign_row_address.py never actually ran: it reads each
    board's RP2350 CHIPID via `picotool otp get`, which requires the board
    already in BOOTSEL - but PlatformIO's own upload puts the board in BOOTSEL
    itself via a 1200-baud touch reset, so the two were fighting over who does
    that and when. In practice the script just errored ("is the board in
    BOOTSEL mode?") and nobody's board ever got an assigned address.
    Harmless with one row on the bench; with a second row control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
    [main.cpp, row_address.h]
2026-08-16 Several changes while testing.
    Primary is that 5v was being used as the power rail when 3V3 was needed on the Pi hat and row controller board, where the RPi5 and RP2350 are both 3V3 logic. On the Pi Hat a second UART to RS-485 was also added to have dual buses, enabling 6.25 Gbps, given the RPi5 is limited to 3.125Mbps
    [pi-hat.kicad_pcb, row-controller.kicad_pcb, tile.kicad_pcb]
2026-08-16 Fixed trace length for sense resistor.
    Ensure the traces to IN+ and IN- go directly to those pins. Electrically IN+ and Vbus connect, and since they are adjacent, I mistakenly wired the sense resistor to Vbus, with a dog leg over to IN+. Flip that so it goes directly to IN+ with a dog leg to Vbus. This keeps the line lengths for IN+ and IN- short and equal.
    [row-controller.kicad_pcb, row-controller.kicad_sch]
2026-08-16 common: add shared FirmwareVersion wire type (#55)
    Row and tile firmware each carry a hand-bumped version constant plus a
    build-injected git identity; this is the 7-byte big-endian encoding both
    sides' VERSION_RESP payloads (#56) will use to put that identity on the
    wire.
2026-08-16 row: add ROW_FW_VERSION and build-time git identity (#55)
    Adds the row half of the version-identity scheme: a hand-bumped
    ROW_FW_VERSION constant, a PlatformIO pre-script that injects the build's
    git SHA and a dirty flag (scoped to src/row + src/common so an unrelated
    dirty file elsewhere in the tree doesn't trip it), and an accessor
    combining them into a FirmwareVersion. seeed_xiao_rp2350_debug's periodic
    counter dump now states the board's version, so a row on the bench can be
    identified without going through the Pi.
    [fw_version.h, main.cpp]
2026-08-16 tile: add TILE_FW_VERSION and build-time git identity (#55)
    Tile half of the version-identity scheme, mirroring the row commit: a
    hand-bumped TILE_FW_VERSION constant, the same git-SHA/dirty-flag
    injection (scoped to src/tile + src/common), and an accessor combining
    them into a FirmwareVersion. No NVM or runtime storage needed - the
    identity is fixed in flash per build.
    [fw_version.h]
2026-08-16 pi: add FirmwareVersion decode and format_version() (#55)
    Python counterpart to the shared C++ FirmwareVersion wire type: decode
    (with the same reserved-flag-bit validation) and a format_version()
    helper rendering "v12+2b5c293c" / "v12+2b5c293c-dirty". Not yet called
    from the CLI - that lands with #56's VERSION command.
2026-08-16 row: add row-bus VERSION opcode and post-discovery tile version cache (#56)
    Adds RowBusCmd::VERSION/VERSION_RESP (0x06/0x86) and gives TileMap a
    FirmwareVersion + valid flag per slot. SenseMapper now sweeps Tile Bus
    VERSION across every discovered slot after CLEAR_SENSE, before declaring
    DONE, using the same 5ms/3-attempt retry policy as the rest of discovery
    (~2.5ms added for 8 tiles, against a sequence that already spends ~160ms
    settling). A tile that never answers keeps its cache entry invalid without
    affecting TileStatus - it still passed SENSE mapping. The cache lives on
    TileMap so RE_DISCOVER's map_.reset() clears stale entries for free.
    Deliberately not wired to the error log here: S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
2026-08-16 pi: add `df2-pi version` - flag rows/tiles out of step (#56)
    Cmd.VERSION/Resp.VERSION_RESP (0x06/0x86) plus its 20ms retry timeout, a
    RowVersionReport.decode() for the 64-byte payload, and majority-based
    mismatch detection (version_report.py) with no notion of an "expected"
    version - just "does this differ from what the rest of the floor is
    running". The new subcommand scans both chains, unicasts VERSION to every
    responding row, prints a table, and exits non-zero on any mismatch, dirty
    build, missing tile version, or non-responding row - usable as a bench
    pre-flight check.
    [cli.py, floor.py, test_version_report.py, version_report.py]
2026-08-24 Small changes the original tile, plus a pcba version with alternate parts that are available from JLCPCB.
    Will likely collapse tile and tile-pcba once its confirmed tile-pcba is working
    [bom.csv, designators.csv, positions.csv, tile-pcba.csv, tile-pcba.kicad_pcb, tile-pcba.kicad_sch]
2026-08-24 Updated info on the tile
    [tile.csv]
2026-09-06 Committing all PCB changes. Everything has been sent and received from fab
    [bom.csv, designators.csv, positions.csv, row-controller.csv, row-controller.kicad_pcb, row-controller.kicad_sch, tile-model.step, tile-pcba.kicad_pcb]
2026-09-06 chore: add CLAUDE.md and ignore logic-analyzer captures
    CLAUDE.md indexes the repository layout, build/test commands, the bench
    setup, and the handful of hardware facts that have each cost a debugging
    session (the 3.125 Mbps Row Bus ceiling, /dev/ttyAMA0 vs /dev/serial0, the
    GPIO14/15 mux trap, LED geometry deriving from LEDS_PER_SIDE).
    Saleae exports are evidence for one bench session and don't diff usefully,
    so they stay local; what they showed belongs in the docs instead.
2026-09-06 firmware: derive LED geometry from LEDS_PER_SIDE (40 -> 60 LEDs/tile)
    The strip is 300 LED/5m and the frame's ledge gives ~10" of each 15" side to
    lay it on, so 15 per side is what physically fits: 60 per tile, corners dark.
    Rather than renumber the literals, protocol.h now derives the wire sizes from
    LEDS_PER_SIDE and everything downstream derives from those - MAX_PAYLOAD 180
    and MAX_FRAME_SIZE 187 on Tile Bus, ROWBUS_MAX_PAYLOAD 1448 and
    ROWBUS_MAX_FRAME 1456 on Row Bus, PixelBuffer::NUM_LEDS, and the SET_LEDS
    entry size in the row's SEND_DATA parser. A static_assert holds the line
    where the derivation runs out: Tile Bus's 1-byte LEN caps a side at 20 LEDs
    at 3 bytes each.
    pi_transport_r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
2026-09-06 pi: mirror the 60-LED geometry and add FloorGeometry
    constants.py grows the same LEDS_PER_SIDE / LEDS_PER_TILE / BYTES_PER_LED
    triple the firmware derives from, so MAX_PAYLOAD (1448) and the SET_LEDS
    entry size (181) are computed rather than restated. test_constants.py
    asserts the two sides stay in step - the numbers live in two languages and
    nothing else would catch them drifting apart.
    FloorGeometry is the host-side counterpart: one object that owns the
    mapping between tile coordinates, WS2815 chain order, and floor-space pixel
    positions, so the driver work has somewhere to ask instead of hardcoding 60
    in each layer. It brings in numpy.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
    [geometry.py, test_constants.py, test_geometry.py, test_tile_stress.py]
2026-09-06 tile: implement SET_PATTERN with a tile-local pattern engine
    SET_PATTERN has been a documented no-op since the protocol was written.
    PatternEngine renders it on the tile.
    The motivation is bandwidth, not compute. A full-pixel floor frame is
    ~11.6 kB against a 3.125 Mbps Row Bus ceiling, so pixel frames alone run the
    bus at ~90%. A SET_PATTERN is 12 bytes once, after which the tile animates
    on its own at 50 Hz and the bus goes quiet - which also decouples the
    animation rate from the host's frame rate.
    Two semantics worth stating, both in docs/tile-patterns.md:
    - A pattern is staged by SET_PATTERN and starts on the next LATCH, so a
    row's tiles can be armed one at a time and started to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
2026-09-06 docs: 60 LEDs per tile
    Carries the geometry change through the design docs: 3,840 LEDs floor-wide,
    180-byte SET_LEDS payloads and 187-byte Tile Bus frames, and the revised
    power figures (~6 A per row rather than ~4 A, which takes the supply margin
    from 2.5x to 1.67x and makes the 16 AWG voltage drop the most pressing open
    question in power.md).
    hardware-tile.md gains the "LED layout and chain order" section both the
    firmware and FloorGeometry now point at for the physical facts.
    tile-bus-protocol.md also picks up the SET_PATTERN semantics from the
    previous commit and resolves its param-count open question.
2026-09-06 row: log boot cause and sense-sweep diagnostics to ERROR_LOG
    Three new ERROR_LOG entry types, all diagnostics rather than faults, using
    the only channel that already reaches the Pi with a timestamp attached:
    ROW_BOOT (0x06) one per boot, carrying POWMAN_CHIP_RESET's sticky
    cause bits (POR / BOR / RUN_LOW / the four
    watchdog variants / glitch detect)
    SENSE_START (0x08) one per discovery sweep, with a wrapping counter
    SENSE_EXTRA_SLOT (0x07) a tile assigned to slot 1 or higher, with the
    address that claimed it
    This was to settle a restart ~3.6 s into every power-up that neither bus
    explaine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
    [main.cpp]
2026-09-06 pi: pi-hat loopback test and Row Bus parser recovery
    test_pi_hat_loopback.py is a bring-up test for a new two-chain pi-hat, run
    with no row controllers attached: a Cat5 pigtail bridges the two chains'
    differential pairs at the plug, so each chain's transmit lands on the
    other's receive and the RS-485 physical layer can be checked before any
    firmware is in the loop.
    Writing it exposed a parser bug. RowBus._parser is persistent, so a frame
    that timed out mid-payload left it owed N more bytes, and the next call's
    SYNC1/SYNC2 was silently swallowed as payload instead of resyncing - one
    timeout poisoned every subsequent read. read_frame() now resets the parser
    on timeout; a truncated frame can n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
    [row_bus.py, test_pi_hat_loopback.py]
2026-09-06 docs: Row Bus frame budget for two concurrent chains at 60 LEDs
    §1 now states the two-chain topology as a settled requirement rather than
    leaving it to src/pi/README.md, and §8's timing diagram is redrawn around
    it. The old budget assumed 4 Mbps, which the Pi's UART cannot reach, and
    40-LED frames.
    The honest numbers at 3.125 Mbps and 1,456-byte frames: 18.6 ms of Row Bus
    across two chains plus a 15.0 ms Tile Bus tail is 33.6 ms end-to-end,
    roughly 0.3 ms past the 33.3 ms period. So at full load LATCH_OVERRUN on the
    last row of each chain is the normal case, not an exception - worth saying
    plainly, since §8 previously claimed no overrun could occur. Serializing the
    chains puts it at 52 m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
2026-09-06 tile: fix SET_LEDS never latching - 128-byte RX buffer, table-driven CRC
    SET_COLOR worked and SET_LEDS did nothing. The cause was the receive path,
    not the parser: megaTinyCore's default 64-byte RX ring cannot absorb a
    187-byte SET_LEDS frame arriving back-to-back at 1 Mbps, because the
    per-byte cost of draining it through FrameParser::feed is the same order as
    the 10 us line rate at 20 MHz. The ring overflowed silently, the frame
    failed CRC, and the parser was left mid-payload - swallowing the LATCH that
    followed. A 9-byte SET_COLOR never comes close, which is exactly why short
    commands kept working while the display command went missing.
    SERIAL_RX_BUFFER_SIZE=128 doubles the slack to ~1.2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
    [protocol.cpp]
2026-09-06 pi: add live_demo and decode the row's diagnostic ERROR_LOG entries
    live_demo.py discovers every row on both chains, STATUS-queries each, then
    loops a SET_COLOR phase into a SET_LEDS rainbow while reporting power and
    errors. Written to answer "is the floor alive and why not", so a few
    choices are deliberate:
    - Health polls ask STATUS first. It touches neither I2C nor the Tile Bus,
    so a row that answers STATUS but not POWER is a different failure from
    one that has gone silent, and the distinction is what tells a wedged
    core from a dead supply.
    - POWER is sampled 250 ms after each colour latch, so a rail that only
    sags under load is visible rather than averaged away.
    - -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
    [live_demo.py, tile_brightness_sweep.py]
2026-09-06 docs: correct the bench Pi paths in CLAUDE.md
    It is src/pi that syncs to the Pi, so ~/dance-floor is the package root -
    test/ and src/df2_pi/ are directly under it. The venv there is venv, not
    .venv, and it does not track pyproject.toml: the numpy dependency added with
    FloorGeometry surfaced as a ModuleNotFoundError during collection, which
    reads as a broken test rather than a stale environment.
2026-09-06 pi: mark stale ERROR_LOG entries and raise the default latch delay
    The row's error log is a 32-deep ring that survives across runs of this
    script, so a full log of entries from a previous run is indistinguishable
    from a full log of fresh ones - the timestamps are seconds since the row
    booted, and they simply stop advancing when the row stops logging. Three
    bench runs in a row were misread tonight because of it, twice as "still
    failing" when the log had not changed at all.
    Each poll now diffs against the previous one. The log is append-only and
    emitted oldest-first, so a later read is the earlier one shifted left by
    however many entries were added; recovering that shift gives an exact count.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
    [live_demo.py]
2026-09-06 row: reset the Row Bus parser after an idle gap
    A frame truncated on the wire left a row permanently unreachable.
    RowBusFrameParser cannot resync: mid-payload it takes every byte as payload
    until it has as many as LEN promised, so a following frame's SYNC1/SYNC2 is
    swallowed rather than recognised. Cut a 1,456-byte SEND_DATA short and the
    row owes up to 1,448 more bytes before it reaches the CRC, fails it, and
    returns to SYNC1.
    Nothing supplies those bytes. The host's response to a silent row is a scan,
    and a scan is 8-byte admin frames - a couple of hundred bytes against 1,448
    owed. So the row stays deaf while both cores run normally, the watchdog sees
    a perfectly healthy heartbeat, and t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
    [pi_transport_rp2350.cpp, pi_transport_rp2350.h]
2026-09-06 pi: don't truncate frames on interrupt, and feed the bus while recovering
    Two host-side halves of the stranded-row failure fixed on the firmware side
    in the previous commit.
    RowBus._write() busy-waits for the frame's computed on-wire duration before
    releasing XDIR, with no try/finally - so a Ctrl+C landing in that loop both
    stranded the RS-485 driver enabled and, worse, cut the frame short. One
    interrupted SEND_DATA was enough to leave a row unable to see any further
    frame. The release is now in a finally.
    live_demo's await_recovery() polled STATUS on a deliberately quiet bus,
    reasoning that silence isolates the row from traffic it might be losing
    replies to. For a stuck parser that is exa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
    [live_demo.py, row_bus.py]
2026-09-06 tile: take an address from the row instead of hardcoding 0x01
    Every tile shipped with MY_ADDR = 0x01 and a "TODO: read from EEPROM", so a
    row could not distinguish 8 tiles from one tile answering 8 times, and
    multi-tile addressing did not work at all.
    Tiles now boot as ADDR_UNASSIGNED (0x00) and are named by their row during
    the SENSE walk. SET_ADDRESS (0x06) is broadcast, and has to be: the target
    may hold no address, so there is nothing to unicast to. The SENSE walk
    supplies the selectivity instead - exactly one tile has its incoming line
    asserted at any point in the walk, and a tile whose line is not asserted
    ignores the command entirely. Without that rule a broadcast would have every
    ti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
    [main.cpp, main_native.cpp, protocol.h]
2026-09-06 row: assign tile addresses by position during the SENSE walk
    The walk now names each tile as it finds it. After a slot's DETECT_RESP the
    row broadcasts SET_ADDRESS carrying slot+1 and waits for the 0x86 ACK from
    that address before recording the slot and moving on.
    The address in DETECT_RESP is now deliberately ignored. It reports whatever
    the tile currently holds - ADDR_UNASSIGNED on a fresh boot, a stale
    assignment after a row reset - and trusting it is what made a single tile
    answering repeatedly look like eight distinct ones. DETECT_RESP means "a
    tile is here"; what it is called is decided next.
    A tile that answers DETECT_SENSE and then will not take an address is
    treated as a fault ra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
2026-09-06 Bump ROW_FW_VERSION and TILE_FW_VERSION to 2
    SET_ADDRESS changes src/common/tile_bus_protocol/, which ships in both
    images, so both constants move per #55's rule.
    Also records the rule in CLAUDE.md. It was discoverable only from the
    workflow and the header comments, and the workflow runs on pull_request
    alone - so a push straight to main slips past it, which is how the 60-LED
    geometry and the CRC table landed on main without a bump.
    [fw_version.h]
2026-09-09 pi: verify tiles are rendering by their current draw
    Display commands carry no ACK by design, STATUS reports a tile map frozen at
    discovery, and the row never re-checks a tile afterwards - so a tile that
    stops rendering is invisible to every channel this script had. Supply current
    is the only signal that comes from the tiles rather than from the row talking
    about them, and the row's INA226 already measures the whole row.
    live_demo now calibrates against the attached hardware at startup (dark
    reading plus one lit frame), predicts the draw each commanded frame should
    cause, and compares. On a confirmed mismatch it lights each tile alone and
    names the ones not drawing their share; per-tile dra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
2026-09-09 row: report uptime, protect the boot entry, retire a false-positive diagnostic
    Three changes to make a row's own account of itself trustworthy. All three
    came out of a bench failure where the row rebooted, the tiles held their last
    frame, and nothing in the logs said so.
    STATUS_RESP gains uptime_s (uint32, big-endian, bytes 10-13). "Did this row
    restart?" had no direct answer: the only clock the Pi could see was the
    newest ERROR_LOG timestamp, which advances only while the row is logging -
    i.e. almost never on a healthy row - so a stale clock and a steady one were
    indistinguishable. 32 bits because a uint16 of seconds wraps at 18.2 hours
    and a floor is expected to run longer than that; a wr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
    [fw_version.h, main.cpp]
2026-09-09 pi: use the row's reported uptime to detect reboots
    health_poll prints uptime and flags a reboot when it goes backwards, which is
    now a direct observation rather than an inference. The previous heuristic -
    watching the newest ERROR_LOG timestamp drop - is kept only for firmware
    without the field, because on a healthy row that clock stops advancing and a
    stale log is indistinguishable from a steady one. It missed a real reboot on
    the bench for exactly that reason.
    A STATUS payload shorter than 14 bytes is treated as older firmware rather
    than a malformed reply, so this runs against both. `df2-pi status` shows
    uptime on the same terms.
    Decodes the new tile_no_version (0x09) entry and drops t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
    [cli.py, live_demo.py]
2026-09-09 row: table-driven Row Bus CRC, and record what the receive path costs
    crc16 on the Row Bus side becomes table-driven, matching what the Tile Bus
    side got with the SET_LEDS fix. Every received byte passes through it inside
    poll()'s drain loop, which is the one loop on this path with no margin. The
    win is small here - roughly 5% of the per-byte cost at 150 MHz, against a
    large fraction at 20 MHz on the ATtiny - but it is 512 bytes of flash on a
    2 MB part and the known-vector test already covers correctness.
    The rest is a comment, and it is the more useful half. Measured on the bench
    across seven frame sizes with forwarding held constant, a row ingests Row Bus
    bytes at ~6.0 us each against a 3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
    [fw_version.h, pi_transport_rp2350.cpp]
2026-09-09 pi: add a chain saturation test
    docs/row-bus-protocol.md §8 budgets a floor update as the Row Bus phase plus
    one row's Tile Bus tail, and concludes 30 FPS is approximately reachable.
    That model counts only forwarding work. It does not count what a row spends
    receiving - and because address filtering happens after a frame is assembled,
    a row parses every byte on its chain, not just the frames addressed to it.
    This drives that case directly: a full-size SEND_DATA to every row slot on a
    chain plus a LATCH, at a target rate, for a set duration. Frames addressed to
    absent rows are the point rather than a flaw - they load the receive path
    exactly as neighbours would, which is what lets a one-row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
2026-09-09 row: count and report Row Bus CRC failures
    A corrupted link was invisible. Frames that fail the check are discarded, and
    nothing anywhere counted them - so STATUS, uptime, and every entry in the
    error log kept reporting a perfectly healthy row while the wire mangled
    frames. error_type 0x02 has been specified since the protocol was written and
    never had a producer.
    RowBusFrameParser now tallies failures, core 0 publishes the running total,
    and core 1 logs it batched: slot and tile_bus_cmd carry how many failed since
    the last entry, saturating at 0xFFFF, rate-limited to one entry per 5 s. A
    count rather than one entry per failure because a bad link produces them in
    floods and would evict ever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
    [main.cpp]
2026-09-09 pi: decode CRC-failure counts in the error log
    error_type 0x02 carries a count in the slot/tile_bus_cmd fields rather than a
    slot and a command, so the generic line misreads it. Any non-zero value means
    the Row Bus link is corrupting frames - the one condition nothing else on the
    row reports.
    [live_demo.py]
2026-09-09 docs: the worst-case frame rate is ~25 FPS, limited by receive
    §8 modelled the Row Bus phase plus the Tile Bus tail and concluded 30 FPS was
    approximately reachable. It did not model what a row spends receiving, and
    that is the binding constraint: address filtering happens after a frame is
    assembled, so every row parses every byte on its chain, including the three
    frames meant for its neighbours.
    Measured with test_chain_saturation.py on one row carrying a full chain's
    worth of worst-case frames: 25 FPS passes, 27 FPS logs ROW_BUS_RX_OVERFLOW,
    30 FPS restarts the row. A row ingests at ~6.0 us/byte against the 3.2 us/byte
    the wire delivers, so a chain's 5,824 bytes costs 34.9 ms of core-0 t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
2026-09-14 pi: TileFrame and PixelFrame frame data structures
    The two LED formats animations write into (#60): TileFrame is one flat
    colour per tile, PixelFrame is every LED in WS2815 chain order so the
    encoder can slice a tile's bytes with no reordering. PixelFrame derives
    the 136x136 image view from FloorGeometry's tables - `grid` scatters,
    `from_grid()` samples only lit cells (strict=True raises on dark writes),
    and `grid_view()`/`commit()` skip the per-access allocation.
    to_tiles() and blend() work in linear light, gain() on the encoded bytes.
    The gamma curve they share seeds encode.py ahead of the FrameEncoder
    (#63), so the preview and the floor can never disagree about what a byte
    means; from_li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
    [encode.py, geometry.py, pixels.py, test_encode.py, test_pixels.py]
2026-09-14 pi: edge-aware access - edges, seams, rings, rails, EdgeGraph, painting
    The structural view of the floor (#61): not a grid of pixels but 256 runs
    of 15 LEDs. edges.py gives each tile side an Edge ordered in floor
    orientation - horizontal runs west->east, vertical runs south->north,
    whatever the chain does - so effects cross tile boundaries without
    zigzagging. FloorGeometry grows `edges`, `seams` (the 112 facing pairs,
    a.leds[i] opposite b.leds[i]), `floor_ring` (480 LEDs, one ordered loop),
    `tile_ring`, `rails` and `edge_graph()`, all built once and cached.
    EdgeGraph makes the lightning bolt a walk: edges are nodes, adjacent
    where they share exactly one tile corner (a seam partner shares bo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
2026-09-14 Add some additional missing STEP files for the kicad to export.
    Saved the resulting export, also a STEP file, for use in Fusion360
    [Anderson_Powerpole_PP15_PP45.STEP, XIAO RP2350_.step, row-model.step]
2026-09-14 Updated the power test to also blink the status and ready lights.
    This gives tests about as much as we can without connecting it to something else.
2026-09-14 A PDF template for 1" x 0.25" labels, used to label the pin header connecting to a tile.
2026-09-14 Save models we export from Fusion360
    [Tile Controller Case.3mf]
2026-09-14 Added a new tool to help test LED strips as they are being built.
    Its a simple ESP32 program that runs through some patterns, controlled by a switch, and helps verify everything was soldered correctly on a strip
    [main.cpp]
2026-09-14 pi: animation package - file format, metadata, discovery, safe loading
    The authoring contract (#62): an animation is one plain Python file with
    an @animation-decorated render(previous, ctx) function; the filename
    stem is its stable id. `animation/meta.py` validates the metadata at
    import time (format, Param specs and their defaults, effect writes) and
    keeps unrecognised keywords in `extra` for the UI. `FrameContext`
    carries frame/t/dt/fps, resolved params, geometry, a per-run state dict
    and seeded rngs - both random.Random and a numpy Generator, since the
    edge-walk API takes the latter - and collects effect writes.
    `AnimationRun` upholds the contract from the driver side: it freezes
    `previo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
    [effects.py, test_animation_loader.py]
2026-09-14 pi: frame encoder - Frame -> SEND_DATA, brightness and gamma
    FrameEncoder (#63) turns a rendered frame into one SEND_DATA payload per
    row. Each tile entry picks its own command: a uniform tile goes as
    SET_COLOR (4 bytes) instead of SET_LEDS (181), so a TileFrame row is 32
    bytes and the fully addressed worst case stays 1,448. `uniform_tolerance`
    collapses near-uniform tiles too. Effect writes collected during render
    become 6-byte SET_EFFECT entries in place of that tile's pixel entry for
    the frame, so an effect change latches with the frame it was made on.
    The colour pipeline decodes the frame's gamma-encoded bytes to linear
    light, applies brightness and per-channel white balance there, and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
2026-09-15 pi: FrameClock - drift-free 30 FPS scheduler with timing telemetry
    engine/clock.py (#64). Frames are scheduled against a running deadline
    sequence, deadline_n = anchor + n/fps, never relative sleeps, so tick.t
    advances by exactly one period however late a frame actually rendered.
    The deadline is the LATCH moment: the loop body prepares frame n and the
    clock waits for the deadline, fires the latch callable, and yields the
    next tick, so the jitter it reports is measured where it is visible.
    Overruns skip, never catch up: a frame ready within half a period of its
    deadline latches immediately as jitter; later than that, the missed
    deadlines are dropped and counted and the frame latches on the n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
    [clock.py, test_clock.py]
2026-09-15 pi: Floor.send_rows() drives both chains concurrently
    The frame-update path. Rows are dealt to their chains and sent in
    rounds - one frame started on every chain via start_write(), wait for
    the slowest to clear the wire, finish_write() them all - so a full floor
    with the alternating map is 4 rounds of two frames rather than 8 back to
    back. That is the concurrency docs/row-bus-protocol.md section 1 makes a
    requirement; a loop of send() calls serialises the chains and the 33 ms
    budget does not close. Single-chain floors degrade to sequential sends.
2026-09-15 pi: output sinks - fan-out to hardware plus any number of observers
    The `output` package (#65) and the rule that keeps it from wrecking the
    frame clock: nothing except the hardware sink may ever block it. Every
    observer runs on its own thread behind a single-slot, latest-wins
    Mailbox, so `submit()` returns in microseconds whatever the consumer is
    doing; a slow consumer sees fewer frames and the floor never notices.
    No unbounded queues anywhere.
    HardwareSink is the exception: synchronous on the render thread, it
    encodes and puts every row on the wire with Floor.send_rows(), and
    exposes latch() for the clock to fire at the deadline. Serial failures
    are counted into a health flag, never raised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
    [test_output.py]
2026-09-15 pi: playlist store - SQLite schema and CRUD
    `playlists` (#66): the four tables from the issue plus a version stamp,
    a forward-only migration runner where each migration is one atomic
    script, and PlaylistStore over stdlib sqlite3 - no ORM. WAL mode with a
    connection per thread so the web thread writes while the render thread
    reads; `:memory:` databases exist per connection, so those share one
    connection behind a lock.
    Animations are not rows: an entry names a module stem, and one whose
    animation is missing or failed to load resolves as unresolved with the
    registry's load error and is skipped, never deleted. Durations are
    always explicit, `add_entry(duration_s=None)` taking the
    default_entry_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
    [test_playlist_store.py]
2026-09-15 pi: playlist runner and thread-safe control API
    engine/runner.py (#67) ties the driver together: per tick it drains the
    control queue, advances the playlist when the current entry's explicit
    duration has elapsed, renders through AnimationRun, and submits the frame
    and its effect writes to the FanOut; the clock latches at the deadline.
    Control commands - play/pause/resume, next/previous/goto/restart,
    load_playlist, play_animation (one-off, then back), set_params,
    set_brightness, blackout/unblackout, stop - are queued from any thread
    and applied only at frame boundaries, so the hot path needs no locks.
    RunnerState is an immutable per-frame snapshot with everything the
    admin page needs, includi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
2026-09-15 pi: df2-pi play, animations, playlists, ledwalk, tilewalk and dev sinks
    The driver becomes runnable (#68), and animations become writable on a
    laptop with no floor attached. `df2-pi play` runs the startup playlist,
    a named one, or a single animation with --param overrides coerced
    through its Param specs, on the floor or on development sinks:
    --terminal (ANSI truecolour half-blocks for the full grid, or the 8x8
    tile view, self-limited to 10 FPS with a 256-colour fallback), --window
    (pygame, the preview renderer: top-down, fixed per-LED bloom, additive),
    and --record to .gif / .mp4 (imageio) or .df2rec via a synchronous
    FrameCollector so nothing is dropped. All of them draw through
    to_display(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
    [cli.py, encode.py, row_bus.py, runner.py, test_cli.py]
2026-09-15 pi: terminal grid puts every horizontal tile seam on one half-block line
    A character row shows two grid rows, and 17-cell tiles are an odd pitch,
    so the pairing drifted by one row per tile row: alternate seams rendered
    as a clean double line or as two thin lines with a dark half-row between
    - the banding Garth saw in the terminal. Repeating each tile's middle
    row (dark interior, lit sides, so the vertical edges stay unbroken)
    makes the pitch 18, and one blank row on top lands every seam on a
    single character row.
    [test_cli.py]
2026-09-15 pi: starter animation pack and authoring guide
    Eight animations in src/pi/animations/ plus a commented _template.py
    (#69), each short and readable as a tutorial and each exercising one
    part of the API: solid (the file to copy), rainbow_sweep (position and
    time), checkerboard (ctx.state and a seeded random walk), plasma
    (PixelFrame.from_grid on a numpy image), ripple (led_positions distance
    fields, splat, fading trails), lightning (EdgeGraph.walk and branch -
    the bolt the design was shaped around), chase (floor_ring), and seams
    (the facing edge pairs, pulsing in lockstep as a visible wiring check).
    seams also shows the habit of gathering index arrays once into
    ctx.state, which is what keeps a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
2026-09-16 pi: scan test accepts the 14-byte STATUS and names the newer log entries
    test_row_bus_scan.py still required the 10-byte STATUS payload from before
    uptime_s was appended, so every row failed the STATUS check on current
    firmware. Accept 10 (pre-uptime firmware) or 14 and print the uptime.
    Also name ROW_BOOT, SENSE_START and TILE_NO_VERSION entries instead of
    printing unknown(0x06)/(0x08)/(0x09), and decode CRC_FAILURE's repurposed
    slot/tile_cmd as the count it is.
    [test_row_bus_scan.py]
2026-09-16 docs: eight-row Row Bus bring-up measurements, 2026-09-15
    First bench run with all eight row controllers on the two-chain pi-hat.
    Records the row-side ingest ceiling (25 fps passes, 27 fps watchdog-resets,
    limit tracks bytes/s), the host taking ~48 ms per floor update against the
    33 ms budget, a clean 10-minute CRC soak, and per-row idle draw.
    Also answers row-bus-protocol.md's open question about overloaded rows
    reporting HAD_POR with no watchdog bit: the SDK watchdog resets via PSM,
    which never touches POWMAN_CHIP_RESET, so a watchdog reset is
    indistinguishable from a power-on there until log_boot() also reads
    WATCHDOG_REASON.
2026-09-16 pi: compute the Row Bus CRC with binascii.crc_hqx
    The bit-at-a-time Python loop cost 2.5 ms per 1448-byte SEND_DATA payload
    on the Pi 5 - 20 ms of every 33 ms frame just to checksum eight rows.
    binascii.crc_hqx is the same CRC-16/CCITT-FALSE in C. Tests pin it to the
    bit-loop definition on full-size random payloads and a non-default seed.
2026-09-16 pi: queue Row Bus frames with os.write() so the two chains actually overlap
    pyserial's Serial.write() follows each os.write() with a select() for
    writability, and Linux only reports a tty writable once fewer than 256
    bytes remain in its transmit buffer. A 1,456-byte SEND_DATA therefore held
    the caller for 3.8 ms of its 4.7 ms on the wire, so Floor.send_rows() could
    not start chain 1's frame until chain 0's was ~80% sent and a floor update
    took ~48 ms against the 33 ms budget. Frames under 256 bytes never hit it.
    start_write() now hands the frame to the kernel with os.write() directly,
    which returns in ~80 us, and waits on select() only if the non-blocking fd
    reports a full buffer. send_rows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
2026-09-25 docs: define HUE_SPLIT (6) and FADE (7), drop BREATHE (#72)
    FADE decays per 20 ms tile frame rather than per LATCH, so tail length
    is independent of host frame rate and a tail finishes when the host goes
    quiet. HUE_SPLIT takes the split position as an LED offset so the doc
    doesn't depend on chain layout.
    Claude-Session: https://claude.ai/code/session_01NSinxQ9E1xFe58J4VZu1dt
2026-09-25 firmware: rename SET_PATTERN to SET_EFFECT (#72)
    Naming only: wire code stays 0x11, payload stays 5 bytes. Updates the
    shared Cmd enum, the row controller's SEND_DATA forwarding switch, the
    tile handler and tests, and doc references to docs/tile-effects.md. The
    tile's PatternEngine keeps its name until its semantics move to the
    effect-register model.
    Bumps ROW_FW_VERSION 5->6 and TILE_FW_VERSION 2->3 (shared protocol.h).
    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
2026-09-25 pi: drop TileCmd.SET_PATTERN, renumber effect ids per tile-effects.md (#72)
    SET_EFFECT was already an alias for 0x11; the old name goes. FADE and
    HUE_SPLIT move from the provisional 1/2 to 7/6, matching the numbering
    settled in docs/tile-effects.md, and SHIMMER (3) and CHASE (4) are
    added. Encoder tests use the constants, so they follow automatically.
    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
2026-09-25 docs: rename SET_PATTERN to SET_EFFECT across protocol docs (#72)
    tile-bus-protocol §5.2 now describes the effect register: independent of
    the pixel buffer, staged until LATCH, id 0 clears without blanking.
    tile-effects.md renames OFF to NONE to match the host and #72.
    Row Bus BLACKOUT now specifies a SET_EFFECT(0) per tile alongside the
    SET_COLOR(0,0,0) sweep: with pixel commands no longer cancelling an
    effect, SET_COLOR alone would leave an overlaying effect running. The
    row firmware change is noted as pending.
    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
2026-09-25 tile: target ATtiny3226 instead of ATtiny3224
    The JLCPCB-assembled board (pcb/tile-pcba) carries the 20-pin ATtiny3226
    since that is what JLCPCB stocks. Verified against its fab netlist and
    U1 symbol: LED_DATA PA1, SENSE_IN PA2, SENSE_OUT PA3, XDIR PB0, TXD PB2,
    RXD PB3 - the same port pins as the 3224 board, and megaTinyCore's txy6
    variant keeps the default USART0 mux on PB2/PB3. So pins.h is unchanged
    apart from its provenance comment; the ATtiny3224 build envs are
    replaced by ATtiny3226 / ATtiny3226_led_test.
    TILE_FW_VERSION was already bumped on this branch.
    Claude-Session: https://claude.ai/code/session_01NSinxQ9E1xFe58J4VZu1dt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
    [pins.h]
2026-09-25 docs: tile MCU is now the ATtiny3226
    Rename throughout, record in hardware-tile.md why the part changed and
    that the port-pin wiring is identical, and list pcb/tile-pcba as the
    current tile board.
    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
2026-09-25 tile: effect register - NONE, SHIMMER, CHASE, HUE_SPLIT, FADE (#72)
    Replaces PatternEngine with EffectEngine. The LEDs now always show
    buffer -> effect -> output buffer; the effect never writes the pixel
    buffer, so the host can change content under a running effect.
    - SET_EFFECT stages; LATCH commits (restarting the effect's clock) and
    always re-renders, so new buffer contents go out through the effect.
    - SET_COLOR / SET_LEDS no longer cancel the effect.
    - NONE passes the buffer through; it no longer paints black. SOLID is
    gone; ids 1, 2 and 5 are rejected.
    - CHASE: hue/brightness/speed/spacing marquee, ms-accurate accumulating
    step clock. HUE_SPLIT: stateless RGB-space hue shift, opp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
    [main.cpp, main_native.cpp]
2026-09-25 row: bulk Row Bus parsing, parser-side address filter, and a receive ring reader
    RowBusFrameParser gains a bulk feed() that takes a whole payload in one
    tight loop instead of a state-machine dispatch per byte, and stops just
    after a completed frame so the caller can hand back the rest. It behaves
    exactly like byte-at-a-time feeding; the tests hold it to that across
    chunkings from 1 byte to a whole chain of frames.
    set_address() makes the parser drop frames for other rows itself. They are
    still CRC-checked, so crc_failures() keeps covering the whole chain, but
    their payload is neither stored nor copied out.
    RxRing is the read side of a power-of-two byte ring written by hardware -
    the index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
2026-09-25 row: receive the Row Bus by DMA, and bound core 0's frame loop
    Serial2 cost ~6 us per received byte - two mutex-and-IRQ-toggling FIFO
    pumps per byte - against 3.2 us/byte arriving, capping a chain of four
    maximum-size frames at ~25 fps. The Row Bus now runs on UART1 through the
    pico-sdk: a DMA channel in ENDLESS ring mode copies every byte into a 16 KB
    ring as it arrives, and poll() parses straight out of it with the bulk
    parser, which also drops other rows' frames without copying them. The CPU
    does no per-byte work to receive. A lapping guard discards the ring and
    reports a receive overflow if the reader ever falls within 4 KB of a full
    lap or goes ~39 ms unpolled.
    Core 0's loop now return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
2026-09-25 row: give the ENDLESS receive DMA a non-zero transfer count
    An ENDLESS channel triggered with a count of 0 halts immediately (RP2350
    datasheet 12.6.2.2.1), so the receive ring never filled and row 0 went
    mute on the bench. ENDLESS does not decrement the count; any non-zero
    value runs forever.
2026-09-25 pi: drop the ~25 fps receive ceiling from encoder and saturation-test docs
    Row firmware v6 receives by DMA and keeps up at 50 fps, so the encoder no
    longer cites the row's receive path as the limit, and the saturation test
    notes it now serves as the regression test for that path.
2026-09-25 docs: row DMA receive measured to 50 fps
    Replaces row-bus-protocol.md's ~25 FPS receive-ceiling section with the v6
    DMA ring and its measurements, and records the 2026-09-24 bench run: row 0
    passed worst-case chain saturation at 30/35/45/50 fps and a 10-minute
    30 fps soak with no restarts or CRC failures.
2026-09-25 docs: row 0 had four undiscovered tiles during the DMA receive run
2026-09-25 docs: DMA receive rerun with row 0 forwarding to three tiles
2026-09-25 row: log the watchdog's own reset reason in ROW_BOOT
    ROW_BOOT carried only POWMAN_CHIP_RESET, but the SDK's watchdog resets the
    chip through PSM, which never touches POWMAN: a watchdog timeout set no
    HAD_* bit and left the POR bit from the original power-up in place, so it
    was logged exactly like a power cycle. Every overload reset on the
    2026-09-15 bench run was misreported that way.
    The cause word now carries WATCHDOG_REASON.TIMER in bit 13 and .FORCE in
    bit 14, above the 13 POWMAN bits, so no protocol change is needed. POR
    alone is a power cycle; POR plus bit 13 is a watchdog timeout.
    Closes #101.
    [main.cpp]
2026-09-25 pi: decode ROW_BOOT's watchdog timeout and forced-reset bits
    live_demo.py names the two new cause bits; the scan test prints the cause
    word as hex instead of a meaningless slot/tile_cmd.
    Refs #101.
    [live_demo.py, test_row_bus_scan.py]
2026-09-25 docs: v6 rollout to all eight rows, and tiles that ignore BLACKOUT after playback
    Records the floor-wide verification after #102: every row on v6+3a15f42b,
    POR-only boot causes after the power cycle, scan and saturation passing on
    the last row of each chain, and a clean 10-minute 30 fps soak.
    Also records an open tile problem found while blacking out after the soak:
    some tiles ignore BLACKOUT after playback until a full-size frame passes,
    consistent with a tile parser stuck mid-frame and no idle-gap reset in the
    tile transport.
2026-09-26 common: define the tile's deaf window after LATCH
    TILE_LED_PUSH_US is how long a tile cannot receive after acting on a
    LATCH: the WS2815 push is bit-banged with interrupts off, 24 bits x 1.25 us
    per LED, 1.8 ms at 60 LEDs. Anything sent on the Tile Bus meanwhile is lost
    and can leave the tile's parser stuck mid-frame (#104).
    [protocol.h]
2026-09-26 row: keep the Tile Bus quiet while tiles push their LEDs after LATCH
    Every Tile Bus LATCH now opens a TILE_LATCH_QUIET_MS window (4 ms at 60
    LEDs) in which the row sends nothing: forwarding pauses, and a BLACKOUT or
    LATCH arriving in the window is queued and sent in order when it ends. The
    window is timed from the first poll() after the LATCH, so it can only err
    long.
    Without it the row forwarded straight into the tiles' interrupts-off LED
    push. On the bench a BLACKOUT straight after a LATCH - what df2-pi play
    sends on exit - left tiles stuck 10/10 times (0/10 with a 5 ms gap), and
    small pipelined frames arriving just after each LATCH did the same 9/10
    times.
    ROW_FW_VERSION 6 -> 7 (src/com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
    [fw_version.h]
2026-09-26 tile: abandon a part-received Tile Bus frame after 5 ms of silence
    A frame cut short left the parser taking every following byte as payload
    until LEN was satisfied, so small frames like BLACKOUT's SET_COLORs were
    swallowed and the tile stayed on its last frame until a full-size frame
    came along. TransportAT::poll() now resets the parser after 5 ms with
    nothing received; a 187-byte frame takes 1.87 ms, so that gap only falls
    between frames.
    The row's quiet window after LATCH removes the loss that caused #104; this
    makes any other loss cost one frame instead of the tile.
    TILE_FW_VERSION 2 -> 3 (src/common changed too).
    Refs #104.
    [fw_version.h, led_driver_at.cpp, main.cpp, transport_at.cpp, transport_at.h]
2026-09-26 docs: tiles are deaf after LATCH; the row keeps the Tile Bus quiet
    tile-bus-protocol.md's LATCH section assumed no traffic arrives while a
    tile pushes its LEDs. Small frames and a BLACKOUT straight after a LATCH
    break that. It now states the deaf window, the row's 4 ms quiet rule and
    the tile's 5 ms idle reset, and records the #104 root cause in the
    2026-09-24 measurements.
2026-09-27 tile: don't push effect renders on the tile's own clock while the host streams
    A tile running an effect pushed the strip every 20/40 ms on its own clock,
    and each push leaves it deaf for ~1.8 ms at a moment the row cannot know
    about. On the bench, with CHASE running, that lost 5% of small frames, 20%
    of full SET_LEDS frames and ~9% of BLACKOUTs (#106).
    EffectEngine::host_streaming() is true once two LATCHes have arrived within
    STREAM_HOLD_MS (100 ms) of each other and the latest is that recent. While
    it is, loop() pushes only on LATCH - inside the row's quiet window - and
    skips the pushes poll() asks for. poll() still advances the effect, so each
    LATCH shows it exactly where a free-running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
    [fw_version.h, main.cpp]
2026-09-27 row: send BLACKOUT's sweep three times, one quiet window apart
    A tile running an effect is deaf for ~1.8 ms of every render on its own
    clock, and missed a single BLACKOUT sweep ~4.5% of the time on the bench,
    so a floor-wide BLACKOUT would almost never have caught all 64 tiles
    (#106). The sweep - SET_EFFECT(NONE) + SET_COLOR(0,0,0) to each tile, then
    LATCH - is idempotent, and a tile that got it has stopped its effect and is
    listening, so BLACKOUT_SWEEPS = 3 takes a miss to ~0.01% per tile for two
    extra quiet windows. A LATCH or SEND_DATA arriving after the BLACKOUT waits
    for every sweep, so a late sweep cannot black out new content.
    ROW_FW_VERSION 8 -> 9.
    Refs #106.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
    [fw_version.h]
2026-09-27 pi: effects.py no longer claims only NONE and SHIMMER are implemented
    [effects.py]
2026-09-27 Added a few models for fusion360
    [Tile Controller Case.3mf, pi-hat-model.step]
2026-09-27 pi: web app skeleton - FastAPI app, runner lifecycle, page shell, /healthz
    `df2-pi serve` runs the floor with the admin UI (#70). create_app() builds
    a FastAPI app from an explicit AppContext (registry, store, fan-out,
    runner, preview sink). Its lifespan loads the startup playlist as
    `df2-pi play` does and starts the runner on a daemon thread; shutdown is
    stop() then join(), so a deploy restart blacks out and latches before the
    process exits. /healthz is 200 while the render thread is alive, 503 after.
    The page shell is Preact + htm + signals, vendored as ESM builds under
    static/vendor/ behind an importmap - no build step, no CDN. Server state
    lives in signals in state.js, polled from /api/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
2026-09-27 pi: transport API - runner control and the state snapshot over HTTP
    GET /api/state serves RunnerState as-is; eleven POSTs under
    /api/transport/ queue play, pause, resume, next, previous, goto, restart,
    load, a one-off animation, brightness and blackout, each returning
    {"queued": true, "state": ...}. Commands apply at the next frame boundary,
    so the returned state may predate them; the OpenAPI description says so.
    Pydantic validates every body, an unknown animation or playlist is a 404,
    and params are coerced through the animation's Param specs (422 with the
    spec's message), so invalid input never reaches the runner. Percentiles
    are NaN until their window fills and go out as null; the publis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
2026-09-27 pi: pay numpy.ma's lazy import at clock import, not in frame 0
    np.percentile's first call imports numpy.ma (np.unique checks
    is_masked). The runner snapshots telemetry every frame, so that ~11 ms
    landed in frame 0: 11.5-13.3 ms against 12.5 ms of budget at 120 fps
    on the bench Pi 5, where test_no_hardware_frames_10_runs_end_to_end
    dropped a frame in up to 6 runs of 8. The import's allocations also set
    off a gen1 collection inside the same frame. clock.py now makes one
    percentile call at import; frame 0 measures 0.5 ms, the same as steady
    state.
    The CLI smoke test runs on a fake clock, so "0 dropped" checks the
    scheduler, not how busy the host is. The new
    test_render_loop_imports_nothing is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
2026-09-27 pi: registry reload publishes new dicts instead of mutating the live ones
    The render thread iterates registry.errors every frame (the runner's state
    snapshot), and #88 lets a web request call reload() on another thread. A
    reload that added or removed an entry mid-iteration would raise "dictionary
    changed size during iteration" on the render thread and end playback.
    reload() now builds the next animations and errors on copies and publishes
    each with one assignment; a reader holding the old dict finishes
    undisturbed and needs no lock. Concurrent reloads are serialised by a lock.
    Refs #88.
    [test_animation_loader.py]
2026-09-27 pi: animations API and the Animations tab
    GET /api/animations serves what the registry loaded - id, name,
    description, author, format, tags, period, the Param specs with the type
    as a name, extra verbatim - and every file that failed, with stage,
    message and path. GET /api/animations/{id} is one; a failed id is a 404
    carrying its load error. POST /api/animations/reload re-imports what
    changed and returns the changed ids and current errors. Paths are
    relative to the animations directory, and the directory is scrubbed from
    messages, so an absolute path never leaves the Pi. An animation whose
    last reload failed is served with that error beside it: the last good
    version is still the live one. A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
    [test_web_animations.py]
2026-09-27 pi: the preview sink reports its subscriber count in sink health
    FanOut.state() now picks up `subscriber_count`, which PreviewSink
    exposes, so /api/state shows how many browsers are watching the preview
    and a disconnect that failed to unsubscribe is visible (#91).
    Refs #91.
    [test_output.py]
2026-09-27 pi: live preview transport - WS /ws/preview over PreviewSink
    A WebSocket per browser, fed by PreviewSink: each binary message is one
    record exactly as encode_preview produced it, per client `format`
    (full | tiles) and `fps`, changeable mid-stream with a text message. A
    bad query is refused with 1008; the socket closes with 1001 when the sink
    drops the subscriber or shuts down. Disconnect unsubscribes.
    Flow control is by ack. The kernel's socket buffers take megabytes, so
    on a bare socket a slow client lagged seconds behind rather than skipping
    (measured: 1.5 s of stall delivered every one of 92 frames, in order,
    afterwards). The client now acks with {"ack": FRAME_NO}, covering every
    record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
    [test_web_app.py, test_web_preview.py]
2026-09-27 pi: live preview renderer - the floor drawn in the browser
    preview.js draws each record from the #91 stream on one <canvas>: every
    LED a point of light with one fixed bloom, added on black, top-down with
    row 0 along the bottom. The look is render_bloom's (output/dev.py)
    evaluated per pixel - a core a third of a cell across plus a gaussian of
    sigma 1.6 cells peaking at 1.4/pi - as one WebGL draw call of 3,840
    points blended ONE+ONE. LED positions come from /api/preview/geometry; a
    `tiles` record paints each tile's LEDs its colour. It draws only when a
    record arrives and resizes with its container, square.
    WebGL only. A 2D fallback (a tinted sprite per LED channel, "lighter"
    compositing) took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
    [test_preview_reference.py]
2026-09-27 pi: live param controls, generated from the Param specs
    POST /api/transport/params {"speed": 2.0} live-tunes the running
    animation. Every value is coerced through that animation's Param spec
    before it reaches the runner: an unknown name or a value out of range is
    a 422 whose detail names the param ({"param", "message"}), so the page
    can show it on the right control; with nothing tunable playing (the idle
    animation) it is a 409.
    params.js turns specs into controls - a slider for bounded int/float
    (int steps by 1, the default marked under the track), a number input
    unbounded, a select for choices, a switch for bool, a text input for str
    - each with its label, help as a tooltip and a reset to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
    [test_web_transport.py]
2026-09-27 pi: playlists API and the Playlists tab
    Full CRUD over the PlaylistStore: list, create, read, update and delete
    playlists; add, update, move and remove entries; set the startup
    playlist; read and update the typed settings (brightness, fps,
    default_entry_duration, startup_playlist).
    A playlist is served resolved - each entry with its animation's name,
    format and period, or unresolved with the reason, never dropped - and
    with both the overrides stored (only diffs from the defaults) and the
    full params it would play with, plus any clamp warnings. Every write
    answers with the whole playlist. Store errors map to 404 (no such
    playlist or entry, including an entry of another playlist), 409 (a name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
    [test_web_playlists.py]
2026-09-27 pi: brightness is persisted, and serve starts at it; settings drop fps
    The page's brightness slider changed only the running runner, so every
    restart - a deploy, a reboot - put the floor back at full brightness,
    while the brightness setting the API served was never read by anything.
    POST /api/transport/brightness now also stores the value as the
    brightness setting, and `df2-pi serve` starts at the stored brightness
    unless --brightness is given (which applies to that run only). A
    brightness sent to PATCH /api/settings is applied to the floor at once as
    well as stored, so the two never disagree.
    fps is no longer a setting in the API: nothing read it, and the frame
    rate is not something to ad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
    [cli.py, test_web_app.py, test_web_playlists.py, test_web_transport.py]
2026-09-28 pi: Runner.call, the hardware sink's Row Bus load, and structured row reports
    What the diagnostics panel (#94) needs from the driver:
    - Runner.call(fn) runs fn on the render thread at the next frame
    boundary and returns a future: the way to make a Row Bus admin request
    that must not overlap a frame on the wire.
    - HardwareSink.encode_stats: the last frame's bytes and estimated wire ms
    per row, summed per chain from the floor's chain map, and the slowest
    chain. FanOut.state() reports it, and the sink's last_error, in the
    sink health that /api/state serves.
    - EncodeStats.row_seconds(): each row's SEND_DATA time on the wire.
    - row_status.RowStatus decodes a STATUS reply; `df2-pi statu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
2026-09-28 pi: diagnostics - floor admin requests over HTTP and the Diagnostics tab
    GET /api/floor/status and /api/floor/version run `df2-pi status` /
    `df2-pi version`'s queries against the attached floor and return JSON:
    per-row state, tiles found and uptime; firmware per row and tile with
    what is out of step. POST /api/floor/blackout sends the BLACKOUT
    broadcast itself - it mutes nothing, unlike the transport blackout. Each
    request waits for a row's reply, so each runs on the render thread at a
    frame boundary via Runner.call, one row per boundary: a row that answers
    costs a frame a millisecond or two of its slack, one that does not costs
    at most one frame. Without a floor they are 503.
    The Diagnosti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
2026-09-28 pi: firmware versions name the majority and tell an empty slot from a silent tile
    The versions check has no expected version: a row or tile is out of step
    when it differs from what most of the floor runs. The page now shows
    those majorities, so it is clear what everything is compared against.
    A tile with no version was "no version" whatever the reason, because
    VERSION's tiles_valid bit is clear both for a slot never discovered and
    for a tile found but never answering. /api/floor/version now asks each
    row's STATUS too and labels the slot from its tile_status: "empty", "no
    version" (found, silent), "not responding" or "test failed". An empty
    slot is not out of step, so a partly populated floo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
    [floor.py, test_version_report.py, test_web_floor.py, version_report.py]
2026-09-28 tile: stamp the last commit that changed the tile's sources, not HEAD
    FW_GIT_SHA was HEAD at build time, so a rebuild of unchanged firmware
    from a checkout that had moved on - a CAD model, a host-side PR - carried
    a new identity, and the floor's version check flagged identical tiles as
    out of step (v5+f6e76382 vs v5+41cd9a05, both built after the last tile
    change, 3cd35b1). The stamp is now the last commit touching src/tile or
    src/common, falling back to HEAD where that history is missing; FW_DIRTY
    still marks uncommitted changes to those paths.
    TILE_FW_VERSION 5 -> 6. Every tile reads out of step until reflashed.
    [fw_version.h]
2026-09-28 row: stamp the last commit that changed the row's sources, not HEAD
    As for the tile: FW_GIT_SHA was HEAD at build time, so rebuilding
    unchanged row firmware after any unrelated commit gave it a new identity
    and the version check flagged it as out of step. It is now the last
    commit touching src/row or src/common, falling back to HEAD where that
    history is missing; FW_DIRTY is unchanged.
    ROW_FW_VERSION 9 -> 10. Every row reads out of step until reflashed.
    [fw_version.h]
2026-09-28 pi: the runner's state names the playing entry by id
    RunnerState.entry_index is a position in the runner's own resolved copy
    of the playlist, which stops matching the database the moment the
    playlist is reordered. entry_id is the playing entry's id, so a page can
    find it in the list as it stands now. None for the idle animation, a
    one-off with no playlist, or nothing loaded.
    [runner.py, test_runner.py]
2026-09-28 pi: row power in the Diagnostics tab's row status
    /api/floor/status now asks each row that answers STATUS for POWER as
    well - one more request per frame boundary - and serves its 12 V rail:
    voltage_mV, current_mA and power_mW, null when POWER goes unanswered. The
    Row status table shows voltage and current. row_status.RowPower decodes
    the reply.
2026-09-28 pi: row power refreshes every 5 s while the row status table is showing
    GET /api/floor/power reads POWER alone from the rows asked for (every row
    if none), one request per frame boundary like the other floor requests.
    While the Diagnostics tab's row status table is on screen - that tab
    selected and the page visible - the page re-reads it every 5 s and folds
    voltage and current into the table, noting when. It asks only the rows
    that answered the last Row status, so a dead row is not asked again and
    never costs a frame. Nothing else in the table changes without a click.
    The active tab moves to state.js so a panel can tell it is showing.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
2026-09-28 pi: rotation tables for turning the picture in 90-degree steps
    FloorGeometry.rotation(k) builds, once per k, the index tables for the
    picture turned k quarter turns clockwise in the canonical view: from
    led_positions rotated about the floor centre, then checked to be a
    one-to-one LED mapping that moves tiles whole. On the square floor that is
    a tile permutation plus a 15-LED turn round each ring per quarter.
    Frame.rotated(k) applies it with one gather; a TileFrame stays a
    TileFrame. Effect.rotated(led_shift, n) turns the parameters that name an
    LED position (POSITIONAL_PARAMS: HUE_SPLIT's offset) round the ring with
    the content. ROTATIONS / quarter_turns() validate the setting's degrees.
    C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
2026-09-28 pi: floor rotation setting, applied by the runner after render
    The runner turns each output frame by the rotation as the last step
    before the fan-out - after crossfades, on the held frame while paused -
    so every sink, the preview included, sees what the floor shows and no
    animation knows about it. Effect writes go to the rotated tile with
    positional parameters turned. The runner keeps the canonical value of
    each effect register it has written, so changing the rotation mid-show
    moves the registers already set and clears the tiles they leave.
    `rotation` is stored like brightness: GET/PATCH /api/settings reads and
    writes it and applies it now via Runner.set_rotation(); RunnerState
    reports it;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
2026-09-28 pi: show controls - speed, freeze, bump, strobe, tint, hue and saturation
    What an operator does to whatever is playing, without knowing what it is.
    engine/overlays.py holds the controls and applies them to the output
    frame after any crossfade and before the rotation, in a fixed order:
    freeze (hold the picture; animations run on underneath), colour
    correction (W3C hue-rotate / saturate matrices on the encoded bytes),
    tint (colourise by luminance in linear light - black stays black), bump
    (a flash toward white fading linearly over decay_s), strobe (the picture
    for one frame per period, dark between, periods counted from when it was
    switched on, held to strobe_max_hz). Each stage is skipped at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
    [overlays.py, runner.py, test_overlays.py, test_runner.py]
2026-09-28 pi: show-control endpoints and the stored strobe cap
    POST /api/transport/{speed,freeze,bump,strobe,tint,hue_shift,
    saturation,reset_show}, each body validated before the runner sees it.
    The controls are live show state and are not stored.
    strobe_max_hz is a stored setting (default 10, at most 15): GET/PATCH
    /api/settings reads and writes it and applies it now; play and serve
    start with it. An invalid stored value reads as the default.
    [cli.py, test_web_playlists.py, test_web_transport.py]
2026-09-28 pi: show controls row in the transport bar
    Speed, strobe, hue shift, saturation and tint sliders that stream while
    dragged (at most ~15 posts a second per control, the last value always
    landing), with Freeze, Bump and Reset buttons. Bump fires on pointer
    down, or on a keyboard press. The row is captioned "Show", and the
    animation's own params row "Animation", since the two can share names.
2026-09-28 pi: layers - one animation composited over whatever plays
    pixels.composite(base, top, mode, amount) combines two frames in linear
    light: add (light on light), max (the brighter), multiply (the top as a
    mask) or mix (the top replaces); amount fades any of them in from the
    base. Two tile frames composite to a tile frame.
    The runner can run one animation as a layer: set_layer(id, params, mode,
    amount), set_layer_blend() to change mode or amount without restarting
    it, clear_layer(). The layer is composited before the show controls, has
    its own clock (so a base transition does not restart it, and it follows
    the show speed), and its tile effect writes are dropped - effects belong
    to the base - wi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
    [pixels.py, runner.py, test_pixels.py, test_runner.py]
2026-09-28 pi: Art-Net and sACN receiver
    interfacing/packets.py parses ArtDmx, ArtSync and ArtPoll, and sACN data
    and sync packets (preview, terminated and non-zero start codes ignored),
    and builds the ArtPollReply the floor owes: one per group of up to four
    universes sharing a Net and Sub-Net, so it appears in a sender's node
    list.
    interfacing/receiver.py listens on UDP 6454 and 5568 (unicast, and the
    multicast group of each sACN universe) on its own thread. Assembler
    turns universes into complete frames per protocol: gated on sync once a
    sender uses it, falling back after 4 s to "every universe has arrived",
    and publishing what there is if a universe repeats first. Frames are
    latest-wins, never queu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
2026-09-28 pi: the External animation and the source control
    decode() turns a received frame into floor pixels: tile and grid in
    raster order from the top-left of the canonical view (the far corner
    from the Pi), grid sampled bilinearly at each LED in linear light, raw
    as chain order. external_animation() is a built-in, id "external", that
    shows the latest frame and holds it between arrivals; the registry gains
    add_builtin() - a built-in survives reloads and a file claiming its id
    is an error.
    ExternalSource applies the operator's source while there is signal -
    external (a one-off takeover), mix (External as the layer in mix mode)
    or internal - and gives the floor back after the timeout. It only undoes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
    [runner.py, test_external_source.py, test_runner.py]
2026-09-28 pi: External input settings, API, LED table and web tab
    ExternalInput builds the receiver and source control from stored
    settings (artnet/sacn enabled and first universe, mode, grid size,
    source, mix, timeout); update() validates the whole change, applies it
    live and stores it. serve runs it unless --no-external. The default
    playlist never includes the built-in.
    GET/PATCH /api/external; GET /api/floor/leds (JSON or CSV) and
    `df2-pi leds` list every LED's position (x, y and 0..1 u, v) and its
    raw-mode universe and channel.
    The web UI gains an External tab: signal status, the source switch and
    mix, and the input settings. The transport-row caption style is scoped
    to those rows - unscoped, it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
2026-09-28 pi: the DMX control block - the floor as a 16-channel desk fixture
    interfacing/dmx_control.py: master dimmer, strobe, source, mix, bank,
    program, speed, macros 1-4, tint RGB and amount, bump. CHANNELS is the
    table; DmxControl acts on changes. Continuous controls also act on the
    first packet after silence, as a fixture follows its faders; triggers
    (bank/program, macros, bump) only on change, so a desk connecting with
    them at 0 neither reloads the playlist nor flashes the floor. After the
    timeout the continuous controls return to their stored settings.
    The receiver hands every packet for the control universe that covers the
    whole block to a callback, as it arrives - a short packet is ignored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
    [cli.py, test_dmx_control.py]
2026-09-29 pi: Comet Squares animation
    Tile squares whose sides slam in one at a time as accelerating comets
    along their rails, hop tile to tile across the grid, then spill apart
    like marbles along the edges leading away from the square.
    Params: squares (count), comet speed, trail length. Added to the starter
    pack and its tests, with a check that a formed square lights a whole
    tile at one colour.
2026-09-29 pi: break the playlists.store <-> engine import cycle
    playlists/store.py imports engine.overlays, which runs engine/__init__,
    which imports engine.runner, which imported playlists.store back while it
    was still half-initialized. Importing df2_pi.playlists first (as
    test_starter_pack.py does when run alone) failed at collection; the full
    suite only passed because an earlier test imported df2_pi.engine first.
    The runner uses PlaylistStore/ResolvedEntry/ResolvedPlaylist only in
    annotations (it has `from __future__ import annotations`), so the import
    moves under TYPE_CHECKING.
    [runner.py]
2026-09-30 pi: Twin Peaks animation
    The Red Room's curtains: red pleated drapes shaded across the whole
    floor from led_positions. A cosine across x makes the pleats, never
    darker than deep red; a sideways displacement that grows toward the hem
    animates them - a slow sway, a ripple climbing from hem to rod, and
    random gusts that send a burst of ripples up a stretch of curtain. The
    lamp occasionally dips, once or in a stutter.
    Added to the starter pack, with a test that every LED stays lit and red
    dominates. Listed in docs/animations.md as the example of shading a
    surface rather than drawing lines.
2026-09-30 pi: run the floor as a systemd service (#96)
    deploy/df2-pi.service runs `df2-pi serve` as garth on boot and restarts it
    2 s after it exits. TimeoutStopSec outlasts the app's shutdown blackout,
    so a stop or restart leaves the floor dark rather than frozen. It orders
    after network.target, not network-online.target: the floor needs no
    network, and waiting for one could hold it dark. deploy/install.sh copies
    and enables it (idempotent, --dry-run, never starts the floor itself),
    reading the user and paths from the unit.
    serve gains --realtime, as play has. The clock now logs what scheduling
    it actually got, and observer sink threads drop the SCHED_FIFO they
    inherit from the render thread, so onl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
2026-09-30 pi: skip the shipped-fixture comparison where docs/ isn't present
    Only src/pi is synced to the bench Pi, so the repo-root
    docs/fixtures/dance-floor-v2.qxf doesn't exist there and the test died
    with FileNotFoundError. Split it: the channel-table checks still run
    everywhere, the file comparison skips when the file is absent.
    [test_dmx_control.py]
2026-10-01 pi: Spiral, ported from the v1 floor
    v1's processor/spiral.py as a tile animation: a 64-colour train wound
    out from the middle along v1's spiral order, the hue drifting and jumping
    to its triad partners on the palette's rhythm. Rows flipped so it looks
    as it did on v1; palettes 0-3 become named choices; steps are clocked by
    ctx.t (Steps per second, default v1's 24) instead of once per frame.
    Added to the starter pack, with a test that every step moves each colour
    exactly one tile outward along the path.
    [test_starter_pack.py]
2026-10-01 pi: Hold - stop the countdown while the animation plays on
    Runner.hold(on) / POST /api/transport/hold stops the countdown of
    whatever is playing: each frame moves the countdown's start along with
    the clock, so elapsed and remaining stand still while the animation's
    own clock runs. Released, it carries on from where it stood and the
    playlist advances at zero as usual. A crossfade under way finishes
    first; the hold carries over a skip; it composes with pause.
    The web UI gets a Hold toggle (a stopwatch with pause bars) beside Next,
    and shows a held countdown in amber, with "held" beside Remaining and on
    the playing playlist row.
    Also: while paused, the state reported elapsed and remaining sti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
    [runner.py, test_runner.py, test_web_transport.py]
2026-10-01 pi: Hold on DMX control channel 17
    Appended, so channels 1-16 keep their meaning. 0-127 runs, 128-255
    holds; it acts when it crosses 128, and on a first packet only to hold,
    so a desk connecting with it down does not release a web UI hold. When
    the desk goes quiet, a hold it applied is released. QLC+ fixture
    regenerated; docs and the External tab say 17 channels.
    [test_dmx_control.py, test_web_external.py]
2026-10-01 pi: the beat model - Link, MIDI clock and tap tempo sources (#125)
    BeatClock turns a source's reading into a BeatInfo for a frame's latch
    moment plus a latency offset, applying the 1/2x/1x/2x multiplier, nudge
    and resync, and fires downbeat on exactly one frame per bar. Sources:
    Ableton Link via aalink (on its own asyncio thread; no peers is no
    beat), MIDI clock (a least-squares fit over four beats of ticks; the bar
    known after Start or Song Position), and tap tempo (mean of the last four
    taps, the last one beat 1). BeatInfo grows to the spec's fields.
    aalink is a new optional extra, [beat], included in [dev].
2026-10-01 pi: ctx.beat for every render, and quantized launches (#125)
    The runner reads its BeatClock once per tick at tick.deadline and every
    animation rendered that tick sees the same ctx.beat. With launch_quantum
    at beat or bar, goto/next/previous/loads/one-offs wait and land on the
    frame that crosses the boundary, in order; with no beat they go at once,
    and bar falls back to the beat while the bar is unknown. RunnerState
    reports beat, launch_quantum and launch_pending. load_playlist takes
    quantize=False for loads that are not an operator's launch.
2026-10-01 pi: beat sync settings, API and UI (#125)
    BeatService owns the source and its stored settings (source, beats per
    bar, multiplier, latency offset, launch quantum), applied live. /api/beat
    serves and changes them, with tap, resync and nudge. The External tab
    gets a Beat sync section; the transport bar shows the tempo with a lamp
    per beat of the bar (run locally between polls), a Tap button in tap
    mode, and when a launch is waiting. The startup playlist load is not
    quantized. NumberField moves to params.js to be shared.
2026-10-01 pi: Checkerboard flips on the beat; beat sync docs (#125)
    [test_starter_pack.py]
2026-10-01 pi: Stardust - an ambient night sky
    A slow, dim space animation mixing tile and LED scales: a nebula of
    per-tile colours from drifting wave fields (deep blue, violet, teal,
    darker voids), single-LED stars that swell and fade, and novae - a tile
    warms to a pale glow, then crumbles from its corners into dust that
    drifts out along the edges leading away, slowing and cooling into the
    nebula's colour as it fades.
    The sky never goes dark (the floor shows black poorly). Added to the
    starter pack, with a test that it never does and that a nova glows a
    whole tile and then scatters.
    [test_starter_pack.py]
2026-10-01 pi: Stripes, ported from the v1 floor
    v1's processor/stripes.py as a tile animation: each row a palette colour
    fading 1/n either side of its peak, sliding through at its own speed and
    direction, replaced when it has passed. v1's palettes verbatim, `random`
    picking one per run as v1 did.
    v1 drove its LEDs with linear values, so the stripe is built in linear
    light and encoded with gamma.from_linear() - the tails are as dim as
    they were. Rows flipped to v1's top-down order; v1's per-frame speeds at
    24 fps become steps per second, scaled by Speed; v1's `length` option is
    the Fade length param.
    [test_starter_pack.py]
2026-10-01 pi: beat time and tempo-locked waveforms (#126)
    ctx.t_beats is the beat source's position (beat + phase) when there is
    one, else the animation's own time at a fallback tempo, so anything
    written against it runs sensibly either way. df2_pi.tempo adds lfo()
    (sine, tri, saw, square, ramp_down; rate in cycles per beat) and pulse()
    (1 on the beat, exponential decay), pure functions returning 0..1 that
    take arrays as well as scalars, so they compose with #127's phase maps.
    FrameContext also carries ctx.triggers, and Trigger(slot, velocity,
    age_s) joins the animation package.
2026-10-01 pi: triggers, and the fallback tempo, in the runner (#126)
    Runner.trigger(slot, velocity), from any thread: the hit reaches every
    animation rendered on the next frame that renders - current, outgoing,
    layer, so a crossfade's incoming animation sees it - and no frame after.
    A pause holds hits for the frame after it. age_s is measured to the
    frame's latch on the clock's timebase (FrameClock.now(), now public).
    set_fallback_bpm() sets the tempo t_beats runs at without a beat.
2026-10-01 pi: trigger API and pads; fallback tempo setting (#126)
    POST /api/transport/trigger {slot, velocity}. The transport bar shows
    eight trigger pads while an animation that declares triggers=True plays
    (slots 0-7; all 16 open to the API). fallback_bpm joins the stored beat
    settings, applied to the runner, and the Beat sync section's 'Tempo
    without a source' field.
2026-10-01 pi: Rainbow Sweep on beat time, Ripple on triggers; docs (#126)
    The two reference animations for the authoring guide: Rainbow Sweep
    sweeps once per two bars of t_beats and pumps on the beat with pulse()
    (new Pump param, default 0.3); Ripple drops a ring for each trigger, the
    slot picking a spot on a 4x4 grid and the velocity its brightness.
    animations.md covers t_beats, the waveforms and triggers.
2026-10-02 pi: phase maps - console-style waves, fans and chases (#127)
    df2_pi.phase: per-tile (rows, cols) or per-LED (tiles, 60) offsets in
    0..1 for rows, cols, diagonal, radial, angle (0 due north, clockwise),
    checker, random (drawn once per generator, so ctx.np_rng gives a map
    stable for the run) and perimeter (chain index round each tile's ring -
    what ledwalk lights in order). Options: spread, reverse, and mirror,
    which is spatial - symmetric about the floor's centre - per map. Base
    maps cached per geometry; callers get fresh arrays.
    [phase.py, test_phase.py]
2026-10-02 pi: Waves - a tempo waveform run across a phase map (#127)
    The starter animation for phase maps: pick a map, a waveform, cycles per
    beat, spread, mirror, reverse and resolution; on beat time, so it locks
    to a beat source and runs at the fallback tempo without. Tile resolution
    keeps each tile one colour; perimeter is always per LED. The authoring
    guide gains a phase maps section.
    [test_starter_pack.py]
2026-10-02 pi: the shared floor palette, and ctx.palette (#128)
    Palette: 2..8 stops spaced round a loop, at(u) wrapping and taking
    arrays, blended in linear light. A built-in library (rainbow - the
    default - fire, ice, ocean, sunset, forest, neon, candy, night), and
    PaletteBook: the library plus user palettes stored as JSON in the
    settings table, and which one is active, pushed to the runner.
    Runner.set_palette() makes it ctx.palette from the next frame;
    RunnerState reports its name. palette_param() is how an animation opts
    in - 'floor' follows the active palette - and choice() resolves it.
    palette.py imports Param only inside palette_param(), since the
    animation package imports palette.py: no imports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
    [palette.py, runner.py, test_runner.py]
2026-10-02 pi: palette on DMX control channel 18 (#128)
    Appended, so 1-17 keep their meaning. Palette N in the book's order -
    built-ins, then the user's by name - acting on change only, like bank. The
    QLC+ fixture is regenerated, with the built-ins named as capabilities.
    [test_dmx_control.py]
2026-10-02 pi: video clip import - df2-pi video import / list
    Decodes a video with imageio (mp4, mov, gif...), crops a square (the
    largest centred one by default, or --crop CX,CY,SIZE), averages each frame
    down to the 136x136 cell grid in linear light and keeps the 3,840 LED
    cells, sampled at --fps (15) from --start for --duration. Writes
    <name>.clip.npz to the media directory: src/pi/media (or $DF2_MEDIA),
    which sync-to-pi.sh carries to the Pi and git ignores. The top of the
    video is the top of the floor as displayed. Loading is cached and picks
    up a re-import. Import needs the [preview] extra; playback needs nothing.
2026-10-02 pi: Video - play imported clips on the floor
    Blends stored frames in linear light, so slow playback stays smooth;
    crossfades the clip's end into its start so the loop has no seam; Contrast,
    Black level (dark footage on LEDs reads as dead tiles), Brightness and
    Rotation. Clips are listed when the animation loads; with none it shows
    a dim breathing wash. The authoring guide covers importing.
2026-10-02 pi: Waterline - the water's surface across the floor, tile by tile
    Each tile column is a point on the surface with a height and velocity:
    pulled toward a water level that rises and falls with a slow tide,
    pushed by a swell whose strength waxes and wanes, kicked now and then,
    damped, and held to its neighbours by a pull that grows with the gap but
    levels off (tanh) - so the line stays smooth unless a column moves fast
    enough to break away. The surface is drawn across the two rows it sits
    between, over the depths in a second palette colour fading to black at
    the bottom row. Palette defaults to ocean.
2026-10-02 pi: Lightning comes down the floor and forks near the ground
    Bolts were bunched and curled at the top: each began on a top-row tile's
    north edge (a run along the top wall) and was a free random walk that
    could double back upward, with forks equally likely anywhere along it.
    Now a bolt leaves a corner on the top wall heading straight down, and at
    each corner goes down again or jogs sideways (Turn bias), never up,
    ending where it meets the bottom. A span is used once, both seam halves.
    Forks leave from corners weighted by the square of how far along the
    trunk they are - none in the first fifth - and descend the same way,
    slightly more jagged, never crossing the trunk. Over 500 strikes no bolt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
2026-10-02 pi: OSC control surface (#132)
    The floor's controls as /floor/... OSC addresses, mapped the way the DMX
    control block maps a fader (speed 0.5 normal, source in thirds): show
    controls, source and mix, playlist navigation, play by animation id,
    palette, the playing animation's params (via Param.from_unit) and macros,
    triggers and tempo. Every address a sender only triggers also has a form
    with its target in the path (/floor/palette/ocean), for senders like
    Resolume that choose the address but not the value.
    Presses fire on a rise to 0.5 or a high value more than 0.3 s after the
    last, so 1-then-0 buttons, senders that only send 1, and senders repeating
    1 every frame all behave. /floor/subscrib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
2026-10-02 pi: OSC in serve, its settings API and the External tab monitor (#132)
    serve runs the OSC server on UDP 7000 by default (osc_enabled, osc_port
    settings, changed live through PATCH /api/osc). The External tab gains
    an OSC section: on/off, the port, listening status, and the last 20
    messages with sender and any error - what a sender is actually sending.
    python-osc joins the [web] extra.
    [cli.py]
2026-10-02 pi: MIDI input - mapping, 14-bit CCs, bank/program, clock, learn (#131)
    mido over python-rtmidi: every input port but Midi Through, re-scanned
    every 2 s for hot-plug. A YAML mapping binds notes, CCs and 14-bit pairs
    to /floor/... addresses, with toggle, fixed value, channel and port
    options; Program Change with Bank Select loads playlist bank and goes to
    entry program (quantized); MIDI clock feeds beat sync. The file lives
    beside the database (sync --delete would wipe one in ~/dance-floor), is
    created from the APC mini default (mk1 and mk2, 81 bindings), re-read on
    change, and a broken edit keeps the last good map. MIDI learn binds the
    next control moved and saves.
    A new [midi] extra (mido,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
    [test_midi.py]
2026-10-02 pi: MIDI in serve, its API and UI; MIDI clock as a beat source (#131)
    serve starts MIDI with the app (midi_enabled setting). /api/midi serves
    status and the mapping, toggles input, arms and cancels learn, removes
    bindings and restores the APC mini default. The External tab gains a MIDI
    section: devices, learn, a monitor of messages and what each did, and
    the bindings. 'MIDI clock' joins the beat sources (#125 left it for
    this).
    [cli.py, test_web_beat.py]
2026-10-05 pi: Comet Train - comets nose to tail on every edge, pulsing on the beat and turning 90 degrees together
    Every edge running one way carries a 15-LED comet, a near-white head and
    a palette tail fading to black. Each pulse (1 beat by default) slams the
    whole train one tile side on; now and then a pulse turns every comet round
    the corner its head is at instead, onto the perpendicular edges, so a
    horizontal flow pulses into a vertical one. The floor is a window onto an
    endless lattice: comets leave at one side and enter at the other, and a
    turn maps the two lanes at each grid line inside-to-inside.
2026-10-05 pi: Comet Train steps a few LEDs a pulse and turns corners LED by LED
    Pulses now move the train 1, 3 (default), 5 or 15 LEDs - divisors of a
    tile side, so the heads keep landing on the corners - and a turn only
    starts from a corner. A turn runs every comet round its corner at an even
    pace over most of a pulse (Turn time), the tail following the head round,
    instead of easing the whole 15 LEDs in at once. Colours are kept for a
    ring of edges just off the floor, so a comet part way on keeps its colour
    from pulse to pulse.
2026-10-05 pi: Switchyard - Comet Train until the corners throw switches (experimental)
    Runs as Comet Train for an Interval, then throws switches one corner at a
    time: comets reaching that corner on that line turn there for good. A
    turned stream swaps with each stream it crosses (they turn onto its
    heading and it takes their place), spreading a corner per tile side, and
    the edges a switch starved are fed by comets born at the corner behind it.
    After Switches of them they come out again in reverse order, back to a
    uniform floor.
    Built on a lattice of corners and links - a flow per link, a route per
    corner, one-to-one - so comets never double up on a lane; births and
    endings at corners also cover comets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
    [test_starter_pack.py]
2026-10-05 pi: Switchyard re-routes as a map of streams that never cross
    A switch no longer feeds the corner it turns at, or swaps with the lines
    it crosses. The map is now one way in and one way out at every tile
    corner, streams running from the floor's edge to the floor's edge. A
    switch turns its stream and runs it to the edge; each line that would
    cross it turns the same way a corner earlier, giving a diagonal of turns
    on the near side. The lines cut off on the far side are fed from the
    floor's edge, each turning back onto its line a corner before the one
    below it - the second diagonal - with the edge after the switch left
    empty. Below is untouched.
    When the map changes, whatever arrives at a corne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
    [test_starter_pack.py]
2026-10-05 web: stop iOS Safari zooming on quick taps of the Tap tempo buttons
    Two taps in quick succession on Tap (the External tab's and the transport
    bar's) were read as a double-tap zoom. touch-action: manipulation keeps
    pinch zoom but drops double-tap zoom on those buttons; user-select: none
    stops a long press selecting the label.
2026-10-07 pi: Switchyard turns take one beat, not a Turn time
    Turn time was a fraction of the pulse (0.9 by default), so a turn ended
    just before the beat - and at 2 or 4 beats per pulse, part way through
    one - pulling the comets off the beat. A turn now runs over exactly one
    beat from the pulse it starts on (the whole pulse at 1/2 beat per pulse),
    so it lands on the beat. The Turn time control is gone.
2026-10-07 pi: Comet Train turns take one beat too
    The same change as Switchyard: Turn time is gone and a turn runs over
    exactly one beat from the pulse it starts on (the whole pulse at 1/2 beat
    per pulse), so it lands on the beat. The one-beat test now covers both;
    two Comet Train tests that sampled the floor just before the beat sample
    it on the beat instead.
2026-10-07 pi: move Switchyard's map engine into df2_pi.streams
    The lattice, the map (switches, feeds, consistency) and the comets running
    on it - phases, segments, drawing - move to a library module, so another
    animation can drive the same engine with different motion. Switchyard
    keeps only its beat-stepped motion; its output is unchanged, frame for
    frame. draw() gains a brightness gain.
2026-10-07 pi: Switchyard Flow - the map of currents with gliding comets that flash on the beat
    Switchyard's engine with different motion: the comets run continuously at
    Speed (LEDs/s), round corners and through switches without stopping, and
    the beat is in their brightness - a flash to full on every pulse, fading
    to the Between pulses level.
2026-10-20 pi: document the UART overlays without ctsrts
    RowBus drives each chain's XDIR as a plain GPIO even though the pins sit on
    the UARTs' RTS lines. `ctsrts` muxes GPIO17/GPIO7 to the UART, and since
    kernel 6.18 (Raspberry Pi OS trixie) the RP1 pin controller refuses the
    GPIO claim, so df2-pi exits at startup with lgpio.error 'unexpected error'.
    Bookworm's 6.12 kernel let the claim through, which is why the documented
    config used to work. The Pi now runs `dtparam=uart0=on` and
    `dtoverlay=uart2-pi5`.
2026-10-21 pi: a playlist entry can carry a layer (schema v2)
    Migration 1 -> 2 adds playlist_entry.layer_json: another animation to
    composite over the entry - animation_id, params (diffed against its
    defaults, as an entry's are), blend mode and amount - or NULL for none.
    add_entry/update_entry take a layer (None removes it) and validate it on
    write; resolve() binds it as a ResolvedLayer, and a layer whose animation
    is missing resolves with an error and a warning while its entry still
    plays. Parameter clamping is shared between the two.
2026-10-21 pi: the runner plays an entry's layer with its entry
    An entry's layer starts with the entry and is composited onto that
    entry's own frame, so it crossfades in and out with it, under the
    runner's own layer; it ends with the entry. One that raises is removed
    and the entry plays on. RunnerState.entry_layer names it. Rendering a
    layer is shared with the runner's own layer.
